HomeboiWoods/403-ecen-cobot/403/Sponsor Syncs/Sync 1 - Images/IMG_6879.JPG

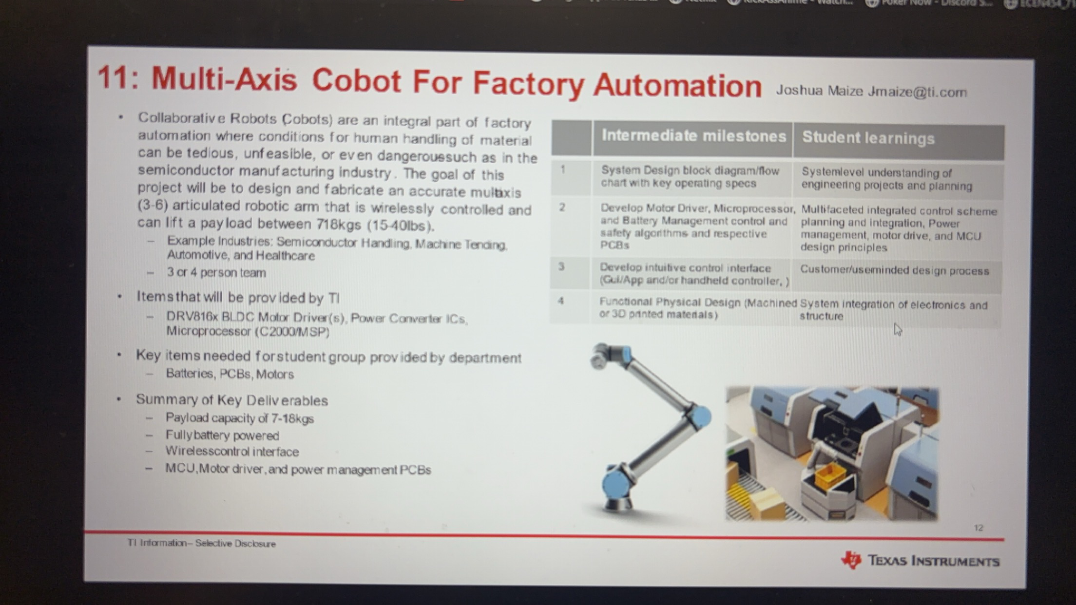
403/Sponsor Syncs/Sync 1 - Images/IMG_6879.JPG
