HomeboiWoods/403-ecen-cobot/README.md

# README.md

Howdy, this is ECEN 403/404 Team 42's Github Repository for the Multi-Axis Cobot for Factory Automation Capstone Project
