HomeboiWoods/403-ecen-cobot/404/Documents/Final Report/403 Final Report, Team 42.docx

42: Multi-Axis Cobot For Factory Automation

Adrian Guzman, Emily Hamsa, Ethan Woods, Jaishil Shah

CONCEPT OF OPERATIONS

REVISION – 2

5 December 2024

CONCEPT OF OPERATIONS

FOR

42: Multi-Axis Cobot For Factory Automation

TEAM <42>

APPROVED BY:

_____________________________

Project Leader Date

_____________________________

Prof. Kalafatis Date

_____________________________

T/A Date

I

Concept of Operations Revision - 1

42: Multi-Axis Cobot For Factory Automation

Change Record

Rev. | Date | Originator | Approvals | Description
0 | 9/12/2024 | All Members | All Members | Draft Release - Revision 0
1 | 9/26/2024 | All Members | All Members | Changed MCU selection in Section 3.6
2 | 12/5/2024 | All Members | All Members | Updated team name to 42

II

Concept of Operations Revision - 1

42: Multi-Axis Cobot For Factory Automation

1.1.

1.2. Table of Contents

Table of Contents III List of Tables IV Table 1 - Cobot Segment Degrees of Rotation 3 Table 2 - Cost Analysis 5 List of Figures IV Figure 1 - Multi-Axis Cobot Block Diagram 2 Figure 2 - Cobot Prototype Diagram 3 Figure 3 - Subsystem Flow Chart 6 1. Executive Summary 1 2. Introduction 1 2.1. Background 2 2.2. Overview 2 2.3. Referenced Documents and Standards 4 3. Operating Concept 4 3.1. Scope 4 3.2. Operational Description and Constraints 4 3.3. System Description 5 3.4. Modes of Operations 6 3.5. Users 6 3.6. Support 7 4. Scenario(s) 7 4.1. Transporting and Using Small Objects or Tools 7 4.2. Unpredictable Factory Environment 8 5. Analysis 8 5.1. Summary of Proposed Improvements 8 5.2. Disadvantages and Limitations 9 5.3. Alternatives 9 5.4. Impact 9

III

Concept of Operations Revision - 1

42: Multi-Axis Cobot For Factory Automation

1.3. List of Tables

Table 1 - Cobot Segment Degrees of Rotation 3 Table 2 - Cost Analysis 5

1.4. List of Figures

Figure 1 - Multi-Axis Cobot Block Diagram 2 Figure 2 - Cobot Prototype Diagram 3 Figure 3 - Subsystem Flow Chart 6

IV

Concept of Operations Revision - 1

42: Multi-Axis Cobot For Factory Automation

2. Executive Summary

In many manufacturing industries, safety and efficiency are critical to ensure a smooth operation within a fabrication facility (fabs) or working environment. Fabs have heavy machinery and moving parts, making it difficult for humans to access certain places. To aid the workforce, collaborative robots (cobots) are deployed within factories allowing human control from safe distances. Cobots range in size, and application, and help streamline processes within manufacturing. This solution will protect human lives and reduce inefficiencies in labor by eliminating the process of entering a hostile or hazardous work environment.

This project aims to develop a multi-axis collaborative robot (cobot) that replaces manual human intervention with remote control, reducing the risk of injury and fatigue while improving efficiency in factory settings. The cobot will assist with light tasks such as lifting small loads (1-2 lbs), transporting items between locations, and providing precise movement control through a wireless app. Key software tools for the design and development include Altium, CCStudio, AutoCAD, and VSCode (with Swift). The cobot's hardware will feature a C2000x MCU and multiple B161x motor drivers to ensure reliable operation.

Versatility is a big focus of the cobot’s design, and thus we are including the ability to lift a small object or lightweight box using the pincher arm. The cobot will be battery-powered with rechargeable batteries, with a voltage supply range of 24-48V. Additionally, a wireless app will be developed for precise control of the cobot’s movements. To maximize its range of motion, the cobot will contain 5 axes of rotation supporting both 180° and 360°. Internally, the cobot will be driven through TI’s best-in-class C2000™ MCUs, power ICs, and motor drivers, ensuring precise motor control.

3. Introduction

Factories and commercial industries use cobots to perform tasks that are unsafe and require numerous movements that would be considered strenuous for humans. Thus, the goal of this cobot is to make the production process safer and more efficient. For this project, we are developing a multi-axis cobot that will facilitate the movement of different loads across a factory or commercial setting. The cobot will be wirelessly connected using a mobile device, battery-powered, and support loads of 1-2 lbs. Considering that many warehouses have safety regulations and guidelines to follow, this cobot is designed with many of these in mind. Thus, this project’s main focus is to develop an operational cobot that could be placed in a factory setting to complete tasks safely and in a time-oriented manner.

1

Concept of Operations Revision - 1

42: Multi-Axis Cobot For Factory Automation

3.1. Background

Collaborative robots, also known as cobots, are a crucial component in factory settings where safety is at the utmost priority and manual labor is considered too dangerous. By having the cobot function through remote control, we can increase the safety and efficiency of workers in these industrial settings, where small tasks could be performed by these cobots rather than human workers. This project aims to develop a multi-axial cobot that can lift a load of 1-2 lbs through a wireless connection.

3.2. Overview

1. Designing a block diagram and flow chart including the key operating specifications. 2. Develop the motor driver, microprocessor, power supply, and battery management control with safety systems, and respective PCBs for each.

3. Develop a user interface to control the cobot in the form of a wireless app. 4. Develop the physical design of the cobot, including the machine and any 3D-printed parts.

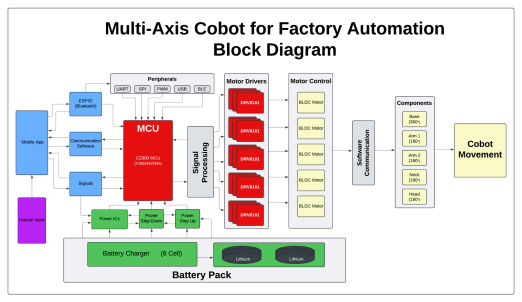
[picture p7: figure]

3.3. Figure 1. Multi-Axis Cobot Block Diagram

2

Concept of Operations Revision - 1 42: Multi-Axis Cobot For Factory Automation

Segment Piece | Degree of Rotation
Base | 360°
Arm 1 | 180°
Arm 2 | 180°
Neck | 360° or 180°
Head | 180°

3.4.

3.5.

3.6. Table 1. Cobot Segment Degrees of Rotation

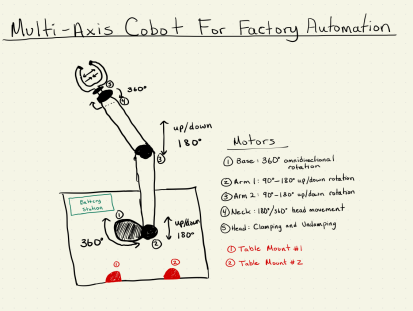
[picture p8: figure]

3.7. Figure 2. Cobot Prototype Diagram

3

Concept of Operations Revision - 1

42: Multi-Axis Cobot For Factory Automation

3.8. Referenced Documents and Standards

Project Outline: Project Description

MCU Documentation

1. C2000 MCU Documentation: F280049CPZS

2. C2000 Evaluation Module: LAUNCHXL-F280049C - EVM (C2000 Evaluation Module)

Motor Driver Documentation

DRV816x Motor Driver Documentation: DRV816x 100V Half-Bridge Smart Gate Driver DRV8161 Evaluation Module: DRV8161 EVM

Wireless Control Documentation

ESP 32 Documentation: ESP 32 Technical Reference Manual

Swift Programming Course: Swift Programming Fundamentals

Motor Documentation - TBD

Battery Documentation - TBD

Physical Design Documentation - TBD

Standards Documentation - TBD

4. Operating Concept

4.1. Scope

This project involves the design and fabrication of a human-controlled, multi-axis collaborative robot (cobot) for use in a variety of manufacturing and commercial environments. The cobot will assist employees by improving efficiency in both strenuous tasks, such as moving boxes, and precise tasks, like handling small loads and assembling items. Operated remotely and equipped with a pincher-style head, it is designed to enhance productivity in diverse settings, performing repetitive and labor-intensive duties that benefit from human oversight and precision.

4.2. Operational Description and Constraints

The cobot will work wirelessly in commercial industries as well as factory settings performing tasks such as moving boxes and small loads, and the operator will use an app to control the cobot. The claw attachment will be used for precise tasks such as moving small objects and loading boxes, as well as moving small boxes between locations. It will move on multiple axes, ranging from 180 degrees to 360 degrees of rotation at each joint, and will be powered by a rechargeable battery.

One constraint of this project is the weight constraints on the load the cobot can lift. The design is only specified to operate in lifting loads up to 2 pounds. The radius of its reach is another constraint, as it will only be able to reach 2 feet from its base. Design

4

Concept of Operations Revision - 1

42: Multi-Axis Cobot For Factory Automation

constraints will also need to be accounted for. There is a limited budget of $400, and a limited time frame to complete the design.

This cobot has applications in many industries, including the semiconductor, automotive, medical industries. This cobot could be modified to lift and move wafers in a semiconductor clean room setting. Being able to lift boxes would aid employees in the automotive field when building cars, and would be able to precisely move and place lighter metal parts. In the medical industry, the cobot would be able to use its precision for moving small tools such as tweezers or scalpels, assisting doctors during surgery.

Product | Quantity | Cost
EVM Board (MCU) | 2 | $78.00
Microprocessor Unit | 2 | $17.89
Bluetooth Driver | 1 | $19.99
EVM Board (Motor Drivers) | 1 | $229.00
Motor Driver Chip | 5 | $5.66
Anti Static Wrist Strap | 2 | $13.98
Robotic Arm Pincher | 1 | $26.99
SUM: | | $391.51

4.3. Table 2. Cost Analysis (To be updated)

4.4. System Description

The system will be split into four subsystems: power and battery management, MCU and processing design, wireless connectivity and interface development, and motor driving system design. The physical construction of the cobot will be divided amongst team members equally in a 25% share.

The power and battery management system covers the design of the power PCB which will deliver power to the motor drivers, motors, MCU, Bluetooth systems, and other electrical components. On the battery management side, this system will cover the selection of a battery and the design of a battery charger. This system will also account for possible faults and implement safeguards to protect the system.

The MCU and processing subsystem are responsible for the MCU PCB design, ESP32 Bluetooth integration, and communication between the MCU and motor driver. This subsystem will use Altium to design schematics and build physical hardware using the C2000 MCU. Furthermore, the MCU/Processing & Motor Driving subsystems will work closely to align on signal communication between the MCU and motor driver.

The wireless connectivity and interface system consists of a mobile application and a Bluetooth connection that allows communication between the cobot and the device sending in the inputs. The mobile application will be developed using Swift and will be compatible with any iOS device, including iPad and iPhone. It will allow the user to control all movements seamlessly and wirelessly. The Bluetooth driver, an ESP-32, will connect

5

Concept of Operations Revision - 1

42: Multi-Axis Cobot For Factory Automation

directly to the MCU and allow the C2000 to take the inputs from the mobile device and convert them into outputs performed by the cobot. Since we are using a Bluetooth interface, the multi-device connection is compatible and allows any device to connect.

The motor driving design system will create the motor and motor driver PCB. This system will also create the signals needed to effectively operate the motors, which will be Brushless DC (BLDC) motors. This system will achieve the operation of two motors, a 360° and 180° motor controlled by the 8161x TI Motor Drivers. The motor drivers will read a signal from the C2000 MCU and spin/rotate as needed based on the signal. This will all be driven through the B161EVM before integration.

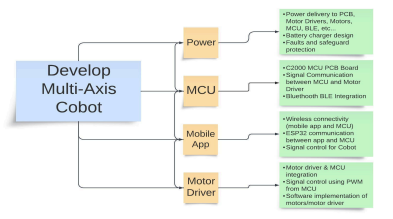
[picture p9: figure]

4.5. Figure 3. Subsystem Flow Chart

4.6. Modes of Operations

The cobot operates in three distinct modes. In the first mode, it uses its pincher to handle and pick up smaller objects in areas where employees may be present, though their presence is not required as the cobot is remotely controlled. The second mode involves lifting, moving, and placing down objects or boxes, as well as tasks such as using tools or adding items to boxes. The third mode is the charging state, where the cobot recharges its power.

4.7. Users

The target user for this cobot is a factory employee who performs redundant, strenuous tasks such as moving boxes from one place to another, transferring small objects, working with small tools, and loading boxes. These employees will benefit from using the cobot as they will be able to stay outside of dangerous areas to operate the cobot, removing the need to follow protocols to enter. Users will also be able to operate this cobot in areas amongst other employees to complete tasks like moving small loads and boxes.

6

Concept of Operations Revision - 1

42: Multi-Axis Cobot For Factory Automation

Training will be required to use this cobot. Basic UI training will need to be completed to understand the functionality of the app, as well as training on using the Bluetooth features. Safety training will also be required to ensure standards are met for using a cobot in a factory setting. Understanding the cobot’s thresholds, such as weight limits, is another important piece of training that will be needed before the operator can begin using the cobot. If the operator plans to use the cobot in areas with other employees, additional training regarding the safety of operation amongst humans may be required to ensure safety on the factory floor.

4.8. Support

Operators will be given a “crash course” on using the mobile application. In-person training on safety standards and operating conditions will also be provided, which will include weight management, operating radius, axis movement, claw operation, and other operating constraints. Operation in areas with other employees will also require additional training. Training on how to repair any damage to the equipment will be provided, as well.

5. Scenario(s)

5.1. Transporting and Using Small Objects or Tools

In this scenario, the cobot will be used in an environment where it will have the ability to operate in freedom alongside other human workers, with the goal of moving a small, lightweight object from one location to another. As the cobot is human operated, the primary objective is to transport the item without damaging or breaking it. The human operator must also be aware of the surroundings within the working environment in the case of external human intervention.

The cobot will be equipped with a set of pinchers or clamps with rubber pads attached to the end. It will be able to handle these objects with precision and full range of motion as it lifts the item up. The items the cobot can handle range from 1-2 pounds, such as light tools, food items, loose parts, and small plastic pieces.

The cobot has a hard time picking up flat items using its clamps, so the items would already be upright and ready to grab by the operator. Once picked up, the operator would be able to freely move the object with 360° of rotation and place it down or use the item at a secondary location, within the range of the cobot. This could be as easy as moving an object from one place to another to placing small objects inside bigger boxes.

From an operational point of view, a human operator will control the robot via remote control, responsible for all aspects of its movement and functionality. This includes tasks such as placing and charging the battery, as well as ensuring precise control during the cobot’s movements. As the cobot is not autonomous, it requires a skilled human operator to handle the objects with the necessary precision and accuracy they need, alongside constant monitoring of the surroundings around the cobot, as to not injure or interfere with other workers.

7

Concept of Operations Revision - 1

42: Multi-Axis Cobot For Factory Automation

5.2. Unpredictable Factory Environment

In this scenario, the cobot will be used in an environment where working conditions are dangerous for humans, such as hazardous and high-risk spaces. The cobot is human-operated, allowing for the pickup and placement of small, lightweight objects in areas where humans cannot operate safely.

The cobot will be equipped with pinchers or clamps that have rubber pads attached to the ends, allowing it to handle items with precision and care. These objects, weighing between 1-2 pounds, could include small objects that are potentially hazardous to humans. The cobot would struggle with flat items on a surface, so ideally the items are positioned upright already.

Once the object is picked up, the cobot can be rotated 360°, giving the operator full control to transport the item to another location or use it within the workspace. Tasks may range from moving items from one place to another, placing them in larger containers, or completing small assembly tasks. The human operator is responsible for controlling all aspects of the cobot’s movement via remote control, ensuring precise handling of objects and monitoring the surroundings to avoid accidents or collisions.

The cobot is not autonomous and relies entirely on a skilled human operator who ensures that tasks are performed safely and efficiently. This operator also manages the cobot's battery charging, positioning, and any other maintenance required to keep it operational. The use of the cobot in this environment significantly reduces risks for human workers while maintaining the efficiency needed for object handling tasks in hazardous conditions.

6. Analysis

6.1. Summary of Proposed Improvements

The multi-axis collaborative robot (cobot) introduces significant enhancements in safety, efficiency, and cost-effectiveness within warehouse and factory environments. By integrating a wireless user interface, the system minimizes direct human involvement, prioritizing worker safety and reducing potential hazards. The cobot’s ability to operate with five degrees of rotation enables it to handle and move objects weighing up to 2 lbs with high precision and efficiency. This capability streamlines repetitive tasks, reduces manual labor, and enhances overall operational productivity. Additionally, the cobot’s design contributes to cost savings by optimizing task performance and reducing the need for manual intervention in potentially risky environments.

8

Concept of Operations Revision - 1

42: Multi-Axis Cobot For Factory Automation

6.2. Disadvantages and Limitations

Some limitations of our design include a carrying capacity of 1-2 lbs and an operational range of 2 feet from the base of the cobot. Additionally, due to the size and shape of our pincher mechanism, objects that are flat with little height off the ground will not be supported by the cobot. Since we are catering to industries which may have limited factory space, the range of motion must be precise in order to prevent damage to warehouse equipment and the cobot. One disadvantage of our design is the power supplied to the cobot. Since we are not connecting this machine to direct power but rather connecting a battery, the usage of the cobot will be limited to the duration of the 8-cell battery and the extra rechargeable batteries. To utilize the machine after a full day of use, the batteries must be recharged and plugged back into the machine.

6.3. Alternatives

Some alternate solutions we proposed include a physical controller and a combined cobot head that incorporates a hook and a pinching mechanism. With the physical controller, the benefit is that it would be easier to use, however, the drawbacks are lengthy enough to conclude that it is an inefficient proposition. With a dedicated controller with physical analog inputs, there would be a level of management of the signal interference that is avoided with the mobile application. Additionally, the mobile application allows many devices to communicate with the cobot, as well as being able to connect to different cobots. The final drawback of the physical controller is that if the device gets damaged, replacing or fixing it would be very costly. With a mobile application, releasing a software patch to fix any bugs lowers cost as well as time to resume functionality. The other alternative would be creating one cobot head with the hook and pincher attached. The issue with this solution is that it is not as professional in design, and does not display the versatility of the cobot in a consumer-friendly manner. Additionally, the hook is capable of damaging delicate parts that a dedicated rubber-headed pincher is capable of safely transporting.

6.4. Impact

The multi-axis collaborative robot (cobot) is designed to enhance operational efficiency and safety within manufacturing and commercial environments. By allowing human operators to control the cobot remotely, it reduces the physical strain and risk associated with repetitive or demanding tasks, such as moving objects and loading items. This shift not only minimizes the risk of worker fatigue and injury but also optimizes task precision and productivity.

Moreover, the cobot contributes to a safer work environment by performing tasks that could otherwise expose employees to hazardous conditions. Its presence in factory and warehouse settings helps maintain a safer operational environment by enabling workers to manage and control the cobot from a distance. This approach supports overall improvements in workplace ergonomics and efficiency, making it a valuable asset for modern manufacturing and commercial operations.

9

42: Multi-Axis Cobot For Factory Automation

Adrian Guzman, Emily Hamsa, Ethan Woods, Jaishil Shah

INTERFACE CONTROL DOCUMENT

REVISION – 1

5 December 2024

1

INTERFACE CONTROL DOCUMENT

FOR

42: Multi-Axis Cobot For Factory Automation

PREPARED BY:

_____________________________

Author Date

APPROVED BY:

_____________________________

Project Leader Date

_____________________________

John Lusher II, P.E. Date

_____________________________

T/A Date

I

Interface Control Document Revision - 1

42: Multi-Axis Cobot For Factory Automation

Change Record

Rev . | Date | Originator | Approvals | Description
0 | 9/26/2024 | All Members | All Members | Draft Release - Revision 0
1 | 12/5/2024 | All Members | All Members | Updated error in team name, team 11 to team 42

II

Interface Control Document Revision - 1

42: Multi-Axis Cobot For Factory Automation

Table of Contents

Table of Contents III List of Tables IV Table 1: References 1 Table 2: Weight of Cobot Components 2 Table 3: Weight of Battery Management Components 2 Table 4: Motor Driving Subsystem Dimensions 3 Table 5: MCU and Signals Processing Subsystem Dimensions 3 Table 6: Power and Battery Management Subsystem Dimensions 3 Table 7: Wireless Communication Subsystem Dimensions 4 Table 8: Maximum Voltage, Current, and Power Levels 7 Table 9: Typical Operating Voltage, Current, and Power 7 List of Figures III Figure 1: Electrical Interface Diagram 5 1. Overview 1 2. References and Definitions 1

2.1. References 1 2.2. Definitions 1 3. Physical Interface 2 3.1. Weight 2

3.1.1. Weight of Cobot Apparatus 2 3.1.2 Weight of Battery Management 2 3.2. Dimensions 3 3.2.1. Dimension of Motor Driving Subsystem 3 3.2.2. Dimension of MCU/Processing Subsystem 3 3.2.3. Dimension of Power/Battery Management Subsystem 3 3.2.4. Dimension of Wireless Communication Subsystem 4 3.3. Mounting Locations 4 3.3.1. Motor Mounting 4 3.3.2. Cobot to Base Mounting 4 3.3.3. Base to Table Mounting 4 4. Thermal Interface 5 5. Electrical Interface 5 5.1. Primary Input Power 6 5.1.1. Primary Power Source for Cobot 6 5.1.2. Battery Charging 6 5.1.3. Microcontroller 6 5.2. Signal Interfaces 6

III

Interface Control Document Revision - 1

42: Multi-Axis Cobot For Factory Automation

5.2.1. DRV8161 Pulse Width Modulation Signals 6 5.2.2. Digital Signals Between Mobile App and Cobot 6 5.3. User Control Interface 6 5.4. Voltage and Current Levels 7 5.4.1. Maximum Voltage and Current 7 5.4.2. Typical Voltage and Current 7 6. Communications / Device Interface Protocols 8 6.1. Wireless Communications (WiFi) 8 6.1.1. Bluetooth 8 6.2. Host Device 8 6.2.1. C2000 Microcontroller Unit (MCU) 8 6.3. Device Peripheral Interface 8 6.3.1. ESP-32 Connection with User Interface 8 6.3.2. Motor Driver and Motor Communication 8 6.3.3. Micro-USB 8

III

Interface Control Document Revision - 1

42: Multi-Axis Cobot For Factory Automation

List of Tables

Table 1: References 1 Table 2: Weight of Cobot Components 2 Table 3: Weight of Battery Management Components 2 Table 4: Motor Driving Subsystem Dimensions 3 Table 5: MCU and Signals Processing Subsystem Dimensions 3 Table 6: Power and Battery Management Subsystem Dimensions 3 Table 7: Wireless Communication Subsystem Dimensions 4 Table 8: Maximum Voltage, Current, and Power Levels 7 Table 9: Typical Operating Voltage, Current, and Power 7

List of Figures

Figure 1: Electrical Interface Diagram 5 IV

Interface Control Document Revision - 1

42: Multi-Axis Cobot For Factory Automation

1. Overview

This document provides an overview of the integration between the different subsystems. The four subsystems are split into power, MCU/processing, wireless, and motor driving. The power subsystem will deliver accurate power to components, MCU/processing will ensure signals are sent from MCU, wireless will communicate with the cobot via Bluetooth, and motor driving will create motor movement. In this document, you will find the necessary system requirements to achieve this integration for the cobot. This document includes necessary references and definitions as well as physical, thermal, and electrical interfaces.

2. References and Definitions

2.1. References

Document Number | Revision/Release Date | Document Title
IEEE 802.15 | June 2005 | IEEE Standard for Information Technology
TMS320F28004x | January 2023 | TMS320F28004x Real-Time Microcontrollers
DRV816x | July 2024 | DRV816x 100V Half-Bridge Smart Gate Driver with Integrated Protection and Current Sense Amplifier
ESP-32 | September 2024 | ESP-32 Series

Table 1: References

2.2. Definitions

Cobot Collaborative Robot

MCU Microcontroller Unit

mA Milliamp

mW Milliwatt

in Inch

lb Pound

PCB Printed Circuit Board

PMS Power Management System

TBD To Be Determined

V Volt

1

Interface Control Document Revision - 1

42: Multi-Axis Cobot For Factory Automation

3. Physical Interface

3.1. Weight

3.1.1. Weight of Cobot Apparatus

This section covers the weight of physical components and the design of the cobot. Encompassed in this section are the motor driving subsystem, MCU and processing subsystem, power management subsystem, and wireless communication subsystem. While we have not confirmed exact weights, we roughly estimate the cobot apparatus will weigh 10 pounds, not including the physical design and base.

Component | Weight | Number of Items | Total Weight
Motors | ~ .4lb - 2.6lb | 5 | TBD
Motor Drivers | ~ 0.22lb | 15 | TBD
Pincher | 0.121lb | 1 | 0.121lb
ESP-32 | 0.121lb | 1 | 0.121lb
Physical Design and Base | TBD | 1 | TBD
Associated PCB’s | TBD | TBD | TBD

Table 2: Weight of Cobot Components

3.1.2. Weight of Battery Management

The battery management system is weighed separately because, in the final design, the battery and its charging system will be removable. While we have not confirmed exact weights, we roughly estimate the battery management system will weigh 4 pounds.

Component | Weight | Number of Items | Total Weight
Battery | ~4lb | 1 | ~4lb
Associated PCB’s | TBD | TBD | TBD

Table 3: Weight of Battery Management Components

2

Interface Control Document Revision - 1

42: Multi-Axis Cobot For Factory Automation

3.2. Dimensions

3.2.1. Dimension of Motor Driving Subsystem

Each motor will have different specifications. For each motor to function, it will have a PCB with 3 DRV8161 Motor Drivers. We estimate the PCB alongside each motor will be at least 1.18 inches by 1.18 inches.

Component | Length | Width | Height
Motors | ~ 1.57 - 3.15in | ~ 1.18 - 3.15in | ~ 1.57 - 3.94in
Motor Drivers | ~ 0.2in | ~ 0.12in | TBD
Associated PCB’s | ~ 1.18in | ~ 1.18in | TBD

Table 4: Motor Driving Subsystem Dimensions

3.2.2. Dimension of MCU/Processing Subsystem

The MCU subsystem will consist of a PCB that holds the F280049CPZS microcontroller which has dimensions 0.63 inches by 0.63 inches. Furthermore, with other ICs and passive components integrated into the PCB, we estimate it will be at least 3.94 inches by 3.94 inches.

Component | Length | Width | Height
F280049CPZS | ~ 0.63in | ~ 0.63in | TBD
Associated PCB’s | ~ 3.94in | ~ 3.94in | TBD

Table 5: MCU and Signals Processing Subsystem Dimensions

3.2.3. Dimension of Power/Battery Management Subsystem

The power and battery management subsystem envelops the battery, which we estimate will be 48 volts, alongside the PCBs that are needed to run the PMS. We estimate the battery will be around 10.63 inches by 3.15 inches by 2.76 inches and the PCBs needed will be around 3.34 inches by 3.34 inches.

Component | Length | Width | Height
Battery | ~ 10.63in | ~ 3.15in | ~ 2.76in
Associated PCB’s | ~ 3.34in | ~ 3.34in | TBD

Table 6: Power and Battery Management Subsystem Dimensions

3

Interface Control Document Revision - 1

42: Multi-Axis Cobot For Factory Automation

3.2.4. Dimension of Wireless Communication Subsystem

The wireless communication subsystem is built around an ESP-32 board. The ESP-32 typically comes in size 0.71 inches by 1.00 inches by 0.12 inches. Including the size of the ESP-32 board and associated ICs, we estimate the dimensions of the PCB will be 2.76 inches by 2.76 inches.

Component | Length | Width | Height
ESP-32 | ~ 0.71in | ~ 1.00in | ~ 0.12in
Associated PCB’s | ~ 2.76in | ~ 2.76in | TBD

Table 7: Wireless Communication Subsystem Dimensions

3.3. Mounting Locations

3.3.1. Motor Mounting

Each motor will need to be mounted and secured to the robotic arm apparatus. To prevent sag and weight issues, the mountings will have to be strong enough to support the weight of the motor under maximum load.

3.3.2. Cobot to Base Mounting

To ensure a strong center of gravity when lifting and moving a payload, the bottom (Base) of the cobot will be mounted to a baseboard or metal sheet. This allows for the cobot to have a designated location on a square surface to support the weight of the robotic arm with and without a load. By securing the cobot to a base plate, we can better control the lean and influence the movement of the cobot on its center of gravity.

3.3.3. Base to Table Mounting

To ensure the cobot does not tip over if its center of gravity changes, the base plate the cobot is mounted to will also be mounted to a table. The base plate can clamp onto the outside lip of the table it is placed on, which ideally means the table size is the size of the base plate. By clamping the base plate to the table, we eliminate the center of gravity changing due to the base plate lifting and leaning during movement.

4

Interface Control Document Revision - 1

42: Multi-Axis Cobot For Factory Automation

4. Thermal Interface

Our project involves working with high voltage and current, which means cooling will be essential for the PCBs, motors, and other components to prevent overheating. Depending on the power draw and consumption, many of these parts will require adequate thermal management. Since the cobot is not designed for continuous operation over extended periods, a heatsink in the form of a metal heat dissipation plate, along with proper airflow, should be sufficient to maintain safe operating temperatures.

While a cold wall isn’t necessary due to the intermittent operation of the system, heatsinks will still be required for most, if not all, of the motors in the robotic arm. These motors, subjected to high voltage and current, will generate heat more rapidly than lower-power alternatives. However, given the cobot's non-continuous, human-triggered operation, we believe that proper ventilation and airflow should be enough to manage any potential heat issues, even with the higher power motors.

In summary, the use of simple metal heat dissipation plates combined with adequate ventilation should address all thermal concerns without the need for more complex cooling solutions like a cold wall.

5. Electrical Interface

Provide details on the electrical interface. Examples are:

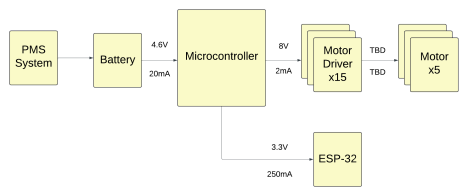
[picture p10: figure]

Figure 1: Electrical Interface Diagram

5

Interface Control Document Revision - 1

42: Multi-Axis Cobot For Factory Automation

5.1. Primary Input Power

5.1.1. Primary Power Source for Cobot

All power for the cobot will be supplied by an external, rechargeable battery. The voltage rating for the battery is 48V, and the amp-hour specification is currently TBD as we are finalizing parts selection. Our battery will be connected to a battery management system, which will include regulators and buck converters to deliver power to all subsystems in the required amounts.

5.1.2. Battery Charging

Our team will also be developing a charging unit for the battery. Because we are using a large, multi-cell battery, this system will include safeguards and associated components to ensure when the battery is charging, cells are charged in a balanced way, and potential faults are detected.

5.1.3. Microcontroller

The cobot will be using the F280049CPZS microcontroller from the C2000 family at Texas Instruments. This MCU has a 32-bit CPU at 100 Mhz and includes 356 KB of on chip memory. There is no BLE module, hence an ESP-32 will be required externally.

5.2. Signal Interfaces

5.2.1. DRV8161 Pulse Width Modulation Signals

The communication between the motor drivers and motors will be facilitated through 3-phase Pulse Width Modulation (PWM), utilizing a C2000 MCU to generate the necessary control signals. This setup ensures precise and efficient control over the motor phases.

5.2.2. Digital Signals Between Mobile App and Cobot

The cobot will use an ESP-32 to connect the user’s mobile app to the cobot through Bluetooth. The ESP-32 for use with Bluetooth is compliant with Bluetooth v4.2 BR/EDR and Bluetooth LE specifications, and has +9 dBm transmitting power.

5.3. User Control Interface

Users will be able to operate the cobot using a wireless mobile application that will be developed using FlutterFlow. This mobile app will include dialogs and menus which will allow the user to complete training videos and modules, connect to the cobot via Bluetooth, and receive error messages from the cobot.

6

Interface Control Document Revision - 1

42: Multi-Axis Cobot For Factory Automation

5.4. Voltage and Current Levels

5.4.1. Maximum Voltage and Current

Component | Voltage [V] | Current [mA] | Power [mW]
Motor Driver | 20 | 2 | 40
MCU | 3.3 | 20 | 92
ESP-32 | 3.6 | 250 | 900
Motors | TBD | TBD | TBD

Table 8. Maximum Voltage, Current, and Power Levels

The table above outlines the maximum ratings for voltage and current consumption of each component. Operating under maximum conditions will not be done frequently, however, it is important to take into consideration when designing safety and sizing our battery.

5.4.2. Typical Voltage and Current

Component | Voltage [V] | Current [mA] | Power [mW]
Motor Driver | 8 | 2 | 16
MCU | 3.3 | 20 | 66
ESP-32 | 3.3 | 250 | 825
Motors | TBD | TBD | TBD

Table 9. Typical Operating Voltage, Current, and Power

The table above shows a more accurate representation of the power needs of each component during operation. While most of the components are relatively low-power, we anticipate our motors will have a much larger power requirement.

7

Interface Control Document Revision - 1

42: Multi-Axis Cobot For Factory Automation

6. Communications / Device Interface Protocols

6.1. Wireless Communications (Bluetooth)

6.1.1. Bluetooth

The cobot uses Bluetooth v4.2 for wireless communication between the mobile app and the cobot's microcontroller unit (MCU). Since the C2000 MCU does not have a built-in Bluetooth module, an ESP-32 is employed for this purpose. The ESP-32 complies with the IEEE 802.15.1 standard, which ensures low-power, short-range wireless communication.

6.2. Host Device

6.2.1. C2000 Microcontroller Unit (MCU)

The C2000 serves as the primary Host Device for the cobot, as it is responsible for real-time processing and motor control. The C2000 will receive signals from the ESP-32, which communicates with the user’s controller. Then, the C2000 will generate PWM signals to send to the Motor Drivers for precise Motor control.

6.3. Device Peripheral Interface

6.3.1. ESP-32 Connection with User Interface

The ESP-32 serves as the wireless communication interface between the User Interface and the C2000. Using Bluetooth, the ESP-32 transits signals and commands from the Interface to the C2000. The communication is handled through UART.

6.3.2. Motor Driver and Motor Communication

The communication between the C2000 MCU and the motor drivers is managed through 3-phase Pulse Width Modulation (PWM) signals. These PWM signals control the motor phases to regulate speed, torque, and positioning. The C2000 MCU outputs these PWM signals directly to the motor drivers, ensuring precise control.

6.3.3. Micro-USB

A Micro-USB port will be needed to interface between the computer and the MCU. The MCU offers I2C, CAN, SPI, UART, and FSI. The communication protocol to use for micro-USB is still to be determined.

8

42: Multi-Axis Cobot For Factory Automation

Adrian Guzman, Emily Hamsa, Ethan Woods, Jaishil Shah

FUNCTIONAL SYSTEM REQUIREMENTS

REVISION – 1

5 December 2024

FUNCTIONAL SYSTEM REQUIREMENTS

FOR

42: Multi-Axis Cobot For Factory Automation

PREPARED BY:

_____________________________

Author Date

APPROVED BY:

_____________________________

Project Leader Date

_____________________________

John Lusher, P.E. Date

_____________________________

T/A Date

I

Functional System Requirements Revision - 1

42: Multi-Axis Cobot For Factory Automation

Change Record

Rev . | Date | Originator | Approvals | Description
0 | 9/24/2024 | All Members | All Members | Draft Release - Revision 0
1 | 12/5/2024 | All Members | All Members | Updated error in team name, team 11 to team 42, updated characteristics section

II

Functional System Requirements Revision - 1

42: Multi-Axis Cobot For Factory Automation

Table of Contents

Table of Contents III List of Tables IV Table 1 - Subsystem Leads 1 Table 2 - Applicable Documents 2 Table 3 - Reference Documents 3 List of Figures IV

Figure 1 - Conceptual Image of Multi-Axis Cobot 1 Figure 2 - Multi-Axis Cobot Flowchart 4 Figure 3 - Multi-Axis Cobot Block Diagram 5

1. Introduction 1 1.1. Purpose and Scope 1 1.2. Responsibility and Change Authority 2

2. Applicable and Reference Documents 2 2.1. Applicable Documents 2 2.2. Reference Documents 3 2.3. Order of Precedence 3

3. Requirements 4 3.1. System Definition 4 3.2. Characteristics 5

3.2.1. Functional / Performance Requirements 5 3.2.2. Physical Characteristics 6 3.2.3. Electrical Requirements 7 3.2.4. Environmental Characteristics 8 3.2.5. Failure Propagation 9

4. Support Requirements 10 Appendix A: Acronyms and Abbreviations 11 Appendix B: Definition of Terms 11

III

Functional System Requirements Revision - 1

42: Multi-Axis Cobot For Factory Automation

List of Tables

Table 1. Subsystem Leads 1 Table 2. Applicable Documents 2 Table 3. Reference Documents 3

List of Figures

Figure 1. Conceptual Image of Multi-Axis Cobot 1 Figure 2. Multi-Axis Cobot Flowchart 4

IV

Functional System Requirements Revision - 1

42: Multi-Axis Cobot For Factory Automation

1. Introduction

1.1. Purpose and Scope

This specification defines the technical requirements for the development items and support subsystems delivered to the client for the project. Figure 1 shows a representative integration of the project in the proposed CONOPS. The verification requirements for the project are contained in a separate Execution and Validation Plan.

Warehouse and factory settings are dangerous environments in which to work. Workers are subject to injury, burnout, and fatigue with repetitive tasks. Instead of exposing humans to these risks, we aim to provide a collaborative robot, or “cobot”, solution to improve warehouse safety and efficiency. Our cobot shall be able to move objects (1-2 lbs) via human control from one location to another. A cobot solution will perform better than a human in tedious repetitive workloads as there is a reduced chance of error. Furthermore, cobots minimize the amount of risk humans are exposed to in a factory setting. Placing a cobot in dangerous environments eliminates the chance of a human worker getting struck by heavy machinery, falling objects, or other loose objects. Given that the cobot is wirelessly controlled, human intervention is still required, however, our solution will minimize the required manpower needed to achieve a task. We hope to minimize risk within warehouse operations and improve human worker longevity.

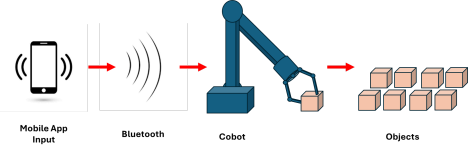
[picture p11: figure]

Figure 1. Conceptual Image of Multi-Axis Cobot

1

Functional System Requirements Revision - 1

42: Multi-Axis Cobot For Factory Automation

1.2. Responsibility and Change Authority

Every member is equally responsible for ensuring the requirements are met and will do so by reviewing deliverables when fellow team members signify their tasks have been completed. Changes proposed by any team members must be discussed with each other and the client, Joshua Maize. Responsibility will be further broken down at the subsystem level, which is outlined below in Table 1.

Subsystem | Responsibility
Power and Battery Management | Emily Hamsa
Microcontroller | Adrian Guzman
Wireless Connectivity | Jaishil Shah
Motors and Motor Drivers | Ethan Woods
Physical Design | Full Team Effort

Table 1. Subsystem Leads

2. Applicable and Reference Documents

2.1. Applicable Documents

The following documents, of the exact issue and revision shown, form a part of this specification to the extent specified herein:

Document Number | Revision/Release Date | Document Title
IEEE 802.15.1. | June 2005 | IEEE Standard for Information technology

Table 2. Applicable Documents

2

Functional System Requirements Revision - 1

42: Multi-Axis Cobot For Factory Automation

2.2. Reference Documents

The following documents are reference documents utilized in the development of this specification. These documents do not form a part of this specification and are not controlled by their reference herein.

Document Number | Revision/Release Date | Document Title
SLVSGZ1A | July 2024 | DRV816x 100V Half-Bridge Smart Gate Driver with Integrated Protection and Current Sense Amplifier
SPRS945G | January 2023 | TMS320F28004x Real-Time Microcontrollers
ESP-32 | September 2024 | ESP32 Series

Table 3. Reference Documents

2.3. Order of Precedence

In the event of a conflict between the text of this specification and an applicable document cited herein, the text of this specification takes precedence without any exceptions.

All specifications, standards, exhibits, drawings, or other documents that are invoked as “applicable” in this specification are incorporated as cited. All documents that are referred to within an applicable report are considered to be for guidance and information only, except ICDs that have their relevant documents considered to be incorporated as cited.

3

Functional System Requirements Revision - 1

42: Multi-Axis Cobot For Factory Automation

3. Requirements

This section defines the minimum requirements that the development items must meet. The requirements and constraints that apply to performance, design, interoperability, reliability, etc., of the system, are covered.

3.1. System Definition

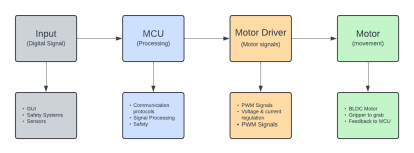
[picture p12: figure]

Figure 2. Multi-Axis Cobot Flowchart

The multi-axis collaborative robot used for factory automation is a solution to dangerous working environments for factory employees and the repetitive fatigue of monotonous tasks. This cobot will be operated via a wireless mobile app and will be powered by a rechargeable battery, allowing users flexibility to place the robot in a desired location and perform specific tasks. There will be four subsystems: power and battery management, microcontroller design, motor and motor driver design, and mobile application development.

When in use, the operator will be able to drive the motion of the cobot using the mobile application, which will be used on an iOS device. Signals sent from the app will be delivered to the cobot via Bluetooth, and we will use an ESP-32 for this functionality. The microcontroller will convert these signals into directions for the motor drivers, which will in turn deliver instructions to the motors. Using software communication, the motors will move each correlated component of the cobot. The cobot will be powered with a battery, and through the use of step-down converters, power will be delivered at the appropriate voltage and current rating to each component in the cobot. When charging, the battery management system will recharge the battery, and will include multi-cell balancing components to ensure each cell is charged to the maximum and not overloaded.

4

Functional System Requirements Revision - 1

42: Multi-Axis Cobot For Factory Automation

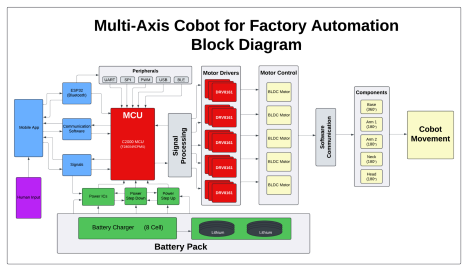
[picture p13: figure]

Figure 3. Multi-Axis Cobot Block Diagram

The cobot will also be able to send signals back to the mobile app to indicate any system errors. These errors include object detection, physical errors to motor drivers, and connection errors. Object detection will send warnings back to the user if there is an object interfering with the cobot’s movement, such as a wall. Any physical damage or operation errors pertaining to the motor drivers will be sent to the user as well, indicating that servicing the cobot may be needed. If the mobile application is unable to connect to the cobot, error messages will be sent to the user as well.

3.2. Characteristics

3.2.1. Functional / Performance Requirements

3.2.1.1 C2000 EVM Wakeup

Launch EVM and connection is successful.

Rationale: In order to program MCU, understand the EVM by using example code on CCS and other TI-provided documents.

3.2.1.2 MCU & Motor Driver

MCU is correctly created to connect with motor drivers in the schematic.

Rationale: For motor motion, MCU and motor drivers have to work together to create signals with PWM modules.

5

Functional System Requirements Revision - 1

42: Multi-Axis Cobot For Factory Automation

3.2.1.3 JTAG Programming of MCU

The MCU is able to be programmed through JTAG. This will allow flashing onto the chip.

Rationale: The C2000 MCU needs to be capable of programming through JTAG. To enable this, signals such as TDI, TDO, TCK, TMS need to be properly routed.

3.2.1.3.1 Schematic & PCB Creation for MCU/Connectivity Subsystem Schematic and PCB footprinting integrating MCU, motor drivers, and ESP32.

Rationale: Schematic and PCB design has no errors in validation. To ensure proper design of PCB the design rule check (DRC) shall come back with zero errors.

3.2.1.3.2 Schematic & PCB Creation for Motor Driver Subsystem Creating schematics for PCB boards for individual motors, 5 in total.

Rationale: To ensure proper motor control, the MCU and motor driver subsystem need to be aligned on the proper signals required for motor motion.

3.2.1.4 Precise Motor Control

Through encoders, motors will move a few degrees at a time.

Rationale: Motors need to operate with different degrees of rotation. To support the different movements, various measurements of angles each motor can support will be performed.

3.2.1.5 All Motor Movement

All motors can move through communication with the MCU and motor drivers.

Rationale: Motor functionality is an integral part of ensuring the cobot moves accurately. The motors will need to be tested various times to ensure accurate representation of output with given input via wireless app.

3.2.1.6 Schematic & PCB Creation for Power Management

Power management system PCB schematics and footprinting are fully designed in Altium.

Rationale: Power will be imputed at 48V, not all components in the cobot will be at 48V. It is important that the power management subsystem can step down to different voltages that are required at different parts of the process. This will need a PCB with different power rails.

3.2.2. Physical Characteristics

3.2.2.1 Mounting

When the system is lifting maximum payload, it stays mounted on its surface without tipping.

Rationale: The cobot will only be able to support a specific load range. More than is allowed will make the cobot fall over. To find this range, the cobot will be tested by attaching weights to the arms of the cobot, measuring the maximum payload before the system tips over.

6

Functional System Requirements Revision - 1

42: Multi-Axis Cobot For Factory Automation

3.2.2.2 System Precision

Physical movement and load capacity functionality can move objects precisely and accurately.

Rationale: The cobot should not move an object differently than is intended as it will lead to damage to the item and or cobot. Ensure that the system axes can move at a minimum of 2 degrees, and move objects 2 inches on the table.

3.2.2.3 Structure Integrity

All components and joints are structurally sound.

Rationale: So that the cobot does not collapse when under load, the maximum payload needs to be tested. The cobot should support lifting a maximum payload, the physical design can support both the weight of itself and the load.

3.2.3. Electrical Requirements

3.2.3.1. Inputs

3.2.3.1.1 Input Voltage

The battery will supply a constant 48V to the system at the input

Rationale: The battery shall give 48V to the system. By using a multimeter, test to ensure the system holds at 48 volts while the battery is connected. This is required to ensure no voltage drop-off that could impact the functionality of the cobot.

3.2.3.1.2 Battery Sizing

Choose a battery size that will adequately power the cobot based on the load list.

Rationale: In order to power the cobot properly, battery sizing using formulas and a load list to determine appropriate voltage and amp-hour sizing is required.

3.2.3.1.3 Voltage Step-Down

Power PCB will step-down voltage to the subsequent system requirements

Rationale: Different systems of the cobot will require different input and output voltages. By using a multimeter, test each voltage rail and ensure it is holding the correct voltage.

3.2.3.1.4 MCU & Bluetooth

MCU schematic is created with ESP-32 for Bluetooth connectivity

Rationale: In order for Bluetooth to work via the wireless app, the mobile app needs to be able to communicate with the MCU. The MCU and wireless subsystems shall align on requirements, all necessary signals are accounted for and communication between Bluetooth and MCU can be displayed.

3.2.3.1.5 Motor Movement

Motor Drivers can send signals to move the Motor through the MCU

7

Functional System Requirements Revision - 1

42: Multi-Axis Cobot For Factory Automation

Rationale: For accurate and rapid motion of the motor, the MCU and motor drivers need to exchange signals. To achieve this, the two subsystems must align on required signals for control, and display movement through MCU control with motor drivers and motor.

3.2.3.1.6 GUI Operational

User Interface (application) is deployed to mobile device

Rationale: To control the cobot, the wireless GUI has to be operational and send out signals via Bluetooth. Once the connection is stable, input lag is minimal, and outputs are properly received/translated.

3.2.3.1.7 C2000 MCU Input from ESP-32

The C2000 is able to receive input from ESP-32 via toggling of high/low GPIO pins. Rationale: To control the cobot, the ESP-32 will need to send high/low signals to the C2000. The C2000 will then receive these signals to output the required PWM waveform.

3.2.3.1.8 Button Functionality

The button will respond to human input and send digital output

Rationale: The cobot will be controlled via a wireless app. The app needs to be able to accept human input so that signals can be sent to the cobot and output can be visualized. This will lead to human interaction that works without fault.

3.2.3.2. Outputs

3.2.3.2.1 LED Program

After PCB assembly, flash the MCU and perform the LED light blinking program to ensure it is working.

Rationale: To demonstrate understanding of C2000 controls, software, and signals the C2000 EVM will be used. The CCS GUI with TI-provided software will help develop code that functions on the EVM. Once the EVM development is successful, this code can be replicated onto the created PCB for the MCU subsystem. Programming the MCU is an important part of achieving cobot functionality. In the end, an LED blinking on the board will confirm functionality.

3.2.3.2.2 Wireless Connectivity and Connection to MCU

Mobile application connects to the ESP-32 ad C2000 MCU.

Rationale: The mobile app is the main form of communication with the cobot. It is important to not lose connection and therefore we must test that the connection does not drop out more than 1 time in 5 minutes while also connecting within 30 seconds.

3.2.3.2.3 PWM Phase Output from Motor Drivers

The Motor Drivers can output Phase Signals which will be used to drive the Motors

Rationale: To be able to actually move a 3-Phase BLDC Motor, there must be 3 separate PWM Phases, each generated by 1 Motor Driver. By showing we can output one Phase Signal from a motor driver, we can say we can theoretically output 3 as well.

8

Functional System Requirements Revision - 1

42: Multi-Axis Cobot For Factory Automation

3.2.3.2.4 MCU to Motor Driver Output

MCU is correctly created to connect to the motor drivers in the schematic.

Rationale: To ensure proper communication between the motor driver and MCU, the schematic on Altium must be created with zero DRC errors. Furthermore, the two subsystems must Align to ensure signals are being sent properly to show motor movements.

3.2.3.2.5. Output DC Voltage

The power management and supply PCB will output a DC voltage with minimal noise.

Rationale: To ensure the cobot components are working correctly, it is important that they are receiving the correct and expected voltage, which is a DC voltage value.

3.2.3.2.6 MCU Generates PWM Signals

MCU can generate PWM signals from GPIO Pins, these will be sent to the motor driver. Rationale: For motor motion, the MCU needs to be capable of generating PWM signals.

3.2.4. Environmental Characteristics

3.2.4.1 Warehouse and Factory Safety Considerations

Ensure the surface that the cobot is stationed on is able to support at least 30 pounds so that it can sufficiently hold the cobot’s weight, and that the surroundings are clear of items that could potentially be damaged by the cobot’s movement.

Rationale: The cobot should not damage the environment it is placed in. Test the weight limit of the surface using weights that total 30 pounds and use a ruler to measure the radius of movement of the cobot, checking if there are damageable items in its path.

3.2.4.1 Delicate Material (Handle with Caution)

The cobot is able to lift and handle delicate items without causing them any physical damage.

Rationale: The cobot shall not break anything it picks up. If objects are broken when being lifted, the purpose of the cobot is defeated. Cobot shall pick up a delicate item, such as a cracker or an object that has surfaces that could be easily punctured, and move from one location to another. Ensure there is no physical damage to the delicate item.

3.2.5. Failure Propagation

3.2.5.1 Object Detection in Factory Setting

If part of the cobot’s arm, head, or other components is turning or moving into a surface, such as a wall, that is restricting the movement of the cobot, an error message will be sent to the user’s mobile application.

Rationale: In a factory setting, many objects are moving around. The cobot should not damage any other objects and will send warning messages to the user if movement can not be continued. Using the controller, turn the cobot into a wall so that it is unable to continue turning, and ensure an error message is sent to the user through the mobile application.

9

Functional System Requirements Revision - 1

42: Multi-Axis Cobot For Factory Automation

3.2.5.2 Physical Errors with Motor Drivers

If there is physical damage detected to the motor drivers that is inhibiting the cobot to function correctly, an error will be sent to the user’s mobile application.

Rationale: To work the user of potential faults, the motor driver will give the user a warning if an error has been detected. Such errors can include physical damage, object obstruction, or low battery.

3.2.5.3 Connection Errors

If the mobile app is not able to connect to the cobot, or the mobile app loses connection to the cobot, an error message will be sent to the user’s mobile application.

Rationale: Connection should be constant from wireless app to cobot. If connection drops, danger can occur and humans no longer have control of the cobot. To prevent this, error messages will be sent to the user via mobile app.

3.2.5.4 C2000 Error Detection System Functionality

Any errors that the cobot or MCU detects will send a signal to the ESP-32 for the mobile application to receive.

Rationale: Signal detection using the MCU and ESP-32 is implemented to give human warning. The error message will display on the mobile application so that the user is made aware and the error or faulty use can be corrected.

4. Support Requirements

4.1 iOS Device Compatibility

The device is required to run the latest version of iOS to run this application. (9/24/24: iOS 18.0) Make sure that bluetooth is on and other devices are disconnected prior to device setup.

Rationale: The mobile app will be placed on the app store for user download. The user must have the latest iOS versions to comply with mobile applications. It is recommended to have the battery on the phone at full charge so that the connection will not drop if the phone dies.

4.2 Surface Preparation

Before placement of the device onto the workstation, make sure to clear the area and make sure the clamp is secure onto the surface.

Rationale: The device should be placed on a clean flat surface. If this is not done, risk of short circuit or other damage can be caused. Ensure that all liquids, hazardous material, and

10

Functional System Requirements Revision - 1

42: Multi-Axis Cobot For Factory Automation

sharp or dangerous objects are either relocated or placed in an area that is outside the range of the cobot.

4.3 Device Warranty and Replacement

This device contains parts manufactured by Texas Instruments and individually designed components.

Rationale: As the sponsor of the project, Texas Instruments devices should go into this cobot. To replace TI parts, directly contact Texas Instruments. In order to replace any individually designed parts, contact the Multi-Axis Cobot Design Team.

4.4 Training Requirement

Please ensure all technicians complete training and have been given warehouse/factory instruction on what the machine is being utilized for.

Rationale: In order to access the device connection and control on the mobile application, the user must complete the training and watch the safety demonstration.

4.5 Electrical Safety

Make sure all batteries, wires, and electrical components are secure and not in the range of the cobot’s movement.

Rationale: The Multi-Axial Cobot Design Team is not responsible for any damage, harm, or injury caused in the workplace. Please understand that all responsibility falls upon the user.

4.6 Human Safety

Do not operate the device if humans are within 5 feet of the cobot.

Rationale: As previously stated, any harm caused in the workplace due to the cobot falls on the user of the device. Ensure all technicians understand their responsibility and are aware of the preventative measures.

Appendix A: Acronyms and Abbreviations

TI Texas Instruments

IEEE Institute of Electrical and Electronics Engineers

iOS iPhone Operating System

CCS Code Composer Studio

LED Light-Emitting Diode

PCB Printed Circuit Board

DRC Design Rule Check

MCU Micro-Controller

ESP-32 Espressif32 Bluetooth Driver

C2000 (TI) Microcontroller

GUI Graphical User Interface

DRC Design Rule Checking

EVM Evaluation Module

PWM Pulse Width Modulation

BLDC Brushless Direct Current

11

Functional System Requirements Revision - 1

42: Multi-Axis Cobot For Factory Automation

ICD Interface Control Document

UART Universal Asynchronous Receiver Transmitter

SPI Serial Peripheral Interface

USB Universal Serial Bus

BLE Bluetooth Low Energy

Appendix B: Definition of Terms

12

42: Multi-Axis Cobot For Factory Automation

Adrian Guzman, Emily Hamsa, Ethan Woods, Jaishil Shah

SUBSYSTEM REPORTS

REVISION – 0

5 December 2024

1

SUBSYSTEM REPORT

FOR

42: Multi-Axis Cobot For Factory Automation

PREPARED BY:

_____________________________

Author Date

APPROVED BY:

_____________________________

Project Leader Date

_____________________________

John Lusher II, P.E. Date

_____________________________

T/A Date

I

Subsystem Reports Revision - 0

42: Multi-Axis Cobot For Factory Automation

Change Record

Rev . | Date | Originator | Approvals | Description
0 | 12/5/2024 | All Members | All Members | Draft Release - Revision 0

II

Subsystem Reports Revision - 0

42: Multi-Axis Cobot For Factory Automation

Table of Contents

Table of Contents III List of Tables IV List of Figures IV 1. Overview 1 2. Motor/Motor Driver Subsystem 1

2.1. Subsystem Introduction 1 2.2. Subsystem Details 1 2.2.1. Torque Calculations and Motor Selection 2 2.2.2. Motor Movement 5 2.2.2.1. DRV8161 Motor Driver 5 2.2.2.2. PCB Design and Creation 7 2.2.2.3. Testing and Results 15 2.3. Subsystem Validation 21 2.4. Subsystem Conclusion 22 3. MCU/Processing Subsystem 24 3.1. Subsystem Introduction 24 3.2. Subsystem Details 24 3.2.1. Subsystem Block Diagram 24 3.2.2. PCB Schematic Design 25 3.2.2.1. General-Purpose Input/Output (GPIO) 25 3.2.2.2. Power 27 3.2.2.3. Programming (JTAG) 28 3.2.2.4. Miscellaneous 28 3.2.3. C2000 Launchpad Development 29 3.2.4. PCB Testing and Results 31 3.2.4.1. Power 32 3.2.4.2. JTAG Flashing & Programming 32 3.2.4.3. PWM Waveform Generation 35 3.2.4.4. Communication with ESP-32 37 3.3. Subsystem Validation 38 3.4. Subsystem Conclusion 39 4. Power & Battery Management Subsystem 41 4.1. Subsystem Introduction 41 4.2. Subsystem Details 41 4.2.1. Planning and Selection 41 4.2.2. Schematic and PCB Design 42 4.2.2.1. Schematic Design 42

III

Subsystem Reports Revision - 0

42: Multi-Axis Cobot For Factory Automation

4.2.2.2. PCB Design and Fabrication 44 4.3. Subsystem Validation 45 4.3.1. Output Voltage Verification 45 4.3.2. Input and Output Voltage Noise Verification 47 4.4. Subsystem Conclusion 49

5. User Interface & Wireless Connectivity Subsystem 50 5.1. Subsystem Introduction 50 5.2. Subsystem Details 50

5.2.1. Subsystem Block Diagram 50 5.2.2.1. Mobile Application (Flutterflow) 51 5.2.2.2. Mobile Application (App Store / Mobile Application Deployment) 53

5.2.3 PCB Layout Breakdown 54 5.2.3.1. ESP-32 Chip 54 5.2.3.2. GPIO Headers 54 5.2.3.3. Power Selection & Voltage Regulation 55 5.2.3.4. Boot/User & Reset Buttons 55 5.2.3.5. USB Connectors 56 5.2.3.6. Miscellaneous Components 56

5.2.4. GPIO Pin Layout 57 5.2.5. Arduino IDE 58 5.2.6. Communicating via high/low GPIO Pins & Physical Board Validation 59

5.3. Subsystem Validation 61 5.4. Subsystem Conclusion 61

III

Subsystem Reports Revision - 0

42: Multi-Axis Cobot For Factory Automation

List of Tables

Table 1: Differences and Similarities between Torque Categories 3 Table 2: Motor Torque for Each Category 4 Table 3: Selected Motors for 5-DoF Collaborative Robot 5 Table 4: Pinout for the Molex Mini-Fit Jr. Pinout (Motor Pinout) 7 Table 5: Motor Driver Subsystem Validation Plan Goals 22

Table 6: C2000 Pinout (Signals sent to 3x Motor Drivers) 26 Table 7: C2000 Pinout for ESP-32 Connectivity 27 Table 8: MCU/Processing Validated Deliverables 39 Table 9: Cobot Load List 41 Table 10: Validated Deliverables: Power Supply PCB 48 Table 11: Bluetooth Functions & their Functionality 52 Table 12: Subsystem Validation - Jaishil Shah 61

List of Figures

Figure 1: Conceptual Design and Free-Body Diagram 2 Figure 2: DRV8161 Simplified Schematic and Pinout 6 Figure 3: DRV8161 Evaluation Module’s Necessary Circuits and Signals 8 Figure 4: Motor Driver Schematics (Chip and Power Stage (Phase)) 10

Figure 5: MCU Launchpad Connector Schematic 10 Figure 6: Reference DRV8161 EVM PCB Layout 11 Figure 7: Front and Back Implementation of the ‘Main Board’, Board A 12 Figure 8: Front and Back Implementation of Board B 13 Figure 9: Front and Back Implementation of Board C 14 Figure 10: Texas Instruments DRV8161 Evaluation Module GUI 14 Figure 11: DRV8161 EVM Connected to Power Supply and Launchpad 15 Figure 12: GUI Interface Showing Connection to 48V PVDD with Output Disabled 16 Figure 13: Measuring the Phase Output Terminal on the DRV8161 EVM 17 Figure 14: Phase Voltage Outputs on Terminals A, B, and C (Respectively) 17 Figure 15: Created PCBs All Wired Together Without Motor and Phases Connected 18 Figure 16: Successful Connection to the GUI Showing 48V PVDD 19 Figure 17: Output of Each Voltage Step-Down Circuit (3.3V, 5V, and 12V Respectively) 19 Figure 18: Measuring the Phase Output Terminal on Phase A Board (Same for B and C) 20 Figure 19: Phase Voltage Output on Each Board (A, B, C) Respectively 20 Figure 20: MCU/Processing Block Diagram 24 Figure 21: GPIO PCB Schematic 25 Figure 22: Power PCB Schematic 27 Figure 23: JTAG Programming PCB Schematic 28 Figure 24: Miscellaneous PCB Schematic 28

IV

Subsystem Reports Revision - 0

42: Multi-Axis Cobot For Factory Automation

Figure 25: LED Blinky 29 Figure 26: MicroServo 9g SG90 30 Figure 27: Stepper Motor w/ ULN2003 Motor Driver 30 Figure 28: PWM Signal Modulation 31 Figure 29: Front & Back of PCB 31 Figure 30: 3.3V Input to Terminal Block 32 Figure 31: Successful JTAG Programming Method 32 Figure 32: Flashing through Launchpad 33 Figure 33: Successful Connection 33 Figure 34: C2000 Software for Demo 34 Figure 35: ESP-32 Arduino Software (High/Low Toggle) 34 Figure 36: Demo Setup 36 Figure 37: Probing PWM Output Pins 36 Figure 38: PWM Generation EPWM7A & EPWM7B (GPIO12 & GPIO13) 36 Figure 39: PWM High/Low Generation 37 Figure 40: ESP32/C2000 Setup 38 Figure 41: ESP-32 to C2000 Communication (LED Toggle) 38 Figure 42: 3.3V, 0.5A Step-down Circuit Schematic 42 Figure 43: 5V, 1A Step-down Circuit Schematic 42 Figure 44: 6V, 2.5A Step-down Circuit Schematic 43 Figure 45: 12V, 1A Step-down Circuit Schematic 43 Figure 46: 24V, 1A Step-down Circuit Schematic 43 Figure 47: Connection from Vin Directly to Output Schematic 44 Figure 48: Power Supply PCB 44 Figure 49: 3.3V Output When Tested with 25V Input 45 Figure 50: 6V Output When Tested with 30V Input 45 Figure 51: 12V Output When Tested with 30V Input 45 Figure 52: 24V Output When Tested with 30V Input 46 Figure 53: 3.3V Noise Output When Tested with 25V Input 47 Figure 54: 6V Noise Output When Tested with 25V Input 47 Figure 55: 24V Noise Output When Tested with 30V Input 47 Figure 56: 12V Noise Output When Tested with 30V Input 48 Figure 57: UI & Wireless Connectivity Subsystem Block Diagram 50 Figure 58: Application Page List 51 Figure 59: Intro Page 51 Figure 60: Home Page 51 Figure 61: Device Page 51 Figure 62: Bluetooth Function UI 52 Figure 63: Block Diageam of Function Overlap 52 Figure 64: Mobile Application Deployment via TestFlight 53 Figure 65: Mobile Application Deployment to iPad and iPhone 53 Figure 66: Mobile Application on iPhone 53 Figure 67: ESP-32-S3-MINI Module Schematic 54 Figure 68: GPIO PIN Headers Schematic 54 Figure 69: Power Selection & Voltage Regulation Schematic 55 Figure 70: Boot/User & Reset Button Schematics 55 Figure 71: USB Connector Schematics 56 Figure 72: Miscellaneous Schematics 56 Figure 73: GPIO Pin-Out Sheet 57

IV

Subsystem Reports Revision - 0

42: Multi-Axis Cobot For Factory Automation

Figure 74: Arduino IDE interface 58 Figure 75: Mobile Input → ESP-32 → OLED screen 58 Figure 76: Full Subsystem Functionality Test 59 Figure 77: 3D render of ESP-32 PCB 60 Figure 78: ESP-32 PCB used in four-part system 60 Figure 79: Arduino Serial Monitor displaying Signals Received 60

IV

Subsystem Reports Revision - 0

42: Multi-Axis Cobot For Factory Automation

1. Overview

The multi-axis cobot for factory automation will be able to lift and move objects wirelessly to improve productivity, minimize worker injury, and work in dangerous environments. The cobot will take user input through a mobile app and then move according to the input. The system is broken down into four subsystems, motor/motor driving, MCU/processing, power/battery management, and user interface/wireless connectivity. Each team member has researched, developed, and tested their individual subsystem. The validation and execution plans have been followed closely to ensure an easy path to integration in the following semester.

2. Motor/Motor Driver Subsystem - Ethan Woods

2.1. Subsystem Introduction

The Motor/Motor Driver Subsystem is responsible for controlling the movement of the Collaborative Robot (Cobot) through the selection and control of the motors. This subsystem focuses on identifying the motors capable of handling the calculated torque requirements for the different joints in the Cobot. These motors are driven using Texas Instruments’ DRV8161 Motor Drivers, which controls the 3-Phase Brushless DC (BLDC) motors using generated PWM signals.

To achieve motor movement, custom PCBs were designed and fabricated with the primary goal of spinning a 3-phase BLDC motor. These boards integrate key functionalities, including voltage step-down circuits, Motor Driver circuits, and connections for phase signal generation, inspired by the Texas Instruments’ DRV8161 Evaluation Module. The PCB system consists of a main board and two supporting boards, collectively enabling control and high-performance operation of the motor. The design has compatibility with the LAUNCHXL-F280049C, a Texas Instruments’ C2000 Launchpad Development Kit, and supports the high torque, voltage, and current requirements of the motors needed.

2.2. Subsystem Details

During this semester, the subsystem had two main goals: Motor Selection and Motor Movement. The first goal was to calculate the necessary torque needed for each motor in the Cobot to accommodate its maximum payload, desired dimensions, and material weight. Based on these calculations, five motors were selected—one for each joint: Base, Arm 1, Arm 2, Neck, and Head. All motors except for the Head are 3-phase BLDC motors, chosen for their precision and compatibility with the DRV8161 Motor Drivers.

The second goal was to move and spin one of the selected motors. To achieve this, the DRV8161 Motor Drivers were used to generate the three phases required for the operation of a 3-phase BLDC motor. This involved designing and creating a system of PCBs that worked together to generate and route the necessary signals for motor control. The motor was connected to a main board, which ensured it received all the signals needed for movement and allowed control through an external device.

1

Subsystem Reports Revision - 0

42: Multi-Axis Cobot For Factory Automation

2.2.1. Torque Calculations and Motor Selection

At the start of the semester, the team met to conceptualize the operation and movement of the Cobot and establish its primary constraints. As a Collaborative Robot, the design emphasized smooth and unrestricted movement within its range of motion. This discussion led to the decision to implement a 5-Degree of Freedom (DoF) design, requiring five motors—one for each joint. At this stage, the focus was solely on the degrees of freedom and the maximum payload the Cobot should handle, without addressing details about its material composition or dimensions.

With this conceptual framework in place, the next step involved analyzing the conditions under which the motors would operate. Using free-body diagrams and calculations, the assumptions and constraints necessary to determine the torque range required for motor selection were defined. Below is the process followed to determine the torque range required for each motor. Calculations are not provided here but are available in the document linked below.

These calculations and results are presented in the document: Motor Calculations If the link does not work, send concerns to ewoods738@tamu.edu or (210)774-0465

To calculate the required torques for each of the five motors in the conceptual Cobot, the design was translated into a 5-jointed robotic arm representation. This step enabled visualization of the system and the creation of the free-body diagram (FBD) shown below, which depicts the robotic arm in its worst-case scenario. By analyzing this worst-case configuration, the torque calculations are intentionally overestimated, ensuring a safety margin in the design rather than risking underestimations. Below is the conceptual 5-DoF design and the corresponding free-body diagram used as the basis for the torque calculations.

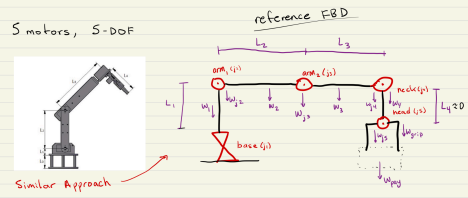
[picture p14: figure]

Figure 1: Conceptual Design and Free-Body Diagram

2

Subsystem Reports Revision - 0

42: Multi-Axis Cobot For Factory Automation

With the creation of the free-body diagram (FBD), the forces acting on each joint were determined, enabling the calculation of the gravitational or angular torque required for each motor. Motors responsible for lifting (Arm 1 and Arm 2) require gravitational torque calculations, while those responsible for rotation (Base and Neck) require angular torque calculations. To account for variability in the Cobot's design, the torque requirements were classified into three ranges: Low Torque, Medium Torque, and High Torque.

● Low Torque represents a smaller and lighter-than-expected design.

● Medium Torque reflects the expected design based on our initial assumptions. ● High Torque assumes a heavier, overestimated design to ensure safety margins in the motor selection.

Torque Categories: Differences and Similarities

The differences between the torque ranges are based on varying constraints such as arm length, material density, and acceleration. However, certain assumptions, such as the payload and the gripper motor's specifications, remained consistent across all categories. The table below summarizes these differences and similarities:

Category | Base and Neck Acceleration | Weight of Arms (Material Density,Cross Section) | Length of Arms | Payload Weight | Gripper Motor Weight/ Length | Joint Motor Weight
Low Torque | Reduced | Lower density, smaller cross section | Shorter | Fixed (2 lb / 0.91 kg) | Fixed* (Amazon Servo Motor) | Fixed/ Estimated**
Medium Torque | Average/ Expected | Average density and cross-section | Average/ Expected | Fixed | Fixed* | Fixed/ Estimated**

High

Torque

Increased Higher density, and larger

cross-section

Longer Fixed Fixed* Fixed/ Estimated**

Table 1: Differences and Similarities between Torque Categories

* The motor and claw specifications are on Amazon. These were used during calculations. ** Weights were estimated based on the average weights of different motors that could be used during the project. Ended up being 1.4 kg for Joint 2, 0.8 kg for Joint 3, and 0.25 kg for Joint 4.

3

Subsystem Reports Revision - 0

42: Multi-Axis Cobot For Factory Automation

With the completion of the torque calculations, the estimated torque requirements for each motor in the Cobot have been determined across three categories: Low Torque, Medium Torque, and High Torque. These calculations provide a clear range of torque values for each joint—Base, Arm 1, Arm 2, Neck, and Head—ensuring the selected motors can handle both expected and extreme conditions. The table below summarizes the calculated torque values for each motor in all three categories, serving as the foundation for motor selection.

Motor | Low Range Torque | Mid Range Torque | High Range Torque
Base Motor | .1428 N/m** | .5339 N/m | 1.993 N/m
Arm 1 Motor Arm 2 Motor | 563 oz-in*** 181.72 oz-in | 1197 oz-in 354 oz-in | 2763 oz-in 745 oz-in
Neck Motor | .00649 N/m | .00973 N/m | .0129 N/m
Gripper Motor* | 11 kg/cm | 11 kg/cm | 11 kg/cm

Table 2: Motor Torque for Each Category

* Gripper Motor is bought off Amazon. Cannot change the value of the torque produced or required for the Gripper Motor as 11 kg/cm should be more than enough for 2 lbs. ** N/m is the measurement for angular torque, as it is the amount of torque needed to produce the acceleration necessary for the Base and Neck motors

*** oz-in is a measurement of torque in relation to gravity. It shows the lifting power needed for that motor to lift a payload of 2 lbs when considering the entire design of the Cobot.

Motor Selection Based off Estimated Torque Range

With the established torque ranges for each joint, we could now select motors that meet the performance requirements while aligning with the constraints of the Cobot's design. The motors chosen are high-power, 3-phase BLDC motors, capable of handling the calculated torque for their respective joints. The table below highlights the selected motors, along with their key specifications such as voltage, current, torque output, and cost, ensuring they are well-suited for their designated roles in the Cobot.

4

Subsystem Reports Revision - 0

42: Multi-Axis Cobot For Factory Automation

Motor | Name | Link | Torque | Rated Voltage | Rated Current | Encoder Type | Weight | Price
Base | 57BSA | link | 0.6 N/m | 48 V | 5.4 A | Hall | 1.35 kg | $59
Arm 1 | NEMA 34 Hudson | link | 1223 oz-in | 48 V | ~10 A max: 20 A | Differential/ Hall | 2.8 kg | ~$360
Arm 2 | NEMA 23 Hudson | link | 223 oz-in | 48 V | ~ 10 A max: 30 A | Differential/ Hall | 0.6 kg | ~$210
Neck | 42BYA | link | 0.04 N/m | 24 V | 1 A | Hall | 0.3 kg | $20
Head | MG996R | link | 11 kg/cm | 5 V | 0.17 A | N/A | 0.095 kg | $27

Table 3: Selected Motors for 5-DoF Collaborative Robot

With the torque calculations complete and motors selected, my focus for the remainder of the semester shifted to achieving motor movement. The NEMA 23 Hudson motor, paired with a 48V 25A power supply, was chosen as the test motor for this phase. Using custom-designed PCBs, the goal is to successfully drive and spin the chosen motor. The process of how this was accomplished is outlined in Section 2.2.2 below.

2.2.2. Motor Movement

To enable movement in the selected 3-Phase BLDC motor, the focus shifts to the second critical component of this subsystem: Texas Instruments’ DRV8161 Motor Driver. This motor driver serves as the foundation for controlling all motor operations in this project by generating the phase signals required for motion. Given that our above motor operates with three phases, three DRV8161 Motor Drivers are necessary to facilitate its movement. The following sections will outline the design and implementation of a system of PCBs used to produce the necessary control signals, leading to the successful operation of the 3-Phase BLDC motor.

2.2.2.1. DRV8161 Motor Driver

The DRV8161 is a high-performance, 100V half-bridge smart gate driver designed to enable precise and reliable control of high-voltage, high-current motor systems. As part of Texas Instruments’ latest DRV816x family, released in early 2024, this driver integrates advanced features such as a low-offset current sense amplifier, robust protection mechanisms, and versatile PWM control options. The DRV8161 supports a wide range of features that make it ideal for high-performance applications, such as an industrial Collaborative Robot. It includes built-in protection systems to guard against undervoltage, overcurrent, and overheating, ensuring safe operation under various conditions. With a Pulse-Width Modulation (PWM) signal input, the chip produces phase signals needed to control motor movement accurately.

5

Subsystem Reports Revision - 0

42: Multi-Axis Cobot For Factory Automation

Figure 2 illustrates a simplified schematic of how three DRV8161 Motor Drivers are used to generate the three-phase signals required to control a BLDC motor. The figure also includes the 20-pin pinout of the DRV8161, highlighting the essential connections and signals needed for operation.

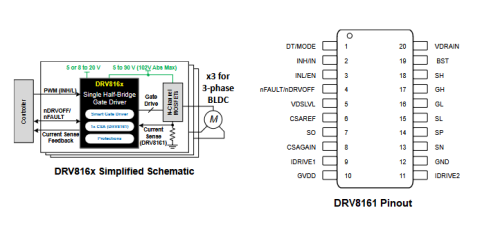
[picture p15: figure]

Figure 2: DRV8161 Simplified Schematic and Pinout

To understand how the DRV8161 operates, the functionality can be separated into two parts: Phase Output and Hardware Selection and Fault Detection.

Phase Output

The first key aspect of the DRV8161 is the actual generation of the Phase Signal through the various internal and external circuits of our motor driver. The DRV8161 motor driver operates by receiving a 12V supply voltage (GVDD) to power the chip. A PWM input signal is provided, where the high and low signals (INH/INL) control the gate driver. The input PWM signal interacts with the Dead Time/Mode (DT/MODE) configuration, determining the specific mode of operation for the driver. Based on this, the chip generates the necessary output signals: Bootstrap (BST), High-Side Gate (GH), High-Side Source (SH), Low-Side Gate (GL), and Low-Side Source (SL). These signals are then fed into the N-Channel MOSFET circuits, which are responsible for switching and ultimately creating the motor's phase signals.

Additionally, the DRV8161 includes an integrated current sense amplifier to monitor the current flow through the MOSFETs. This feature provides an added layer of protection, helping to prevent overcurrent situations that could damage the MOSFETs or other components in the system. Through this sequence, the DRV8161 efficiently drives the motor while ensuring safe operation under varying load conditions.

6

Subsystem Reports Revision - 0

42: Multi-Axis Cobot For Factory Automation

Hardware Selection and Fault Detection

The second key aspect of the DRV8161’s operation is its integrated protection and hardware selection features. The chip allows users to configure various hardware settings through external resistors connected to specific pins. These pins include IDRIVE1, IDRIVE2, VDSLVL, and DT/MODE, each offering different levels of control for fault detection and functionality. The desired settings are selected by adjusting the resistors in the circuit around the DRV8161.

In addition to these hardware selection options, the DRV8161 is equipped with several internal fault detection mechanisms, which are communicated through the nFAULT pin. This pin is pulled low during a fault condition, indicating issues such as GVDD undervoltage, VDS overcurrent, or thermal shutdown. With the help of a microcontroller monitoring these fault signals, the system can protect itself under these conditions. When a fault is detected, the chip disables the gate driver outputs, turning the external MOSFETs off to prevent further damage. Normal operation resumes only once the fault condition is cleared.

To better understand how the DRV8161 integrates into a system, let's now explore the PCB design process required to drive a 3-phase BLDC motor and enable its operation.

2.2.2.2. PCB Design and Creation

Understanding the Signals and Circuits Needed for Movement

To design the necessary PCBs for driving the motor, it is crucial to first understand the signals required for operating the 3-phase BLDC motor. The initial step involves identifying the motor’s pinout, which defines the signals needed for proper motor control. In this case, the focus is on the NEMA 23 Hudston Servo Motor and its corresponding Molex Mini-Fit Jr. connector. This pinout provides key signal connections, such as phase signals and communication pins, that are essential for motor movement.

Pin # | AWG | Signal Name | Pin # | AWG | Signal Name
1 | 16 | P DRAIN | 2 | - | NO CONNECT
3 | 26 | COMM S-T | 4 | 26 | COMM R-S
5 | 26 | COMM T-R | 6 | 26 | E DRAIN
7 | 26 | GND | 8 | 26 | ENC A~
9 | 16 | PHASE R | 10 | 16 | PHASE S
11 | 16 | PHASE T | 12 | 26 | +5VDC IN

13 26 ENC I 14 26 ENC B

15 26 ENC A 16 26 ENC B~

Table 4:Pinout for the Molex Mini-Fit Jr. Pinout (Motor Pinout)

7

Subsystem Reports Revision - 0

42: Multi-Axis Cobot For Factory Automation

Once the motor's pinout is understood, the next step is to examine the motor driver's role in generating the required control signals. This process involves utilizing the DRV8161 Evaluation Module (EVM) paired with the LAUNCHXL-F280049C development kit. This hardware combination, along with an external GUI on a laptop, facilitates the generation of PWM signals to drive the motor while also providing fault detection and diagnostics via built-in LEDs. Figure 3 below highlights the key areas involved in the operation of the EVM alongside the GUI.

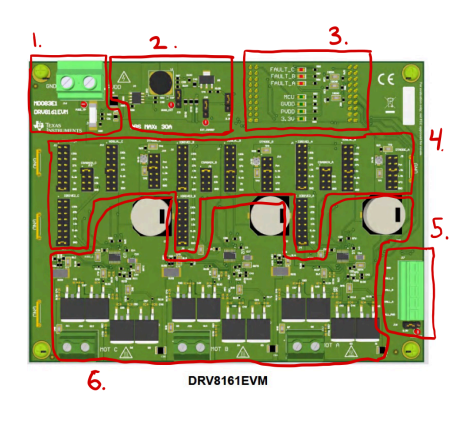
[picture p16: figure]

Figure 3: DRV8161 Evaluation Module’s Necessary Circuits and Signals

1. PVDD/GND Input: The power supply input and ground for the entire board, with an input voltage range of 4.5V to 48V and a maximum current rating of 30A. 2. 12V and 3.3V Step-Down Circuits: These circuits step down the input voltage to provide 12V GVDD for the motor driver and 3.3V for the CSAREF and MCU voltage requirements.

3. Launchpad Integration and Fault/Status LEDs: The LAUNCHXL-F280049C is mounted beneath the EVM and connected to a laptop via MicroUSB. The laptop interfaces with the GUI, which controls the MCU/EVM code and provides real-time fault and status monitoring via built-in LEDs.

8

Subsystem Reports Revision - 0

42: Multi-Axis Cobot For Factory Automation

4. Hardware Configuration Jumpers: Resistor jumpers allow for customization of the IDRIVE, CSA gain, VDSLVL, and dead time mode settings for each of the three DRV8161 motor drivers.

5. Hall Sensor Inputs: This feature takes input from an external Hall sensor in the motor, adjusting the phase outputs accordingly. These adjustments are made through the GUI for precise control.

6. Motor Driver Circuits: The EVM contains three identical motor driver circuits, each driving the phase signals generated by the DRV8161. Large terminals are provided at the bottom for routing the phase signal outputs.

Finally, we can categorize the critical and non-critical signals and circuits involved in driving the NEMA 23 motor using the DRV8161. Critical signals and circuits are essential for generating the phase outputs required by the motor drivers, such as the input voltages and Launchpad connections. Non-critical signals and circuits, on the other hand, are not strictly necessary for phase signal generation and can be configured to a fixed value, allowing for greater flexibility in PCB design. For example, the hardware selection signals can be set to a single, fixed value and do not need to be dynamically adjustable.

Critical Signals and Circuits:

● PVDD/GND Input: Supply power and GND to board. Used by almost everything on the board.

● Launchpad Connection: Launchpad connection jumpers to route signals generated by the GUI and the Launchpad to/from the Motor Drivers.

● Hall Sensor Inputs: Critical feedback mechanisms from the motor, allowing for accurate phase output adjustments.

● Motor Phase Outputs: The control phase signals generated by the DRV8161 Motor Driver, which control the rotation of the motor.

● Step-Down Circuits: 12V, 5V, and 3.3V step-down circuits are needed because of different components on the board.

● Encoder Inputs: Another critical feedback mechanism from the motor, allowing for precise control of movement from the motor.

Non-Critical Signals and Circuits:

● Hardware Selection Jumpers (IDRIVE, CSA Gain, VDSLVL, DT Mode): These signals are configurable through resistor combinations, but can be set to a fixed mode, eliminating the need for a dynamic adjustment jumper circuit.

● Fault and Status LEDs: Although non-critical, it is always helpful to have Fault and Status LEDs to help diagnose problems. Provides visual feedback from the MCU/Motor Driver to see faults.

With a clear understanding of the critical and non-critical signals required to drive the NEMA 23 motor using the DRV8161, we can now transition to the implementation of the system of three PCBs that were made to generate motor movement.

9

Subsystem Reports Revision - 0

42: Multi-Axis Cobot For Factory Automation

Integrated PCB Design for Motor Operation

The design and development of the PCBs were heavily inspired by the DRV8161 Evaluation Module, which provided a strong foundation for implementing the motor driver circuits. Many schematics, layout designs, and component footprint libraries required for the motor driver were readily available through Texas Instruments, streamlining the design process. Additionally, the voltage step-down circuits, an essential part of the PCBs, were adapted from schematics provided by Emily Hamsa, who is responsible for the Power Subsystem. Key elements such as the MOSFET layout and driver circuit designs drew direct inspiration from the DRV8161 EVM, ensuring both functionality and reliability. Below are some examples of the referenced schematics and layouts that influenced the PCB design.

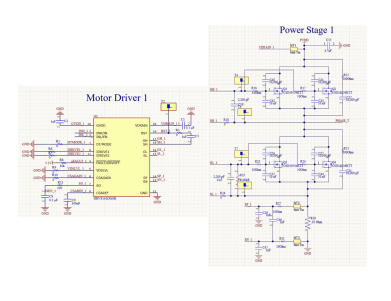
[picture p17: figure]

Figure 4: Motor Driver Schematics (Chip and Power Stage (Phase))

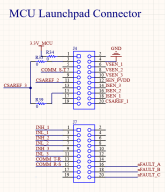
[picture p18: figure]

Figure 5: MCU Launchpad Connector Schematic

10

Subsystem Reports Revision - 0

42: Multi-Axis Cobot For Factory Automation

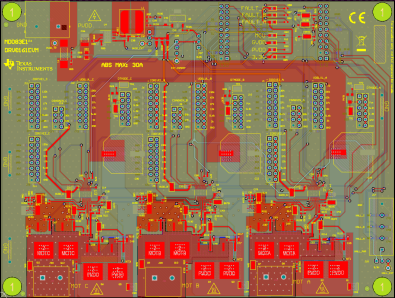
[picture p19: figure]

Figure 6: Reference DRV8161 EVM PCB Layout

Above in Figure 3 and Figure 6, you can see the Hardware Selection jumpers for the different logic levels in the DRV8161 Motor Driver. Since this is a non-critical circuit in the creation of the phase signal, our boards were able to be simplified by setting each selection to its ‘Level 0’ logic level by having a 0Ω resistor for each selection. By setting the selection levels for each signal to its base value, we ensured that there would be no unexpected complications during operation and could omit the large circuitry needed for the resistance jumper selection system.

To finally generate motor movement using three DRV8161 Motor Drivers, a system of three PCB boards was developed: Board A, Board B, and Board C. Each board corresponds to one of the three phase signals required by the motor and produced by the motor drivers. Among these, Board A serves as the ‘Main Board,’ as it houses additional circuits necessary for the motor's operation. The other two boards, Board B and Board C, focus primarily on driving their respective phases. Below is a breakdown of each board, highlighting its key functionalities and the circuits it contains.

Board A

Board A serves as the ‘Main Board’ since it will be the main powerhouse of the three PCBs. It will serve as the board that the Launchpad and the motor will plug into and run off of. It will have output terminals for each of the step-down voltage circuits on the board, terminals for motor feedback functions, and terminals to input Motor Driver phase outputs from Boards B and C. Below are the key functions that are on the board:

11

Subsystem Reports Revision - 0

42: Multi-Axis Cobot For Factory Automation

Key Functions: (Numbered in Figure 7 Below)

● Take PVDD/GND Input (48V, 30A Input) (1)

● Motor Driver Circuit (Phase Generation) (2)

● Voltage Step-Down Circuits (Schematics from Emily Hamsa)

○ 48V PVDD -> 12V GVDD (3a)

○ 48V PVDD -> 5V Hall/Encoder (3b)

○ 48V PVDD -> 3.3V MCU (3c)

● Input Terminals for Phase B & C (4)

● LAUNCHXL-F280049C Jumper Connector (5)

● Input/Output Terminals for Encoder/Hall Sensor (6)

● Output Terminals for 12V, 5V, and 3.3V (7)

● Motor Connector Mating Terminal (8)

Board A was designed with the goal of isolating the ability to produce a single phase signal, making it straightforward to replicate this functionality across two additional boards—Board B and Board C. This modular approach simplifies the design process and ensures consistency between phases. Below is the completed build of Board A, labeled with its corresponding key functions as outlined above.

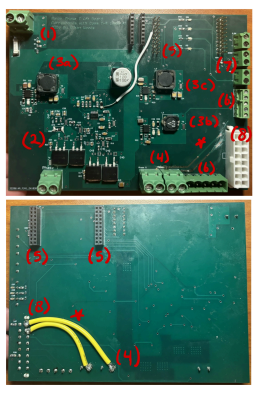
[picture p20: figure]

Figure 7: Front and Back Implementation of the ‘Main Board’, Board A

12

Subsystem Reports Revision - 0

42: Multi-Axis Cobot For Factory Automation

Boards B & C

Boards B and C complete the system by generating the final phase signals required to drive motor movement. These boards were intentionally designed for simplicity, relying solely on the signals provided by Board A to produce their respective phase outputs. Connections between Board A and Boards B and C are made via jumper wires, ensuring seamless communication. Once all necessary inputs are received, Boards B and C generate their corresponding phase signals, which are then routed back to Board A. Below are the key functions that are on the boards:

Key Functions: (Numbered in Figure 8 and 9 Below)

● PVDD/GND Input (48V, 30A Input) (1)

● Input Terminals for 12V and 3.3V (2)

● Jumper Terminals for Signals from Board A (3)

● Motor Driver Circuit (Phase Generation) (4)

● Phase Output Terminal (5)

Boards B and C are dedicated to generating their respective phase signals, which are then routed back to Board A for integration. This modular design allows each phase signal to be created independently, simplifying the overall system and ensuring flexibility in the design. Below are the finalized builds of Board B and Board C, with their key functions labeled as outlined above.

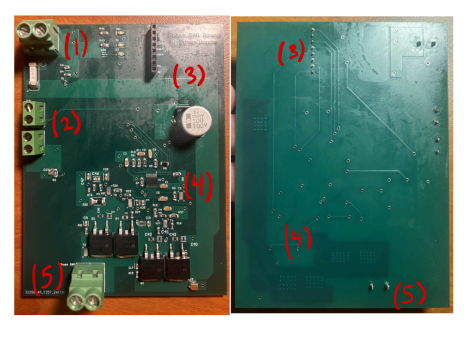
[picture p21: figure]

Figure 8: Front and Back Implementation of Board B

13

Subsystem Reports Revision - 0

42: Multi-Axis Cobot For Factory Automation

Figure 9: Front and Back Implementation of Board C With all three boards assembled and interconnected, the system is now ready to drive the motor. By connecting the Launchpad to the designated connector on Board A and linking it to a laptop, we can utilize the GUI software provided by Texas Instruments to

control the setup. This GUI mirrors the functionality of the DRV8161 EVM, enabling the user to adjust parameters such as duty cycle and acceleration delay with ease. Through the GUI, the output of our PCB system can be enabled, allowing the generation of the phase signals required to drive the motor. Figure 10 shows the GUI and its configuration.

With the hardware and control system in place, we now move into Testing and Results, where we evaluate the performance and functionality of the PCBs in driving the motor. Figure 10: Texas Instruments DRV8161 Evaluation Module GUI

14

Subsystem Reports Revision - 0

42: Multi-Axis Cobot For Factory Automation

2.2.2.3. Testing and Results

To begin testing each board, they were powered using a 48V 25A power supply. On power-up, the corresponding LEDs on Board A illuminated as expected, confirming proper functionality. However, on Boards B and C, some LEDs were found to be installed backward, preventing them from lighting even when power was applied. Despite this, terminal testing with a multimeter confirmed that all PVDD and GND connections were functioning correctly, ensuring the boards were receiving power.

With power delivery confirmed, the next step was to validate the functionality of the DRV8161 EVM as a baseline for comparison. The EVM was powered using the same 48V 25A power supply and connected to the GUI through the LAUNCHXL-F280049C Launchpad. This setup allowed us to simulate identical circuit conditions to those in our PCB system and measure the phase output voltages generated by the EVM.

To verify the performance of our boards, the phase output voltages from the DRV8161 EVM were measured and used as reference values. By comparing these outputs with the corresponding phase signals from our boards, we could validate whether the PCB system was producing accurate signals needed for motor operation.

Below is the process for connecting and measuring the outputs from the DRV8161 EVM, followed by images of the measured phase signals for comparison.

Figure 11: DRV8161 EVM Connected to Power Supply and Launchpad

15

Subsystem Reports Revision - 0

42: Multi-Axis Cobot For Factory Automation

Figure 12: GUI Interface Showing Connection to 48V PVDD with Output Disabled

Once connected, the DRV8161 EVM is successfully linked to the Launchpad and ready to enable its output to produce the three-phase signals required for motor operation. However, while the EVM can generate these signals, we are unable to use it to spin a motor directly due to the design of Board A.

Although Board A includes terminals capable of routing all three-phase signals to the motor connector, this setup is incompatible with the motor driver already present on Board A. Since the motor driver circuit is powered through the board's power supply, it interferes with the output at one of the terminals used to route a phase signal. As a result, the motor cannot be properly connected or controlled via Board A when paired with the EVM.

Instead, validation is performed by comparing the phase output voltages at the EVM's phase terminals with those generated by our PCBs. By measuring and analyzing these outputs, we can confirm the functionality of our design. Below are the results of measuring the phase output terminals for each respective phase.

16

Subsystem Reports Revision - 0

42: Multi-Axis Cobot For Factory Automation

Figure 13: Measuring the Phase Output Terminal on the DRV8161 EVM

Figure 14: Phase Voltage Outputs on Terminals A, B, and C (Respectively)

17

Subsystem Reports Revision - 0

42: Multi-Axis Cobot For Factory Automation

As seen in Figure 14, the three-phase output terminals of the DRV8161 EVM measure approximately 9.48 Volts. This voltage serves as the benchmark for validating the outputs of our PCB system. To begin testing the three PCBs, the boards are connected as shown in Figure 15 below.

Figure 15: Created PCBs All Wired Together Without Motor and Phases Connected

In this setup, all the boards are powered by the 48V power supply, and the necessary input signals for generating the phases are routed accordingly. However, as depicted in Figure 15, the motor and phase signal connections to Board A are not included in this particular configuration.

Earlier in the day, during an initial test with the motor and phase wires connected, enabling the output via the GUI resulted in a trace on Board A burning out instantly. Despite debugging and reattempting, the same issue occurred a second time. The damaged trace was subsequently repaired with a replacement wire, as shown in the previously referenced Figure 7 (denoted by the star).

Given this outcome, testing now focuses on measuring the voltage outputs at the phase terminals and verifying the functionality of the voltage step-down circuits. The results of these measurements are detailed in the following figures:

18

Subsystem Reports Revision - 0

42: Multi-Axis Cobot For Factory Automation

Figure 16: Successful Connection to the GUI Showing 48V PVDD

Figure 17: Output of Each Voltage Step-Down Circuit (3.3V, 5V, and 12V Respectively) 19

Subsystem Reports Revision - 0

42: Multi-Axis Cobot For Factory Automation

Figure 18: Measuring the Phase Output Terminal on Phase A Board (Same for B and C)

Figure 19: Phase Voltage Output on Each Board (A, B, C) Respectively

20

Subsystem Reports Revision - 0

42: Multi-Axis Cobot For Factory Automation

In conclusion, while the testing of the PCB system did not achieve the desired outcome of motor movement, significant progress was made in understanding and isolating the issues. The measurement results confirmed that two of the phase terminals (A and B) were functioning as expected, producing voltages near 9.48V. However, the issue with Board C, where one of the terminals was producing an unexpected 48V, highlighted a short to the input voltage. This has been traced back to a potential fault with the DRV8161 chip, which will be further investigated.

Given the importance of having all three motor driver circuits fully functional, Board C's failure prevents the successful operation of the 3-phase BLDC motor. However, with plans for continued work over the winter break, efforts will focus on reworking Board C and potentially creating an additional board to ensure proper motor operation. Though this semester’s testing did not achieve the final goal, it laid the critical groundwork needed for future progress.

Looking ahead, further testing and refinement will be necessary to achieve full motor movement and integration with other subsystems in ECEN 404. The experience gained this semester will prove invaluable as we continue to improve the design, and the validation of the system’s objectives will be a crucial next step in confirming the success of the overall project.

2.3. Subsystem Validation

The ultimate goal of validating this subsystem was to achieve movement in a 3-Phase BLDC Motor using a system of custom PCBs connected to the C2000 Launchpad. While motor movement was not achieved this semester due to a short on one of the boards, the validation focuses on proving that generating one correct phase signal demonstrates the feasibility of producing the other two in the same manner. This reasoning underscores the importance of achieving even partial functionality, as it lays the groundwork for future success.

Given the complexity of this subsystem, involving over 200 components (primarily 0805-sized) across multiple PCBs, there were many opportunities for small errors to propagate and affect overall performance. Each board required meticulous attention to detail, from schematic design to fabrication and testing, to ensure proper operation. Therefore, the validation approach breaks down the subsystem into measurable, incremental goals to assess the progress made and identify areas for improvement.

21

Subsystem Reports Revision - 0

42: Multi-Axis Cobot For Factory Automation

Below is the validation plan, highlighting the specific criteria used to evaluate each aspect of the subsystem and how it aligns with the project’s objectives:

Test Deliverable | Achieved Goal? | Why/How? | Supporting Figure(s)
Schematic and PCB Design | Yes | Created system of 3 PCBs to work to spin a motor | Figures 7, 8, 9
PWM Phase Output from Motor Drivers | Yes | Achieved an output voltage similar to our benchmark voltage on the EVM | Figure 19
Motor Movement | No | Short on Board C prevented complete integration and motor movement | N/A

Precise Motor Control

No With no motor movement, no control could be done

N/A

All Motor Movement No No motor movement generated N/A

Table 5: Motor Driver Subsystem Validation Plan Goals

2.4. Subsystem Conclusion

While motor movement remains unachieved this semester, significant groundwork has been laid to make it an attainable goal in the near future. This is a critical step for the Collaborative Robot, as motor-driven movement is central to its functionality. Despite this gap, the process and implementation described show that motor movement is within reach. The priority for the winter break will be to repair or produce a new board to replace the malfunctioning Board C. With a functioning Board C—or an alternative board designed to fulfill its role—motor movement should be straightforward, requiring only connection to the GUI and Launchpad.

Beyond this immediate task, the Motor/Motor Movement subsystem is well-positioned to transition into the next phase of integration. The current approach, using three motor drivers to spin a 3-Phase BLDC motor, will remain the foundation moving forward. However, next semester’s design will consolidate the motor driver circuits onto a single main board, which will simplify wiring and reduce the overall complexity of the system. This main board will interface with a dedicated voltage step-down board from the Power Subsystem, streamlining power distribution. Custom connectors for each motor will also ensure proper compatibility and ease of use.

22

Subsystem Reports Revision - 0

42: Multi-Axis Cobot For Factory Automation

This brings us to a key consideration: complexity. Creating and testing these initial boards, which only include the minimum functionality to generate phase signals, required designing over 200 components. Scaling this approach to accommodate four additional motors would demand an immense amount of time and effort, which is further compounded by the limited resources and lack of mechanical engineering expertise within the team. As a result, there is growing support for simplifying the collaborative robot into a crane-like design. This shift would reduce the motor count from four to two (plus a claw), cutting the number of required boards in half and allowing the team to focus on optimizing the system’s core functions.

Despite these challenges, the subsystem’s achievements this semester provide a solid foundation for future work. With phase signals successfully generated and the boards communicating effectively with the MCU subsystem, integration is already underway. Next semester, the focus will include refining the PWM signals needed to drive the motor driver circuits, collaborating with the Power Subsystem to route external voltage levels directly onto the main board, and enhancing interaction with the Wireless Connectivity Subsystem for mobile application control. This forward-looking plan ensures that, with continued effort, the Motor/Motor Movement subsystem will achieve full functionality and play a pivotal role in the Collaborative Robot’s success.

23

Subsystem Reports Revision - 0

42: Multi-Axis Cobot For Factory Automation

3. MCU/Processing Subsystem - Adrian Guzman

3.1. Subsystem Introduction

The MCU/Processing subsystem is designed to receive input signals from the mobile application subsystem and generate PWM waveforms that will be used by the motor driver subsystem to control a motor. This subsystem plays a major role in supporting the goal of achieving a fully functional Collaborative Robot (cobot). The subsystem utilizes the TMS320F280049C microcontroller from Texas Instruments’ C2000 family of real-time control MCUs. The power subsystem supplies the necessary power to the MCU to facilitate the completion of tasks. The MCU subsystem has been designed to incorporate compatibility and integration to other subsystems. The required deliverables of this subsystem have been accomplished by adhering to the execution and validation plan. Furthermore, the subsystem was thoroughly tested in the lab to ensure the necessary signals can be received and generated to achieve the end project goal. The following documentation provides a detailed breakdown as to what has been accomplished.

3.2. Subsystem Details

3.2.1 Subsystem Block Diagram

The following figure presents a high level block diagram for the MCU/Processing Subsystem, which is capable of receiving signals from the ESP-32 and generating PWM signals for motor control.

Figure 20: MCU/Processing Block Diagram

The MCU/Processing subsystem utilizes the TMS320F280049C MCU, which features a variety of peripherals such as pulse-width modulation (PWM) for motor control and a large quantity of General-Purpose Input/Output (GPIO) pins. The GPIO pins will support the communication between the C2000 and the ESP-32 within the mobile application subsystem.

24

Subsystem Reports Revision - 0

42: Multi-Axis Cobot For Factory Automation

The mobile application subsystem includes a mobile app with a game style like controller. When a button is pressed, a GPIO pin on the ESP-32 shall change from low to high. The C2000 will detect this input and generate the necessary PWM signals. These PWM signals will be sent to the DRV816x motor drivers to rotate a Brushless DC motor (BLDC).

3.2.2. PCB Schematic Design

The primary objective for the MCU/Processing subsystem was to design a PCB that enables functionality of the MCU, including power to the MCU, programming via JTAG, generating PWM signals, establishing communication with external devices like the ESP-32, and verifying GPIO functionality. Key features of the MCU include its 3.3V operating voltage, 16 ePWM channels, and 40 GPIO pins.

The PCB was built with reference from the C2000 Launchpad development board, an evaluation board that TI created to incorporate the TMS320F280049C MCU for developmental purposes. The following sections of the document detail the design of the PCB which focuses on GPIO allocation, Power, Programming, and Miscellaneous parts.

3.2.2.1. General-Purpose Input/Output (GPIO)

The figure below details the GPIO allocation within the PCB schematic. Figure 21: GPIO PCB Schematic

The GPIO pins contain specific features, pins with the ability to generate PWM signals and additional GPIO functionality were considered when deciding what pins to implement to headers. In the next PCB revision, all the GPIO pins from the MCU will be routed to 2.54mm x 2.54mm headers. The first 16x pins (GPIO0-GPIO15) include the 16x ePWM modules and will be reserved solely for PWM generation. The MCU contains 35 accessible GPIO pins, 19 of which are used in the current PCB design. These pins allow testing of the ePWM modules and generic input/output writing to GPIOs.

25

Subsystem Reports Revision - 0

42: Multi-Axis Cobot For Factory Automation

In the above figure, GPIO pins 2 - 13 were used to develop PWM signals for the motor driver subsystem. Additionally, these pins were used to toggle LEDs, showcasing GPIO functionality and timing, as well as rotate servo and stepper motors. The additional GPIO pins were used to connect the ESP-32 and C2000 to communicate through high/low signal generation.

One BLDC motor requires three motor drivers, one motor driver for each phase of the motor. Each motor driver will receive a high and low PWM signal, a fault check signal, and reference voltage. The below table showcases the necessary signals to be sent from the MCU to three motor drivers. The signals include PWM generation, fault check, and reference voltage.

Pin Number | Signal Name | Description | Purpose
79 | GPIO0 | ePWM-1 Output A | High PWM
78 | GPIO1 | ePWM-1 Output B | Low PWM
77 | GPIO2 | ePWM-2 Output A | High PWM
76 | GPIO3 | ePWM-2 Output B | Low PWM
75 | GPIO4 | ePWM-3 Output A | High PWM
89 | GPIO5 | ePWM-3 Output B | Low PWM

98 GPIO30 General I/O 30 Fault Check 99 GPIO31 General I/O 31 Fault Check 64 GPIO32 General I/O 32 Fault Check 23 A0 DAC-A Output Reference Voltage

- 3V3 Reference Voltage Reference Voltage Table 6: C2000 Pinout (Signals sent to 3x Motor Drivers)

The below table dictates the pinout between the C2000 and ESP-32. Although testing was not performed with these exact GPIO pins, other general-purpose pins were used. This table is to map out the future of what will be required. The purpose of these connections is to establish communication between the ESP-32 and C2000. The ESP-32 will toggle pins high or low based on user input to the mobile application. The C2000 will read input on the GPIO pins below to determine the desired movement from the user and generate the subsequent PWM signals.

26

Subsystem Reports Revision - 0

42: Multi-Axis Cobot For Factory Automation

Pin Number | Signal Name | Description | Purpose
56 | GPIO24 | General-Purpose Input Output 24 | UP
57 | GPIO25 | General-Purpose Input Output 25 | DOWN
58 | GPIO26 | General-Purpose Input Output 26 | LEFT
59 | GPIO27 | General-Purpose Input Output 27 | RIGHT
1 | GPIO28 | General-Purpose Input Output 28 | OPEN
100 | GPIO29 | General-Purpose Input Output 29 | CLOSE

Table 7: C2000 Pinout for ESP-32 Connectivity

3.2.2.2. Power

This section details the power design for the MCU. The MCU operates at 3.3V, which is supplied through the terminal block and will allow integration with the power subsystem. To maintain stable voltage, decoupling capacitors on the VDD, VDDA, and VDDIO pins were placed with values of 0.1uF, 10uF, and 2.2uF. Additionally, power indicator LEDs were included to display when the system is powered.

Figure 22: Power PCB Schematic

27
