HomeboiWoods/403-ecen-cobot/403/Sponsor Syncs/Sync 2.docx

Questions:

1. Can you give us a block diagram for the cobot?
  a. Will find/make one
2. Specific OPN for Motor Driver, Power IC, C2000 MCU
  a. 8161/8162 (base 8161 what we want)
  b. Look into boost converters, regulators (look into this once everything else is more defined)
  c. C2000-F280049C
3. Specific motors that are best suited for our motor driver
  a. BLDC (brushless motors)
4. Is the motor driver a 1-1 pairing with a motor (ex 1 motor for 1 motor driver?)
  a. 3 motor drivers for 1 motor (specifically for the 8161)
5. Does TI have any reference designs for cobots/robots?
  a. Will check/find another source
6. Softwares that will be required to complete the project? Altium, Solidworks, any third party?
  a. Altium (PCB design)
  b. C2000 CCS TI software (motorware sdk)
  c. AutoCAD (AVS 3D material) (PVC pipe)
7. Do you recommend creating a physical controller or designing a phone app to control the robot wirelessly?
  a. Phone app (wifi or bluetooth)
8. Can we connect a wireless/bluetooth hub to the robot as the connection point between the cobot and control device?
  a. Bluetooth Driver or Wifi Card
9. Clarifying the load we will be carrying (boxes, metal, small items, etc.)
  a. Up to us, able to show its use case (caters to the industry well)
  b. Can be a specific-sized box with different weights, can function like a crane game, picking up items with a tweezer-type device
10. If we are trying to show different use cases, should we have pinchers and a hook in a 2-in-1 setup or interchangeable?
  a. two options are ideal
11. Cost breakdown, how to budget the 400 well
  a. Try to state cost-effective but necessary things can be written off (motors, material cost, etc.)
  b. May need to pay out of pocket if there is a time constraint
12. Design of cobot?
  a. 4-5 either 1 or 360 degree rotation points.

Motors:

AM0820-V6 DC Motor

https://www.faulhaber.com/en/products/series/am0820/

# Nema 34 Stepper Motor

https://www.amazon.com/Stepper-Motor-4-5Nm-Length-Router/dp/B077XF6LG2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

Takeaway:

- Reduce payload to 1-3 lbs max
- Get part list approved by joshua by friday
- Ask about realistic expectations
- Align on an arm pincher (amazon??)
- Go over scope again
- Block diagram flowchart
