HomeboiWoods/403-ecen-cobot/403/Sponsor Syncs/Sync 3.docx

9/20/2024

Questions:

1. Steps to order 4 EVMs today?
2. Motor Driver EVM
3. Subsystem specific question
  a. End demo deliverable goal
    i. PCB board with MCU, connectivity to motor drivers, and ESP32
    ii. Schematic / PCB layout help w/ Altium (dedicated session?)
