HomeboiWoods/403-ecen-cobot/404/Documents/Weeky Sync/Weekly Sync 2_11_2025.docx

Weekly Sync 2/11/2025

Team 42

Updates:

Emily Hamsa - Parts and board arrived and completed soldering yesterday. No major testing yet, but used a multimeter to test continuity throughout the circuit and so far everything has a strong connection. Planning to finish testing more thoroughly this week and potentially begin integration testing this week, if not early next week. Working with Jaishil on the physical design, and have completed a mock up of the new base and plan to work on fabricating it later this week.

Ethan Woods - Finished soldering final PCB board and connected to LaunchPad to generate movement for the 3 Phase BLDC Motor. Began working on integration with Adrian and the code needed for movement. The coming weeks will be all about getting correct code to work for integration with the MCU and the rest of the system. Below is a video demonstrating the movement we achieved.

Link to video: https://drive.google.com/file/d/16V4YYAg-0SGd6Bp7KqsLWm0XdlPScUUf/view?usp=sharing

Jaishil Shah - Finished Mobile Application for Cobot Integration and have begun testing sending signals from: App → ESP32 → Cobot. This week I will focus on successfully getting those signals to send per the requirements of the servos/cobot, and also creating the physical apparatus. The prototype design was completed last week, and we will be going into the fabrication shop and putting the materials together this week.

Adrian Guzman - Working on programming 5x servo motors on cobot using the C2000 MCU. This has been a difficult task especially when trying to give input from ESP32 to control C2000 output. Also the motor driver board works with GUI, however flashing code using CCS for movement has made no progress.
