HomeboiWoods/403-ecen-cobot/403/Presentations/403/Bi-Weekly Update Presentation/Bi-Weekly Update Presentation #1.pptx

## Project name: Multi-Axis Cobot For Factory Automation Team members: Adrian Guzman, Emily Hamsa, Ethan Woods, Jaishil Shah


Notes: Ethan

## Project Description

Problem statement:
- Factory settings pose dangerous environments to human workers through the exposure to heavy machinery, tight spaces, and repetitive workloads. These hazards increase chance of injury and worker burnout. We need to implement collaborative robots (Cobots) to improve worker conditions.

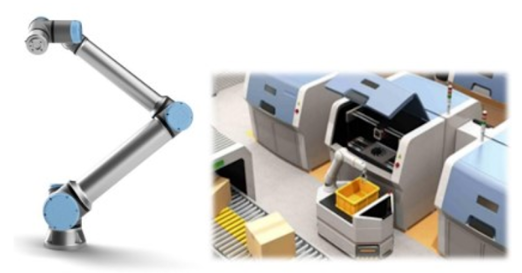
[picture p28: figure]

Cobot Solution

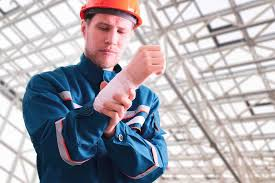
[picture p29: figure]
injury in the manufacturing industry ...
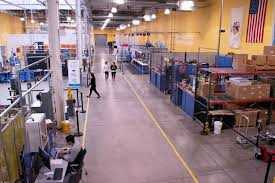
[picture p30: figure]
More workers find a four-day workweek ...

Human Injury & Burnout in Warehouses

Notes: Adrian

## Project Description

Solution proposal:
- Develop a Cobot that can integrate into a factory environment to reduce human injury, worker burnout, and increase productivity in repetitive tasks. The Cobot shall be able to lift (1-2lbs) and be placed into tight environments and controlled wirelessly through mobile app.

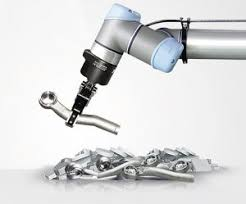
[picture p31: figure]
Bin Picking ...

1-2 lbs. Load

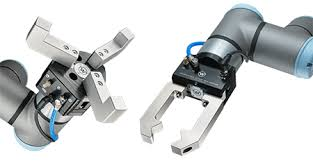
[picture p32: figure]
How to Pick the Right Gripper for Your ...

Precise Control

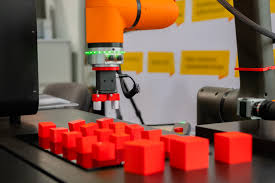
[picture p33: figure]
Industrial Robot for Pick and Place ...

Repetitive Tasks

Notes: Ethan

## Subsystem Division

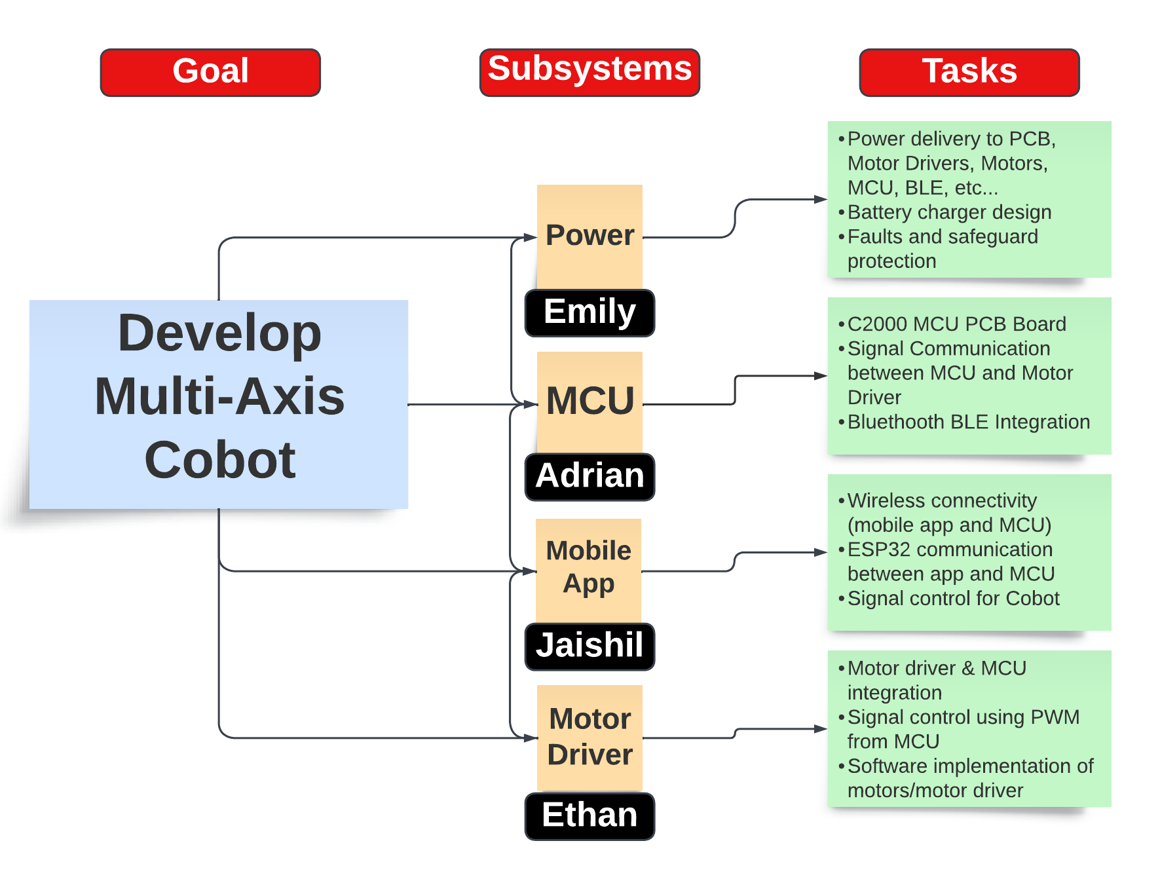
[picture p34: figure]

Subsystem Intro Projects:

i) Microcontroller
- Adrian Guzman
ii) Electronic Circuits
- Emily Hamsa
- Ethan Woods
iii) Application Development
- Jaishil Shah

Notes: Emily

## Diagram of subsystems and interface


Subsystem Diagram Color: Power, MCU/Connectivity, Mobile App, Motor Control

Notes: Jaishil

## Slide 6

Motor/Motor Driver Subsystem
Ethan Woods

Accomplishments since the last presentation <18> hrs spent | Ongoing progress/problems and plans until the next presentation
Research and Create Possible Motor List Completed CONOPS, FSR, ICD Calculate Motor Torque Ranges for all Motors Subsystem Design Project Pick Motors based on Calculated Values | Figure out Budget for Motors Motors are EXPENSIVE Order a Motor and begin working with EVM Board Begin Learning and Understanding PWM signals for Motor Movement

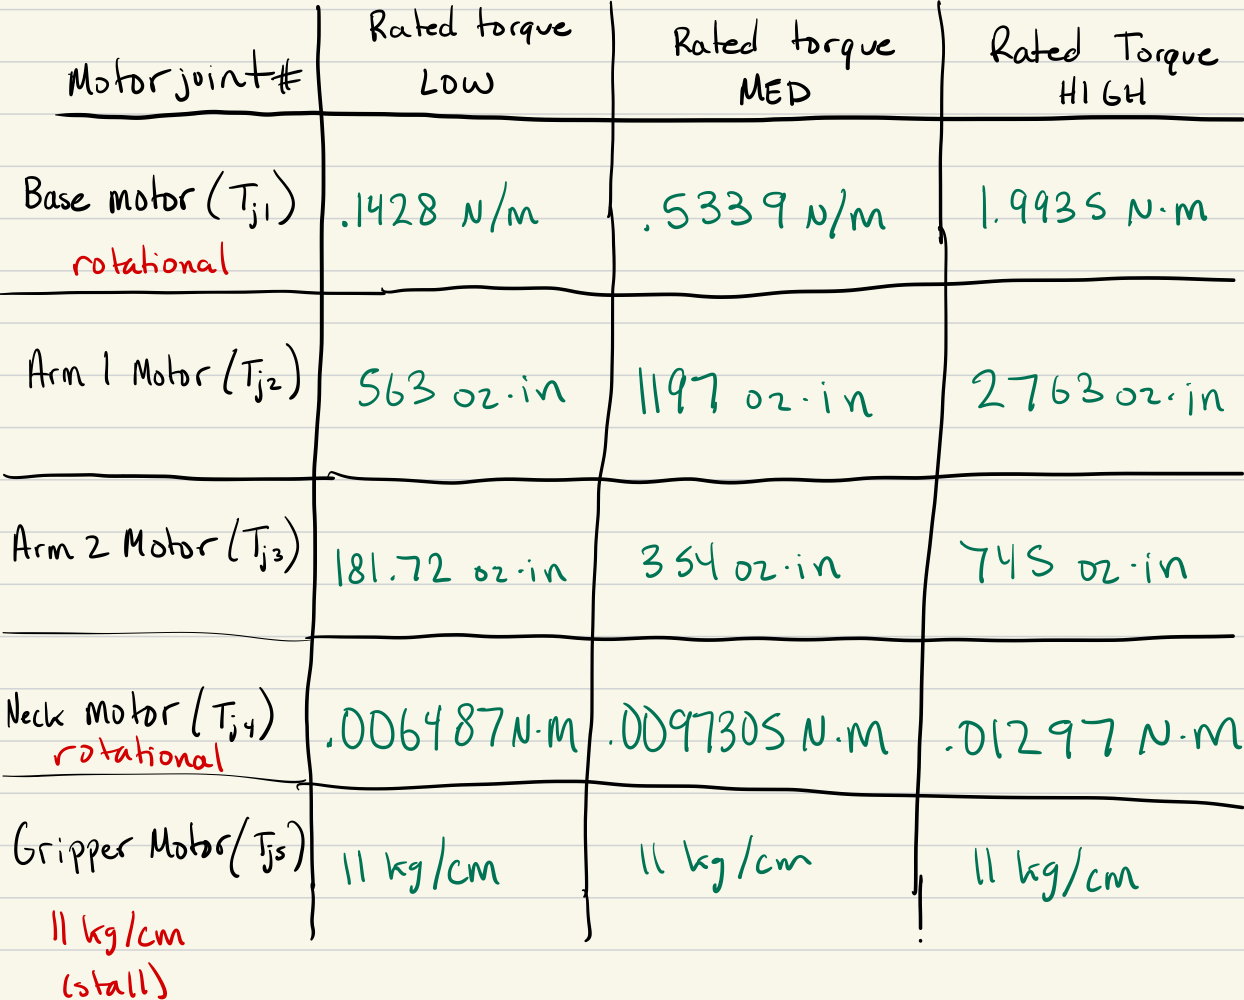
[picture p35: figure]

List of Calculated Torques for Motors #1 - #5

List of Chosen Motors:
- 57BSA Series BLDC Motor
- NEMA 34 Hudson Servo Motor !!!
- NEMA 23 Hudson Servo Motor !!!
- 42BYA Series BLDC Motor
- MG996R Servo Motor (gripper)
Total Estimated Cost: $668!!!

## Slide 7

MCU/Processing
Adrian Guzman

Accomplishments since the last presentation <~30 hrs> | Ongoing progress/problems and plans until the next presentation
MCU Power MCU + ESP-32 Connectivity Motor Driver x3 Power Stage x3 Schematic order and neatness Datasheets & signals (find out what goes where) Intro Project / FSR, ICD, validation | Set GPIO and PCB headers for motor signals Review schematic and begin PCB layout Order PCB, components, and assemble C2000 Launchpad software development (write code to blink LED)

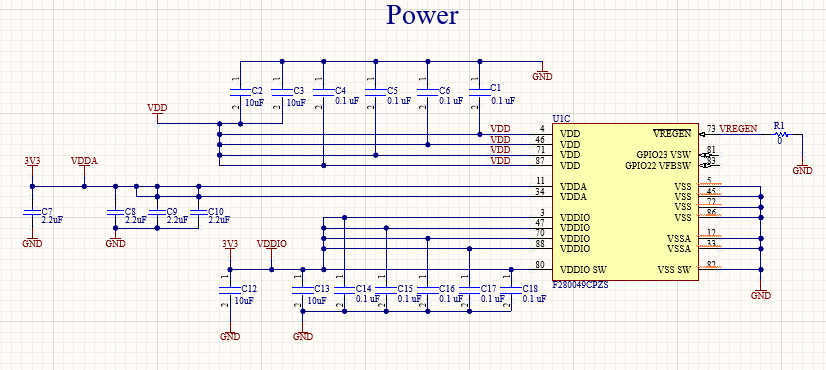
[picture p36: figure]
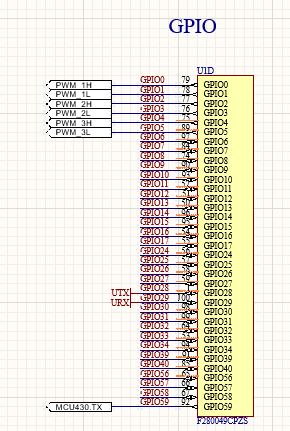
[picture p37: figure]
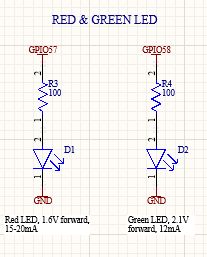
[picture p38: figure]

## Slide 8

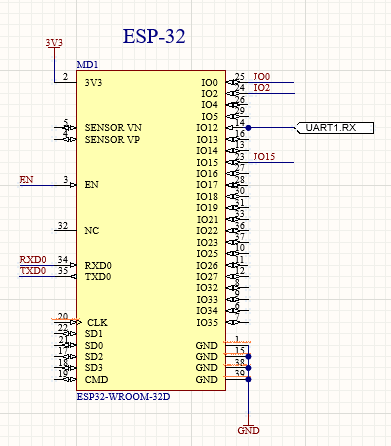
[picture p39: figure]
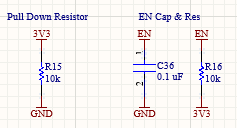
[picture p40: figure]
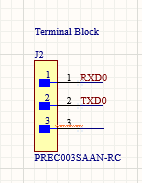
[picture p41: figure]

## Slide 9

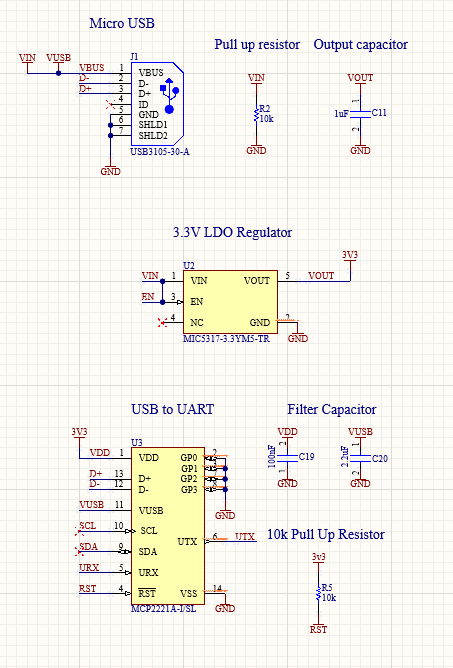
[picture p42: figure]

## Slide 10

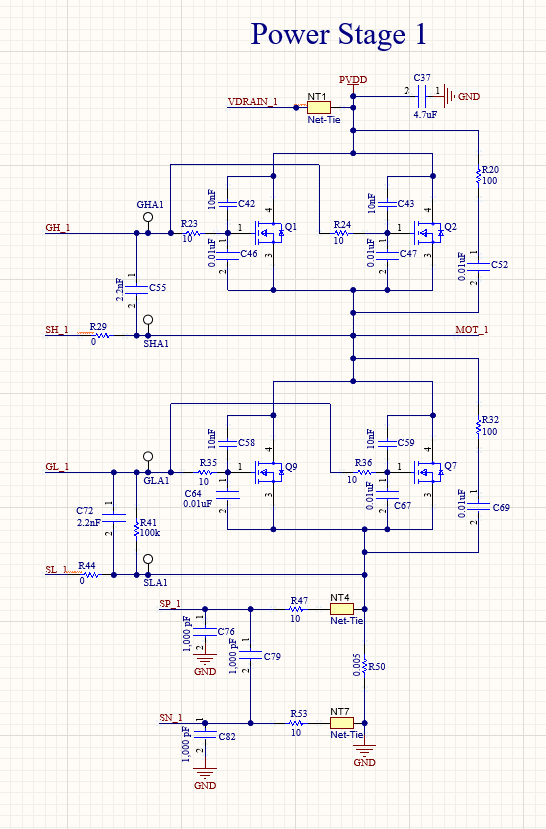
[picture p43: figure]
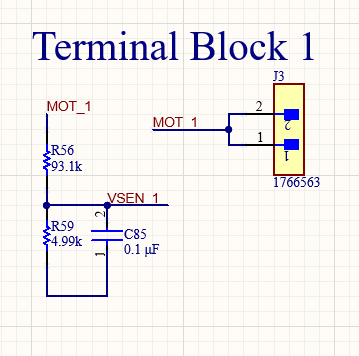
[picture p44: figure]
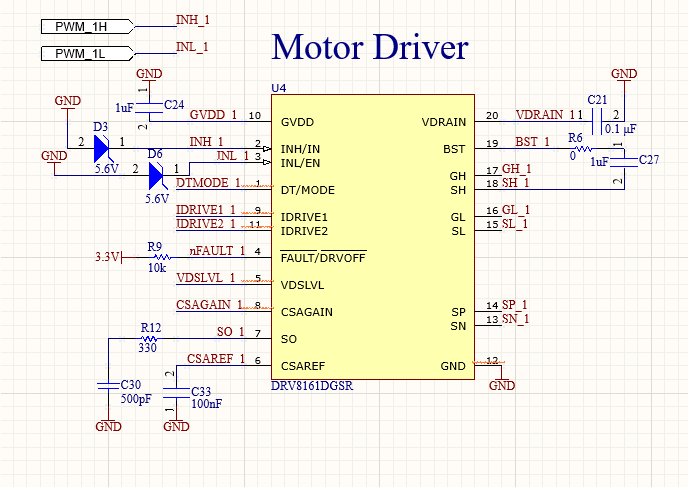
[picture p45: figure]

3x Instances of (power stage, terminal block, motor driver…1 for each phase)

## Slide 11

Power and Battery Management
Emily Hamsa

Accomplishments since the last presentation <~16> hrs | Ongoing progress/problems and plans until the next presentation
Researched battery capacity sizing Completed on CONOPS, FSR, ICD Subsystem Design Project Completed Load List and battery calculations Used TI WeBench to begin schematic design | Complete schematic designing and combine into one PCB Multiple rails with multiple current requirements, learn best way to connect Send board to be produced Choose a battery with calculated capacity Begin planning charging PCB

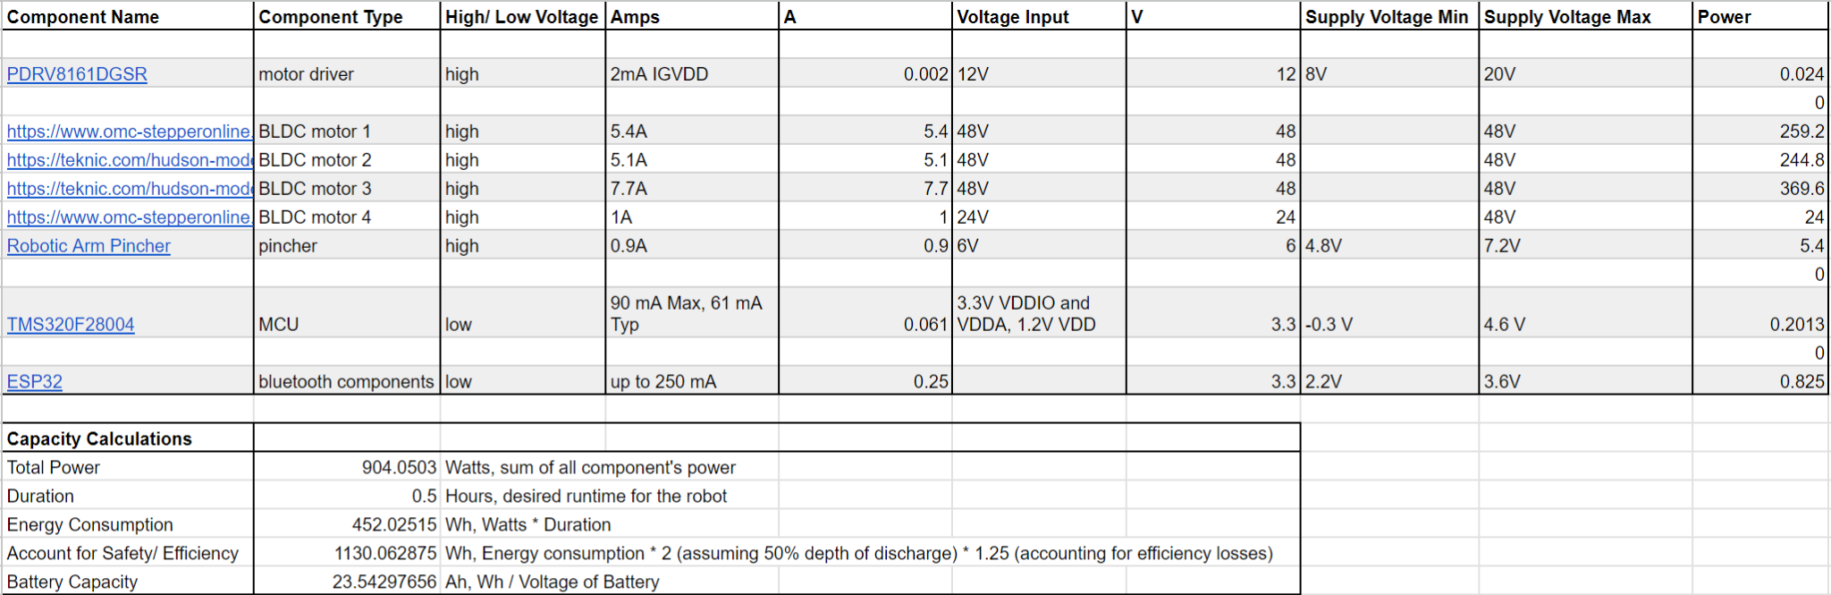
[picture p46: figure]

## Slide 12

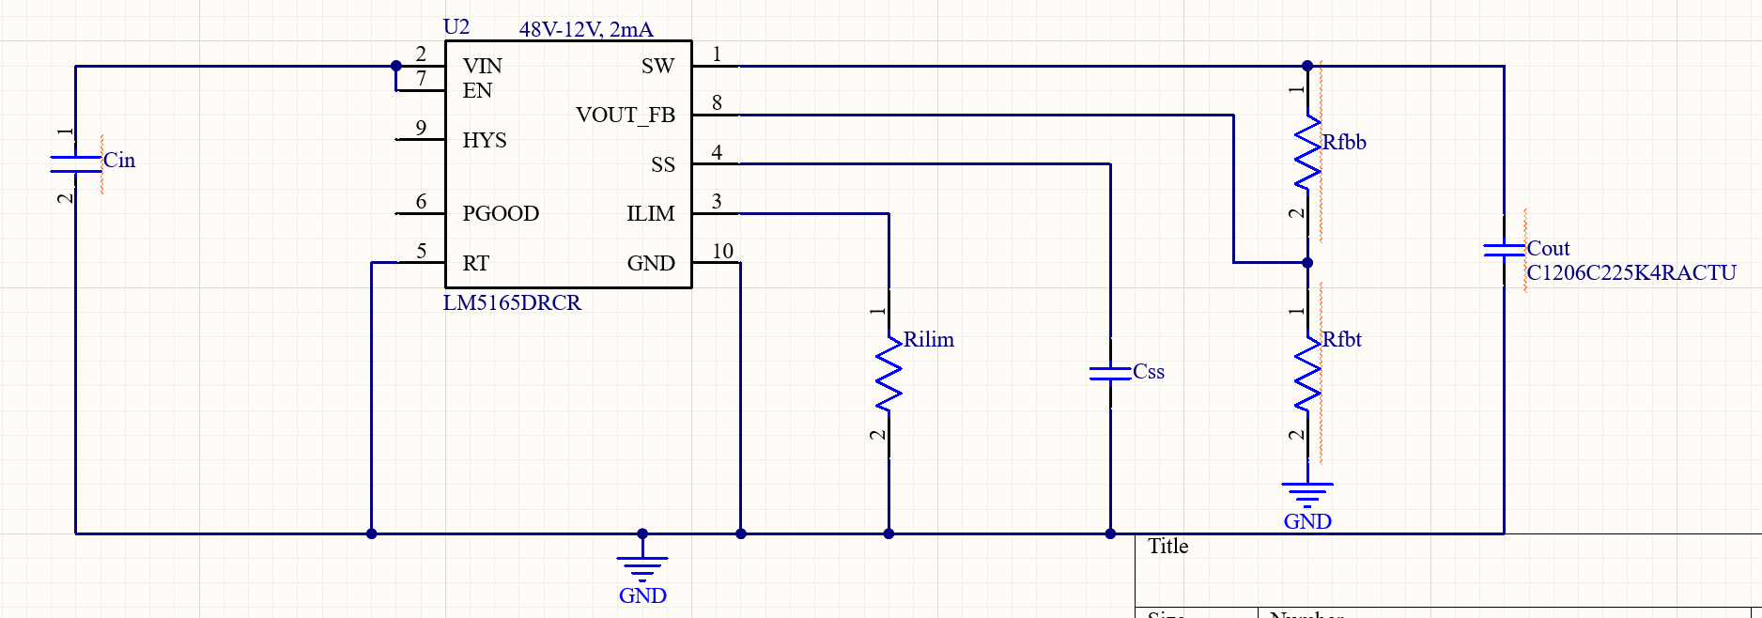
[picture p47: figure]

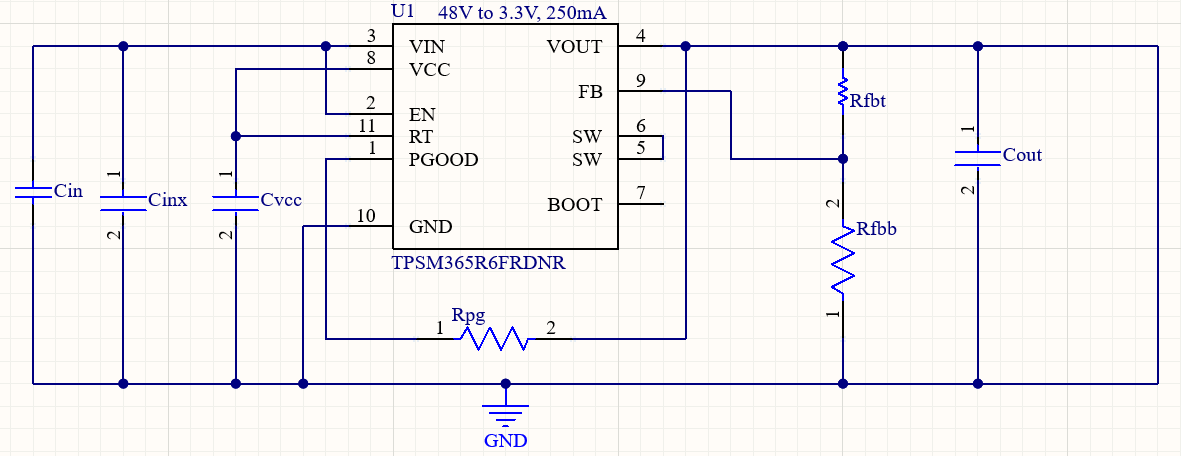
[picture p48: figure]

## Slide 13

User Interface / Wireless Connectivity
Jaishil Shah

Accomplishments since the last presentation <~17 ½ > hrs | Ongoing progress/problems:
- Subsystem Intro. Project <3> hrs - Completion of the following documents: CONOPS, FSR, ICD <4> hrs - Subsystem Bluetooth integration <3> hrs - ESP-32 Connectivity (Arduino IDE) <3> hrs - App Store Connect Setup/Testflight <2> hrs - Flutterflow Beginner Course <2 ½ > hrs | 1. Fixing current bluetooth config. & ESP-32 setup 2. Secure ESP-32/Bluetooth connection with low latency 3. Breadboard -> PCB for ESP-32 4. Deployment of final application onto the App Store

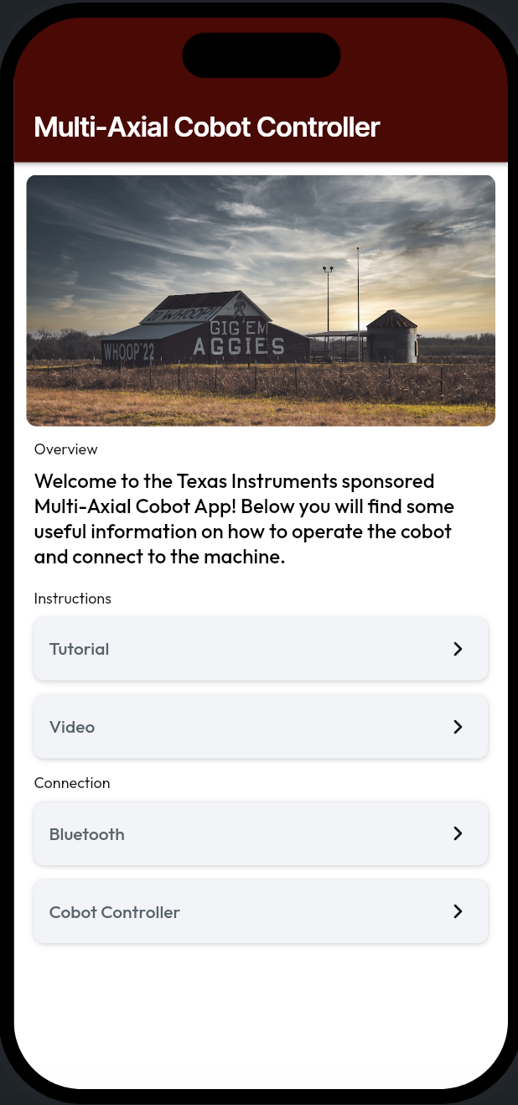
[picture p49: figure]

List of Bluetooth Functions:
1. connectDevice 2. disconnectDevice
3. findDevices 4. getConnectedDevices
5. getRssi 6. isBluetoothEnabled
7. receiveData 8. sendData

Important Tools:
1. flutter_blue_plus 1.33.4
2. Bluetooth Low Energy
3. Arduino IDE 2.1.0

## Execution plan

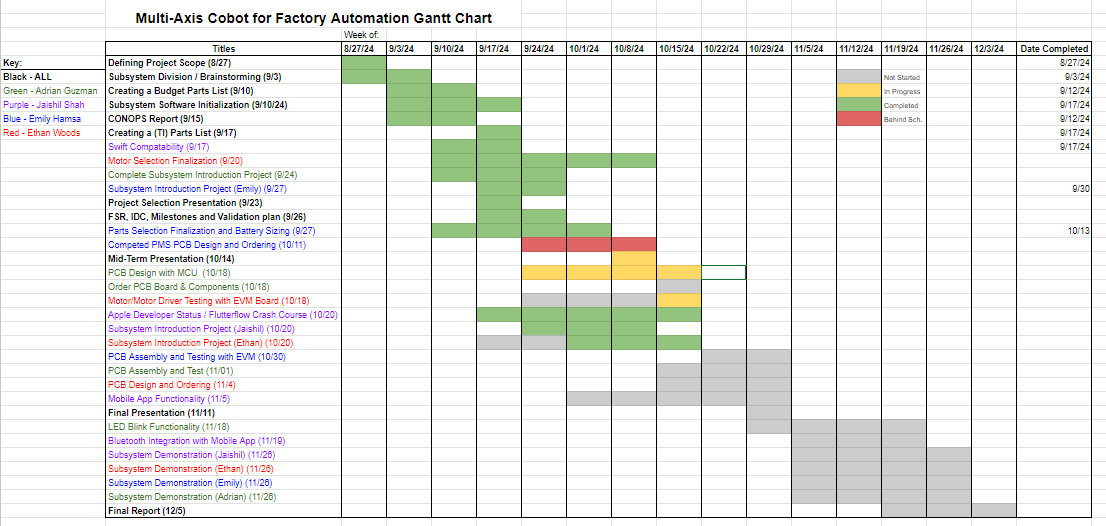
[picture p50: figure]

## Validation plan

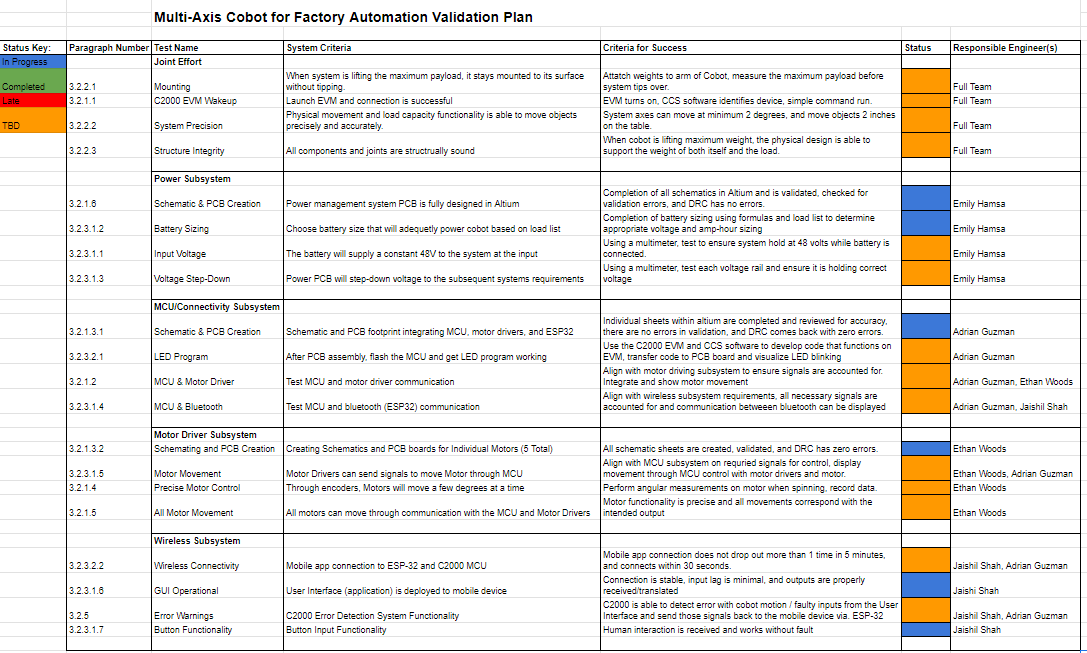
[picture p51: figure]

Notes: Jaishil
