HomeboiWoods/403-ecen-cobot/403/Presentations/403/Bi-Weekly Update Presentation/403 bi-weekly update presentation template.pptx

## Project name: TI deep sea diver .. Team members:.. Mickey, Donald …

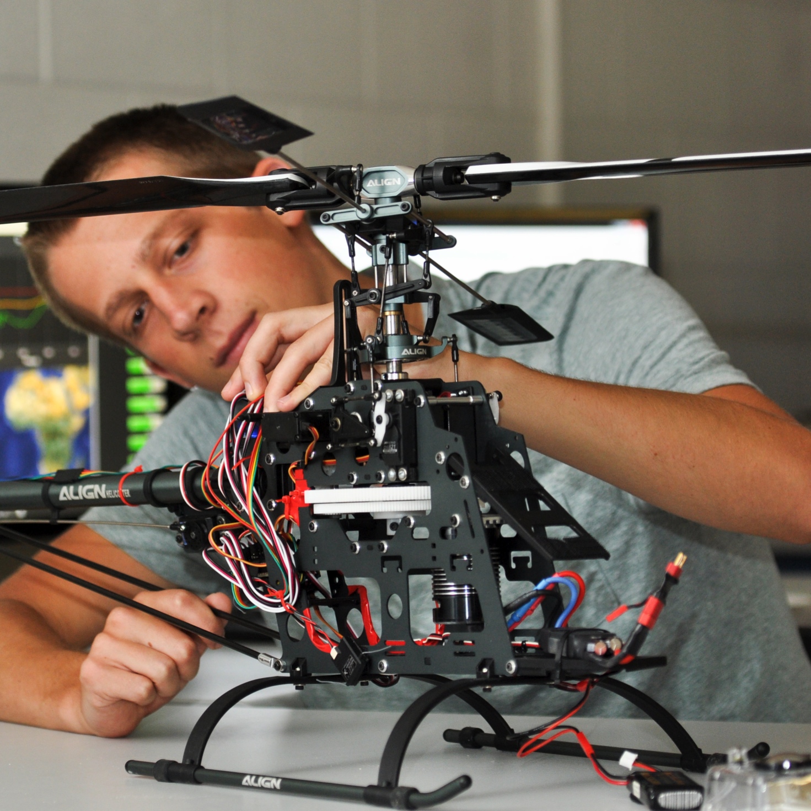
[picture p60: figure]

## Project description (use pictures and diagrams to describe)

- Problem statement: “Deep sea diving is very dangerous and we need a way to enable it while reducing harm to humans. With more and more underwater projects (oil and gas, server farms, food sources etc)”

## Project description (use pictures and diagrams to describe)

- Solution proposal: “Develop nimble and relatively inexpensive robots that can do the majority of the tasks a human can, initially under the direction of a human and eventually more independantly”

## Diagram of subsystems and interface (use colors or other to show ownership)

## Slide 5

-Subsystem(s) Name-
Team Member 1

Accomplishments since the last presentation <XX> hrs (track your hours) | Ongoing progress/problems and plans until the next presentation

Subsystem Picture, Sketch, or Graph (1 per team member)

## Execution plan

- Updated to show progress or slip…highlight differences

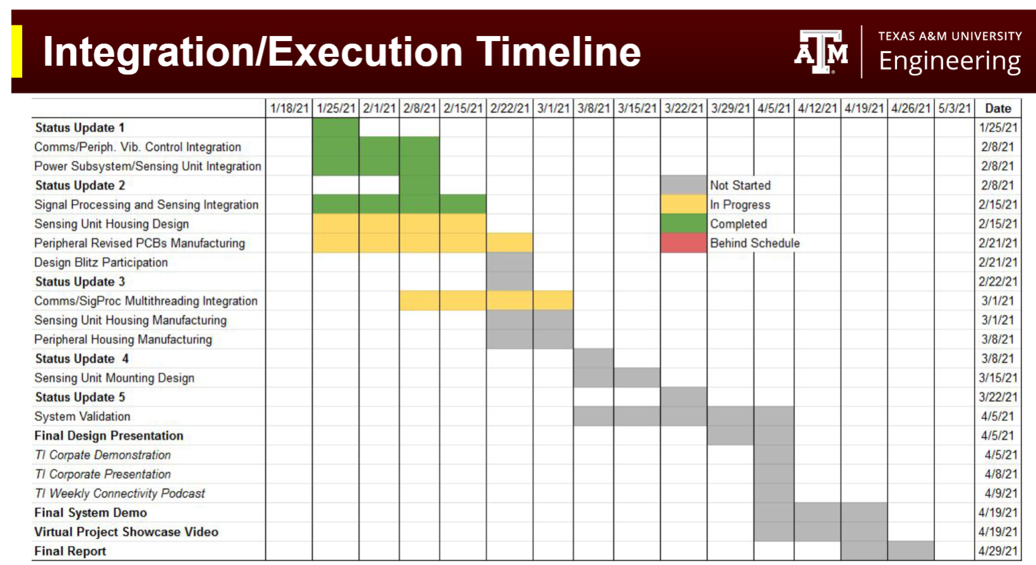
[picture p61: figure]

## Validation plan

- Update Validation Plan….what has been tested?

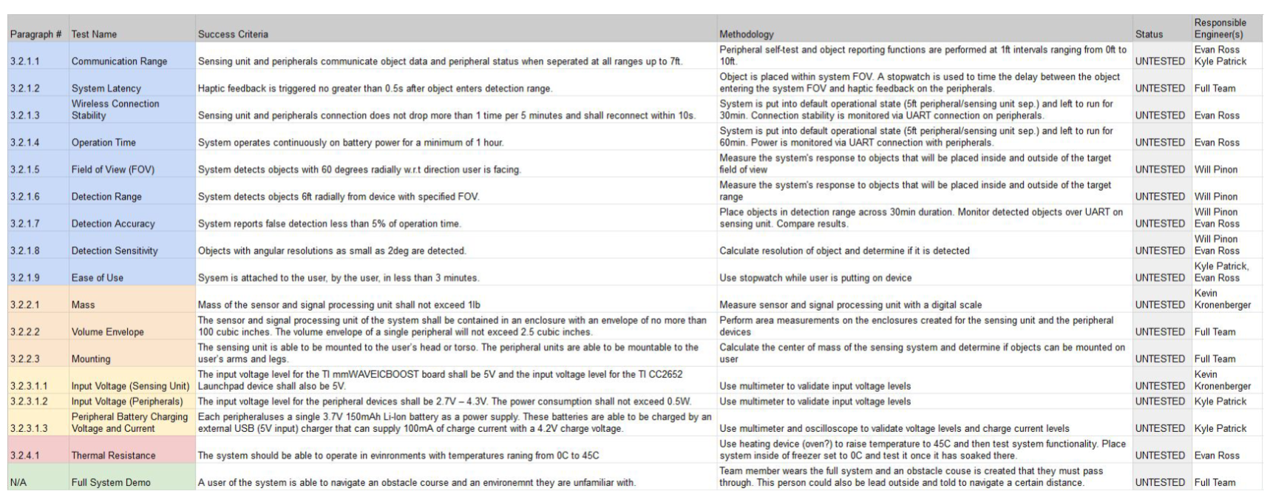
[picture p62: figure]
