HomeboiWoods/403-ecen-cobot/403/Presentations/403/Project Selection Presentation/403 project selection presentation template.pptx

## Project name: Multi-Axis Cobot For Factory Automation Team members: Adrian Guzman, Emily Hamsa, Ethan Woods, Jaishil Shah


## Project description (use pictures and diagrams to describe)

- Problem statement: “Deep sea diving is very dangerous and we need a way to enable it while reducing harm to humans. With more and more underwater projects (oil and gas, server farms, food sources etc)”

## Project description (use pictures and diagrams to describe)

- Solution proposal: “Develop nimble and relatively inexpensive robots that can do the majority of the tasks a human can, initially under the direction of a human and eventually more independantly”

## Diagram of subsystems and interface (use colors or other to show ownership)

## Task partition

- Mickey: “design grippers and articulation mechanism”
- Donald: “Develop human interface and couple with machine learning to expnd over time”
- …

## Subsystem progress in past 1.5 months

- Tables describing part tradeoff leading to ones picked
- The following parts have been ordered
- These are the results of the simulations
- …

## Execution plan

- See example on ecampus…
- Spreadsheet with biweekly deliverables that are measurable and have owners

## Validation plan

- See example on ecampus…
- Spreadsheet with deliverables that are measurable and have owners
