HomeboiWoods/403-ecen-cobot/403/Documents (old)/AdrianGuzman/software/BlinkyLED_2LED.txt

#include "F28x_Project.h"

#define DEVICE_GPIO_PIN_LED1  34  // LED 1 (GPIO 34)
#define DEVICE_GPIO_PIN_LED2  23  // LED 2 (GPIO 23)

void main(void)
{
    // Initialize device clock and peripherals
    InitSysCtrl();

    // Initialize GPIO and configure both pins as push-pull outputs
    InitGpio();
    GPIO_SetupPinMux(DEVICE_GPIO_PIN_LED1, GPIO_MUX_CPU1, 0);
    GPIO_SetupPinOptions(DEVICE_GPIO_PIN_LED1, GPIO_OUTPUT, GPIO_PUSHPULL);

    GPIO_SetupPinMux(DEVICE_GPIO_PIN_LED2, GPIO_MUX_CPU1, 0);
    GPIO_SetupPinOptions(DEVICE_GPIO_PIN_LED2, GPIO_OUTPUT, GPIO_PUSHPULL);

    // Initialize PIE and disable interrupts
    DINT;
    InitPieCtrl();
    IER = 0x0000;
    IFR = 0x0000;
    InitPieVectTable();
    EINT;
    ERTM;

    // Loop forever, blinking both LEDs
    for(;;)
    {
        // Turn on both LEDs
        GPIO_WritePin(DEVICE_GPIO_PIN_LED1, 0);
        GPIO_WritePin(DEVICE_GPIO_PIN_LED2, 0);

        // Delay
        DELAY_US(500000);

        // Turn off both LEDs
        GPIO_WritePin(DEVICE_GPIO_PIN_LED1, 1);
        GPIO_WritePin(DEVICE_GPIO_PIN_LED2, 1);

        // Delay
        DELAY_US(500000);
    }
}
