HomeboiWoods/403-ecen-cobot/403/Pictures/project description.png

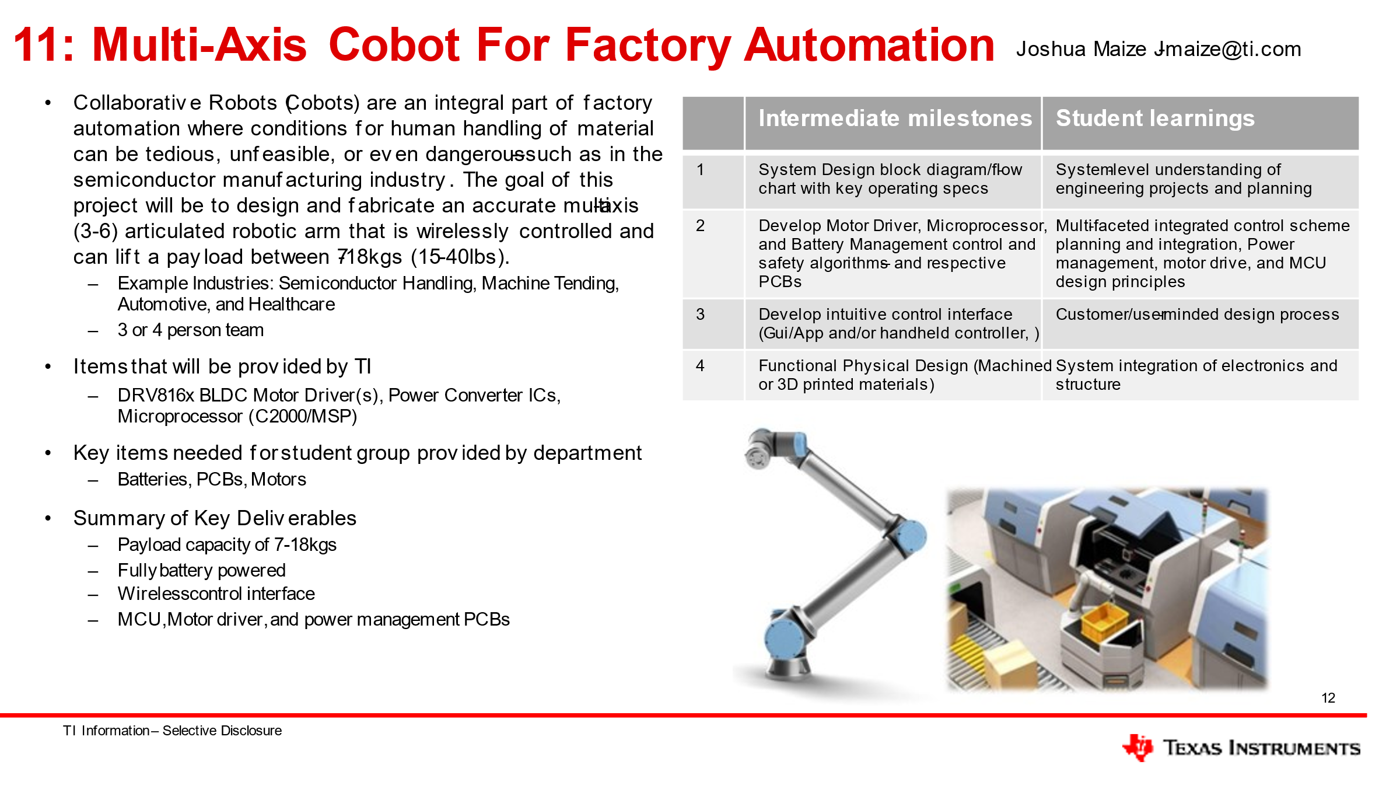
403/Pictures/project description.png
