HomeboiWoods/403-ecen-cobot/403/Purchasing Sheet.xlsx

Sheet: Sheet3
Order Date | Part Number | Item Name | Location Buy From | Cost | Name | Quantity | Total Cost | Description
2024-10-22 | Components DigiKey | Components | Digikey | $46.25 | Adrian | 19 | $46.25 | https://www.digikey.com/en/mylists/list/YQ2E290VIO
2024-10-22 | Components Mouser | Components | Mouser | $10.63 | Adrian | 2 | $10.63 | https://www.mouser.com/ProjectManager/ProjectDetail.aspx?AccessID=fa0c635bec
2024-10-22 | PCB Order | PCB | PCBWay | $20.06 | Adrian | 5 | $20.06 | 1st order for MCU PCB boards
2024-10-22 | Components Digikey | Components | Digikey | $114.83 |  |  | $114.83
2024-10-23 | Components Digikey | Components | Digikey | $14.78 |  |  | $14.78
2024-10-23 | Components Mouser | Components | Mouser
2024-10-23 | PCB Order | PCB | JLPCB | $30.08 |  |  | $30.08
2024-09-25 | Apple Dev. Account | Subscription | Apple | $99 + ($8.17) | Jaishil | 1 | $107.17
2024-11-07 | PCB Order | PCB | JLCPCB | $24.58 + ($5.47) | Jaishil | 5 | $150.24
2024-11-07 | Digikey Components | Components | DigiKey | $30.61 + ($13.01) | Jaishil | 1 | $43.65
Initial Budget | $400.00
Remanining | -$137.69

Sheet: Wishlist
Order Date | Part Number | Item Name | Location to Buy From | Cost per Part | Quantity | Total Cost | Item Description
 |  | LAUNCHXL-F280049C | https://www.ti.com/tool/LAUNCHXL-F280049C#order-start-development | $39.00 | 2 | $78.00 | EVM board for the C2000 real time microcontroller | *Should be bought by TI
 |  | F280049CPMS | https://www.ti.com/product/TMS320F280049C/part-details/F280049CPMS | $8.95 | 2 | $17.89 | MCU that will be used in PCB design
 |  | ESP32 | https://www.amazon.com/LAFVIN-Starter-Development-Tutorial-Compatible/dp/B0BVZBTP8V | $19.99 | 1 | $19.99 | ESP32 kit for BLE connectivity
 |  | DRV8161EVM | https://www.ti.com/tool/DRV8161EVM | $229.00 | 1 | $229.00 | EVM board for the 8161x Motor Drivers | *Should be bought by TI
 |  | PDRV8161DGSR (https://www.ti.com/product/DRV8161/part-details/PDRV8161DGSR) | https://www.ti.com/product/DRV8161/part-details/PDRV8161DGSR | $1.13 | 15 | $16.96 | BLDC 8161 Motor Driver Chip
 |  | Anti Static Wrist Strap | https://www.amazon.com/Wristband-Bracelet-Grounding-Alligator-Extendable/dp/B08CXQN86W?hvadid=631610895767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 | $6.99 | 2 | $13.98 | Anti-Static Bracelet
 |  | Robotic Arm Pincher | https://www.amazon.com/Professional-Mechanical-Educational-Raspberry-Platform/dp/B08WPZ9FGW | $26.99 | 1 | $26.99 | Professional Metal Robot Arm/Gripper | *amazon
 |  |  |  |  | Order Total Cost | $402.82
 |  |  |  |  | Spend to Date | $402.82
Texas Instument Parts Needed |  |  |  |  | Summary of Parts: |  | LAUNCHXL-F280049C (C2000 EVM) | 4x
 |  |  |  |  | C2000 EVM | 4x | DRV8161EVM (DRV8161 EVM Board) | 1x
MCU Subsystem |  | 1x | LAUNCHXL-F280049C (C2000 EVM) |  | C2000 MCU | 2x
 |  | 2x | F280049CPZS (C2000 MCU) |  | 8161 Motor Drivers | 15x
 |  |  |  |  | 8161 EVM | 1x
Motor Driver Subsystem |  | 1x | LAUNCHXL-F280049C (C2000 EVM Board)
 |  | 15x | PDRV8161DGSR (8161 Motor Driver)
 |  | 1x | DRV8161EVM (DRV8161 EVM Board)
Wireless Connectivity Subs. |  | 1x | LAUNCHXL-F280049C (C2000 EVM Board)
 |  | 1x | ESP32 (Bluetooth Driver)
Battery Subsystem |  | 1x | LAUNCHXL-F280049C (C2000 EVM Board)

Sheet: Possible Motor Options
Name | Website | Dimensons (mm) | Encoder (Y/N) | Voltage (V) | Rated Current (A) | RPM (rpm) | Rated Torque (N.m) | Weight (kg) | Cost ($) | Rating (if applicable)
Encoder Metal Gearmotor | https://www.amazon.com/Motor-Encoder-Speed-Gearmotor-Robotics/dp/B07GNDG2NC | -- | Y | 12 | 0.15 | 60 | 0.024 | 0.27 | 14.88 | 4
42BSB101-48-01 | https://www.omc-stepperonline.com/48v-3000rpm-0-25nm-79w-2-30a-42x42x101mm-brushless-dc-motor-42bsb101-48-01 | 42x42x101 | Y (Hall Sensor) | 48 | 2.3 | 3000 | 0.25 | 0.88 | 29.35 | N/A
42BSA78-48-01 | https://www.omc-stepperonline.com/48v-3000rpm-0-24nm-75w-2-40a-42x42x78mm-brushless-dc-motor-42bsa78-48-01 | 42x42x78 | Y (Hall Sensor) | 48 | 2.4 | 3000 | 0.24 | 0.68 | 32.02 | N/A
42BSB61-48-01 | https://www.omc-stepperonline.com/48v-3000rpm-0-125nm-39w-1-20a-42x42x61mm-brushless-dc-motor-42bsb61-48-01 | 42x42x61 | Y (Hall Sensor) | 48 | 1.2 | 300 | 0.125 | 0.5 | 21.35
57BSD116-48-01 | https://www.omc-stepperonline.com/48v-3000rpm-0-6nm-188w-5-40a-57x57x116mm-brushless-dc-motor-57bsd116-48-01 | 57x57x116 | Y (Hall Sensor) | 48 | 5.4 | 3000 | 0.6 | 1.4
42BLS60-24-01 | https://www.omc-stepperonline.com/24v-4000rpm-0-125nm-52-5w-3-4a-42x42x60mm-brushless-dc-motor-42bls60-24-01 | 42x42x59 | Y (Hall Sensor) | 24 | 3.4 | 6500 | 0.125 | 0.6 | 24.85
42BSA62-24-01 | https://www.omc-stepperonline.com/24v-3000rpm-0-16nm-50w-3-30a-42x42x62mm-brushless-dc-motor-42bsa62-24-01 | 42x42x62 | Y (Hall Sensor) | 24 | 3.3 | 3000 | 0.16 | 0.53 | 24.02
57BYA54-24-01 | https://www.omc-stepperonline.com/24v-3000rpm-0-16nm-50w-2-90a-57x57x53-5mm-brushless-dc-motor-57bya54-24-01 | Φ57x53.5mm | Y (Hall Sensor) | 24 | 2.9 | 3000 | 0.16 | 0.57 | 24.02
57BSA58-24-01 | https://www.omc-stepperonline.com/24v-3000rpm-0-2nm-63w-3-60a-57x57x58mm-brushless-dc-motor-57bsa58-24-01 | 57x57x58 | Y (Hall Sensor) | 24 | 3.6 | 3000 | 0.2 | 0.7 | 29.35
86BSA108-48-01 | https://www.omc-stepperonline.com/48v-3000rpm-1-4nm-440w-11-70a-86x86x108mm-brushless-dc-motor-86bsa108-48-01 | 86x86x108 | Y (Hall Sensor) | 48 | 11.7 | 3000 | 1.4 | 3.2 | 93.39
57BYA94-48-01 | https://www.omc-stepperonline.com/48v-3000rpm-0-45nm-141w-4-00a-57x57x93-5mm-brushless-dc-motor-57bya94-48-01 | Φ57x93.5mm | Y (Hall Sensor) | 48 | 4 | 3000 | 0.45 | 1.13 | 49.36
57BSA100-48-01 | https://www.omc-stepperonline.com/48v-3000rpm-0-6nm-188w-5-40a-57x57x100mm-brushless-dc-motor-57bsa100-48-01 | 57x57x100 | Y (Hall Sensor) | 48 | 5.4 | 3000 | 0.6 | 1.35 | 58.7
57BLR90-24-01 | https://www.omc-stepperonline.com/24v-3500rpm-0-6nm-220w-14-0a-%D1%8457x89mm-brushless-dc-motor-57blr90-24-01 | Ф57x89mm | N | 24 | 14 | 3000 | 0.6 | 1.18 | 36.62
M-3411P-LN-08D | https://teknic.com/hudson-model/M-3411P-LN-08D/?model_voltage=300 | 87x72mm | Y (Incremental) | 48 | 10 | 3020 | 3.9 | 1.4 | 305
Robotic Gripper | https://www.amazon.com/Professional-Mechanical-Educational-Raspberry-Platform/dp/B08WPZ9FGW?s=toys-and-games
with motor
NEMA 34 MOTORS | https://teknic.com/products/brushless-servo-motors/hudson-motors-ready-ship/
 | Estimated LOW | Esitmated MED | Estimated HIGH | Motor Name | Part Number | Website | Motor Torque (oz-in) | Motor Torque (N-m) | Rated Voltage (V) | Peak Current (A) | Cont. (RMS) Current (A) | Encoder? (Y/N) | Encoder Type | Weight (kg) | Price ($)
MOTOR #1 (Base) | .1428 N/M | .5339 N/M | 1.9935 N/M | 57BSA series brushless motors | 57BSA100-48-01 | https://www.omc-stepperonline.com/48v-3000rpm-0-6nm-188w-5-40a-57x57x100mm-brushless-dc-motor-57bsa100-48-01 | 84.97 | 0.6 | 48 | ~ | 5.4 | Y | Hall Sensor | 1.35 | 58.7
MOTOR #2 (Arm 1) | 563 oz-in | 1197 oz-in | 2763 oz-in | NEMA 34 Hudson™ Servo Motor | M-3432S-LN-02D | https://teknic.com/hudson-model/M-3432S-LN-02D/?model_voltage=48 | 1223 | 8.6 | 48 | 20.6 | 5.1 | Y | Differential signals; incremental | 2.8 | 355-389 | POSSIBLE MOTOR CHANGE FOR #2
MOTOR #3 (Arm 2) | 181.25 oz-in | 354 oz-in | 745 oz-in | NEMA 23 Hudson™ Servo Motor | M-2311P-QN-08D | https://teknic.com/hudson-model/M-2311P-QN-08D/?model_voltage=48 | 223 | 1.6 | 48 | 30.8 | 7.7 | Y | Differential signals; incremental | 0.6 | 208-279
MOTOR #4 (Neck) | .006487 N/M | .0097305 N/M | .01297 N/M | 42BYA series brushless motors | 42BYA43-24-01 | https://www.omc-stepperonline.com/24v-3000rpm-0-04nm-13w-1-00a-42x43mm-brushless-dc-motor-42bya43-24-01 | 5.66 | 0.04 | 24 | ~ | 1 | Y | Hall Sensor | 0.3 | 20.01
MOTOR #5 (Gripper) | 11 kg/cm | 11 kg/cm | 11 kg/cm | Servo Motor in Gripper Claw | MG996R | https://www.amazon.com/Professional-Mechanical-Educational-Raspberry-Platform/dp/B08WPZ9FGW?s=toys-and-games | 152.767 | 1.07 | 6.6 | 1.4 | 0.17 | N | ~ | 0.095 | 26.99 | (motor inside the gripper)
 |  |  |  |  |  |  |  |  |  |  |  |  |  | Estimated Min ($) | 668
