HomeboiWoods/403-ecen-cobot/403/TI Purchasing Sheet.xlsx

Sheet: TI Components
Date | Item Name | Qty | Link to Order | Price Per Unit | Total Cost
2024-10-22 | LM5164DDAR | 2 | https://www.ti.com/product/LM5164/part-details/LM5164DDAR | 2.854 | 5.708
 | LMR36510FADDAR | 8 | https://www.ti.com/product/LMR36510/part-details/LMR36510FADDAR | 1.678 | 13.424
 | LM5012DDAR | 2 | https://www.ti.com/product/LM5012/part-details/LM5012DDAR | 2.182 | 4.364
 | LM5163DDAR | 4 | https://www.ti.com/product/LM5163/part-details/LM5163DDAR | 1.909 | 7.636 |  | Notes:
 | CSD19536KTT | 16 | https://www.ti.com/product/CSD19536KTT | $3.35 | $53.62 |  | Here is a list of the TI-branded components we need for our project.
 |  |  |  |  | 0 |  | If you have any questions or need any more information, let us know and we can get it to you.
 |  |  |  |  | 0
 |  |  |  |  | 0
 |  |  |  |  | 0
 |  |  |  |  | 0
 |  |  |  |  | 0
 |  |  |  |  | 0
 |  |  |  |  | 0
 |  |  |  |  | 0
 |  |  |  |  | 0
 |  |  |  |  | 0
 |  |  |  |  | 0
 |  |  |  |  | 0
 |  |  |  |  | 0
 |  |  |  |  | 0
 |  |  |  |  | 0
 |  |  |  |  | 0
 |  |  |  |  | 0
 |  |  |  |  | 0
 |  |  |  |  | 0
 |  |  |  |  | 0
 |  |  | TOTAL: $ |  | 84.748
 |  |  |  |  |  | W

Sheet: Additional Items Purchasing She
Date | Item Name | Details | Link to Order | Price
2024-10-22 | Battery | 48V 20Ah Lithium Ion battery pack for power source | https://www.amazon.com/BtrPower-48V-Battery-Lithium-ion/dp/B0C4L9SWGX | 158
2024-10-24 | BLDC Motor | NEMA 23 Hudson™ Servo Motor | https://teknic.com/hudson-model/M-2311P-QN-08D/?model_voltage=48 | 279
2024-10-25 | Debugger | TMDSEMU110-U - XDS110 JTAG Debug Probe | https://www.ti.com/tool/TMDSEMU110-U?ds_k=DYNAMIC+SEARCH+ADS&DCM=yes&gad_source=1&gclsrc=aw.ds | N/A
 |  |  |  |  | Notes:
 |  |  |  |  | Here is a list of the items we need for our project that we are needing financial assistance for.
 |  |  |  |  | If you have any questions or need any more information, let us know and we can get it to you.
 |  |  |  |  | NOTE:
 |  |  |  |  | NEMA 23 MOTOR HAS OPTION TO BUY WITH CABLE. DO NOT BUY CABLE WITH IT. IT IS EXTRA $83
 |  |  | TOTAL: $ | 437
