HomeboiWoods/403-ecen-cobot/404/Budget/Team 42 - E404 Purchasing Sheet as of 1_27_2025.xlsx

Sheet: TI Paid
Order Date | Part Number | Item Name | Location Buy From | Cost | Name | Quantity | Total Cost | Description
2024-10-29 | Components Mouser | XDS-110 Debugger | Mouser | $179.55 | Adrian | 1 | $184.39 | XDS-110 Debugger used to interface with MCU, ended up not being necessary, unused.
2024-10-29 | Battery | Battery for Power Subsystem | Amazon | $145.99 | Emily | 1 | $145.99 | Battery used for power subsystem
2024-10-29 | Motor | TEKNIC Motor | TEKNIC | $279.00 | Ethan | 1 | $279.00 | BLDC motor used in cobot
2024-10-22 | TI Components | LM5164DDAR | Texas Instruments | $2.85 | Emily/Ethan | 2 | $5.71 | 24V Voltage Converter
2024-10-23 | TI Components | LMR36510FADDAR | Texas Instruments | $1.68 | Emily/Ethan | 8 | $13.42 | 12V Voltage Converter
2024-10-24 | TI Components | LM5012DDAR | Texas Instruments | $2.18 | Emily/Ethan | 2 | $4.36 | 5V Voltage Converter
2024-10-25 | TI Components | LM5163DDAR | Texas Instruments | $1.91 | Emily/Ethan | 4 | $7.64 | 3.3V Voltage Converter
2024-10-26 | TI Components | CSD19536KTT | Texas Instruments | $3.35 | Ethan | 16 | $53.62 | MOSFETs for Phase Boards
 |  |  |  |  |  | Total | $694.13

Sheet: TI Parts 1272025
Order Date | Part Number | Item Name | Cost | Name | Quantity | Total Cost | Description
2025-01-27 | LM5012DDAR | LM5012DDAR | $2.18 | Emily | 2 | $4.36 | Step Down Converter
2025-01-27 | LM5013DDAR | LM5013DDAR | $3.80 | Emily | 2 | $7.60 | Step Down Converter
2025-01-27 | LM5164DDAT | LM5164DDAT | $3.43 | Emily | 2 | $6.85 | Step Down Converter
2025-01-27 | CSD19536KTT | CSD19536KTT | $3.35 | Ethan | 16 | $53.62 | MOSFETs. 4 extra
2025-01-27 | DRV8161DGSR | DRV8161DGSR | $1.13 | Ethan | 5 | $5.66 | DRV8161 Motor Drivers. 2 extra
 |  |  |  |  | Total Cost | $78.09

Sheet: $400 Budget
Order Date | Part Number | Item Name | Location Buy From | Cost | Name | Quantity | Total Cost | Description
2024-10-22 | Components DigiKey | Components | Digikey | $46.25 | Adrian | 19 | $46.25 | 1/2 of the required components to build PCB (Capatitor, Resistors, LED, etc....)
2024-10-22 | Components Mouser | Components | Mouser | $10.63 | Adrian | 2 | $10.63 | 1/2 of the components to build the PCB (Cap, Res, LED, etc...)
2024-10-22 | PCB Order | PCB | PCBWay | $20.06 | Adrian | 5 | $20.06 | 1st order for MCU PCB boards
2024-10-30 | Componenets Mouser | Components | Mouser | $30.68 | Adrian | 24 | $28.75 | https://www.mouser.com/ProjectManager/ProjectDetail.aspx?AccessID=854928be81
2025-01-21 | PCB Order | PCB | JLCPCB | $20.00 | Adrian | 5 | $20.00 | JLCPCB Order
2025-01-21 | Components DigiKey | Components | Digikey | $26.67 | Adrian | 71 | $33.66 | components needed for PCB - Cart Link: https://www.digikey.com/short/8qhfmfd1
 |  |  |  |  |  | Total | $159.35
2024-10-23 | Components Digikey | Components | Digikey | $114.83 | Emily | 42 | $114.83 | components for pcb
2024-10-23 | Components Digikey | Components | Digikey | $14.78 | Emily | 1 | $14.78 | components for pcb
2024-10-23 | Components Digikey | Components | Mouser | $9.12 | Emily | 3 | $9.12 | components for pcb
2024-10-23 | PCB Order | PCB | JLPCB | $30.08 | Emily | 5 | $30.08 | pcb boards
2024-01-22 | Components Digikey | Components | Digikey | $64.64 | Emily | 25 | $64.64 | https://www.digikey.com/short/4bj977v0
2025-01-24 | pcb order | boards | jlpcb | $25.31 | Emily | 5 | $25.31 | boards
 |  |  |  |  |  | Total | $258.76
2024-10-29 | PCB Order | PCB | JLPCB | $52.98 | Ethan | 5 | $52.98 | PCBs for Board A
2024-10-29 | Components Digikey | Components | Digikey | $77.86 | Ethan | 61 | $77.86 | Components for Board A
2024-11-01 | PCB Order | PCB | JLPCB | $49.18 | Ethan | 5 | $49.18 | PCBs for Boards B&C
2024-11-01 | Components Digikey | Components | Digikey | $108.01 | Ethan | 62 | $108.01 | Components for Boards B&C (Extras Ordered)
2024-11-04 | Power Supply | 48V 25A Power Supply | Amazon | $58.29 | Ethan | 1 | $58.29 | 48V 25A Power Supply for Boards A,B, and C
2025-01-23 | PCB Order | PCB | JLPCB | $40.60 | Ethan | 5 | $40.60 | JLPCB Price Estimate for Final Board
2025-01-23 | Components DIgikey | Components | Digikey | $73.60 | Ethan | 223 | $73.60 | Components for Final PCB Board https://www.digikey.com/short/0rbvph5q
 |  |  |  |  |  | Total | $460.52
 |  |  |  |  |  | Total | $878.63
Initial Budget | $400.00
Remanining | -$364.43

Sheet: Personal
Order Date | Part Number | Item Name | Location Buy From | Cost | Name | Quantity | Total Cost | Description
2024-09-25 | Apple Dev. Account | Subscription | Apple | $99 + ($8.17) | Jaishil | 1 | $107.17
2024-11-07 | PCB Order | PCB | JLCPCB | $24.58 + ($5.47) | Jaishil | 5 | $150.24
2024-11-07 | Digikey Components | Components | DigiKey | $30.61 + ($13.01) | Jaishil | 1 | $43.65
 |  |  |  |  |  | Total | $301.06

Sheet: Summary
TI Paid Total | $694.13
$400 Tamu Budget | $620.82
Personal | $301.06
