HomeboiWoods/403-ecen-cobot/403/Mobile Application Subsystem/Altium/Project Outputs for ESP32 with USBC/BOM/Bill of Materials-ESP32 with USBC(Prototype).xlsx

Comment | Description | Designator | Footprint | LibRef | Quantity | LCSC Part Number | Manufacturer | Manufacturer Part Number | Supplier | Supplier Part Number
100 nF, 50V | CAP CER 0.1UF 50V X7R 0402 | C1, C3, C4, C5, C6, C8, C9, C10, C15 | CAPC1005X55N | CL05B104KB54PNC | 9 | C307331 | Samsung | CL05B104KB54PNC | Digikey | 1276-CL05B104KB54PNCCT-ND
4u7, 16V | CAP CER 4.7UF 16V X5R 0402 | C2, C11 | CAPC1005X55N | CL05A475MO5NUNC | 2 | C318563 | Samsung | CL05A475MO5NUNC | Digikey | 1276-6836-1-ND
10 uF, 10V | CAP CER 10UF 10V X5R 0402 | C12, C13, C14 | CAPC1005X55N | CL05A106MP8NUB8 | 3 | C307415 | Samsung | CL05A106MP8NUB8 | Digikey | 1276-6830-1-ND
1uF, 35V | CAP CER 1UF 35V X5R 0402 | C16 | CAPC1005X55N | CL05A105KL5NRNC | 1 | C307413 | Samsung | CL05A105KL5NRNC | Digikey | 1276-6796-1-ND
GREEN | LED GREEN DIFFUSED 0402 SMD | D1 | LED0402G | VLMTG1500-GS08 | 1 | C20346084 | Vishay | VLMTG1500-GS08 | Digikey | 751-VLMTG1500-GS08CT-ND
RED | LED RED 0402 SMD | D2 | LED0402R | VLMS1500-GS08 | 1 | C511370 | Vishay | VLMS1500-GS08 | Digikey | VLMS1500-GS08CT-ND
AQ3045-01ETG | TVS DIODE 5.3VWM 12VC SOD882 | D3, D4, D5, D6, D7, D8 | SOD882 | AQ3045-01ETG | 6 | [NoParam], C3710326 | Littelfuse | AQ3045-01ETG | Digikey | F9321CT-ND
0022284245 | CONN HEADER VERT 24POS 2.54MM | J1, J2 | HDR_1X24_2.54MM | 0022284245 | 2 | C7145888 | Molex | 0022284245 | Digikey | 900-0022284245-ND
217179-0001 | CONN RCP USB2.0 TYP C 24P SMD RA | J3, J4 | FP-2171790001-MFG | 217179-0001 | 2 | C3197684 | Molex | 217179-0001 | Digikey | 900-2171790001CT-ND
FTS-102-01-F-S | CONN HEADER VERT 2POS 1.27MM | J5 | HDR_1X2_1.27MM | FTS-102-01-F-S | 1 | C6045317 | Samtec | FTS-102-01-F-S | Digikey | SAM15176-ND
FTS-103-01-F-S | CONN HEADER VERT 3POS 1.27MM | J6 | HDR_1X3_1.27MM | FTS-103-01-F-S | 1 | C3333578 | Samtec | FTS-103-01-F-S | Digikey | 612-FTS-103-01-F-S-ND
M50-1920005 | CONN SHUNT 1.27MM RED | LINK1, LINK2 |  | M50-1920005 | 2 | C6985646 | Harwin | M50-1920005 | Digikey | 952-1727-ND
SS8050-G | TRANS NPN 25V 1.5A SOT23-3 | Q1, Q2 | FP-SS8050-G-IPC_B | SS8050-G | 2 | C164885 | Comchip | SS8050-G | Digikey | 641-1790-1-ND
0R | RES 0 OHM JUMPER 1/16W 0402 | R1, R8, R19, R20, R23, R24 | RESC1005X37N | RC0402JR-070RL | 6 | C60485 | Yageo | RC0402JR-070RL | Digikey | 311-0.0JRCT-ND
1K | RES 1K OHM 1% 1/16W 0402 | R3, R4 | RESC1005X37N | RC0402FR-071KL | 2 | C106235 | Yageo | RC0402FR-071KL | Digikey | 311-1.00KLRCT-ND
27R | RES 27 OHM 1% 1/16W 0402 | R6, R7, R21, R22 | RESC1005X37N | RC0402FR-0727RL | 4 | C138021 | Yageo | RC0402FR-0727RL | Digikey | YAG3086CT-ND
4K7 | RES 4.7K OHM 1% 1/16W 0402 | R10 | RESC1005X37N | RC0402FR-074K7L | 1 | C105871 | Yageo | RC0402FR-074K7L | Digikey | 311-4.7KLRCT-ND
5K1 | RES SMD 5.1K OHM 1% 1/16W 0402 | R11, R12, R14, R15 | RESC1005X37N | AC0402FR-075K1L | 4 | C144745 | Yageo | AC0402FR-075K1L | Digikey | YAG3503CT-ND
10K | RES SMD 10K OHM 1% 1/16W 0402 | R13, R16, R17, R18 | RESC1005X37N | AC0402FR-0710KL | 4 | C144807 | Yageo | AC0402FR-0710KL | Digikey | YAG3436CT-ND
PTS645SH50SMTR92 LFS | SWITCH TACTILE SPST-NO 0.05A 12V | SW1, SW2 | FP-PTS645SH50SMTR92LFS-MFG | PTS645SH50SMTR92LFS | 2 | C221869 | ITT C&K | PTS645SH50SMTR92LFS | Digikey | CKN9085CT-ND
ESP32-S3-MINI-1-N8 | SMD module, ESP32-S3FN8, 8 MB SPI flash, PCB antenna | U1 | XCVR_ESP32-S3-MINI-1-N8 | ESP32-S3-MINI-1-N8 | 1 | C2913206 | Espressif Systems | ESP32-S3-MINI-1-N8 | Digikey | 1965-ESP32-S3-MINI-1-N8CT-ND
FT231XQ-R | IC USB SERIAL FULL UART 20QFN | U2 | FP-QFN-20-IPC_B | FT231XQ-R | 1 | C132159 | FTDI | FT231XQ-R | Digikey | 768-1128-1-ND
TL1963A-33DCYR | IC REG LINEAR 3.3V 1.5A SOT223-4 | U3 | DCY0004A_N | TL1963A-33DCYR | 1 | C181262 | Texas Instruments | TL1963A-33DCYR | Digikey | 296-24897-1-ND
