HomeboiWoods/403-ecen-cobot/403/Power Management/debug/debug log.xlsx

Sheet: Sheet1
date/ time | test/ action | result
2024-11-10 12:00 | initially turned on board using high voltage power supply without current limiting | board pulled 7amps at low voltage, smoke from converter
2024-11-11 12:00 | corrected thermal pads- soldered to pads using heat gun technique | did not test; instead confimed with lusher that thermal pad routing should be sufficent to disperse heat before testing
2024-11-12 08:00 | retested with 10V and 0.5A limit set on power supply | board pulled ~0.9V at 0.5A
2024-11-12 08:15 | increased current limit to 0.6A to see if board continues to max current | board pulled ~0.9V at 0.6A
2024-11-12 09:00 | talked with TA, converters may be shot from initial testing | replaced converters with spare parts
2024-11-13 09:00 | retested with 10V and 0.5A limit set on power supply | board still pulled ~0.9V at 0.5A
2024-11-13 09:30 | checked alitum schematics against webench designs to ensure correctness | all connections and component values in schematic look correct compared to webench, but 5V and 12V thermal pads not connected to ground directly as specified in data sheet; confirm with lusher if/ how this should be changed
2024-11-13 10:30 | tested the voltage across components to check for shorted connections | *in sheet 2* many components had weak to no voltages, could this be from flux? confirm with lusher
2024-11-14 17:30 | resoldered components with suspected shorts to try to fix low voltages across components | resoldered R2, still very little voltage across the component
2024-11-14 17:00 | retested voltages across components with a DMM to see if I potentially got a bad reading | some voltages were higher but still not very, results in sheet 2
2024-11-19 09:00 | performed a reverse bias test | there were no results that indicated the components had damage, moving foward with the assumption that the components are okay
2024-11-19 10:00 | removed C6, C7, and U2 to remove connection to the 5V output circuit, restested with 10V 0.5A to see if there was a short in that circuit causing the problem | board pulled 0.94V at 0.5A
2024-11-19 10:00 | removed C13, C14, and U3 to remove connection to 6V circuit *same as above* | pulled 0.975V at 0.5A
2024-11-19 10:15 | removed C20, C21, U4 | pulled 1.06V at 0.5A
2024-11-19 10:30 | removed C27, U5 | same
2024-11-19 | flipped power and ground wires at terminal block | it worked, i was connecting them incorrectly
2024-11-22 | tested 3.3 rail w 10V 0.5A | board pulled 9.99V at 0A, at 3.3V rail board pulled 3.3V
2024-11-22 | soldered on componetns to test 5V rail | did not work; 3.3 rail out outted 3.6V while 5V was wrong, removed 5V components
2024-11-22 | soldered on components for 6V rail | worked as expected
2024-11-22 | soldered components on for 12V rail | intputted 13V at 0.5A, board made a buzzing sound; immideatley removed power
2024-11-22 | using reverse bias test on 12V converter | pin 1 - ground: okay pin 2/3 - ground: okay pin 1 - Vin: okay pin 2/3 - Vin: okay
2024-11-22 | suspecting that there may be some issues with the thermal pad and power ground pad being traced through other components. 5V and 12V use the same converters, and both were wired so that the pads go through other componets | removing for now; coming back to blue-wire things later
2024-11-22 | soldered componets on for 24V | tested with 13V 0.5A; 3.3V and 6V rails worked and 24V rail outputted 13V
2024-11-22 | tested with 18V at 0.5A | board began to start pulling less voltage and more current
2024-11-22 | tested for shorts with reverse bias test at 24 rail | C27 shorted
2024-11-24 | found that there was not in fact a short on C27 but U1 was shorted between power and ground | replaced U1, worked as intended
2024-11-24

Sheet: Sheet2
testing 11/13 10:30 |  | restesting 11/15 | continuity test
3V3 |  |  | 3V3
component | voltage | voltage | component
R1 | 0.605 |  | R1 | no
R2 | .2m | 6.6m | R2 | no
R3 | 58m |  | R3 | no
R4 | 0.571 |  | R4 | no
C1 | 0.861 |  | C1 | no
C2 | 0.12 |  | C2 | no
C3 | 57mV |  | C3 | no
C4 | .2m | 6.5m | C4 | no
C5 | 0.6 |  | C5 | no
L1 | .5m | 100m | L1 | yes
5V0 |  |  | 5V0
component | voltage |  | component
R5 | 44m |  | R5 | no
R6 | 0.138 |  | R6 | no
R7 | 33m |  | R7 | no
C6 | 0.851 |  | C6 | no
C7 | 0.851 |  | C7 | no
C8 | 87m |  | C8 | no
C9 | 0.38 |  | C9 | no
C10 | 0.138 |  | C10 | no
C11 | 0.178 |  | C11 | no
C12 | 0.178 |  | C12 | no
L2 | 3m | 290m | L2 | yes
6V0 |  |  | 6V0
component | voltage |  | component
R8 | 0.614 |  | R8 | no
R9 | .4m | 7m | R9 | no
R10 | 0.3 |  | R10 | no
R11 | 0.5 |  | R11 | no
C13 | 0.82 |  | C13 | no
C14 | 0.7 |  | C14 | no
C15 | 0.5 |  | C15 | no
C16 | 0.4 |  | C16 | no
C17 | .013m | 8m | C17 | no
C18 | 0.168 |  | C18 | no
C19 | 0.168 |  | C19 | no
L3 | .4m | 70m | L3 | yes
D1 | 0.17 |  | D1 | no
12V0 |  |  | 12V0
component | voltage |  | component
R12 | 44m |  | R12 | no
R13 | 0.15 |  | R13 | no
R14 | 13m | 134m | R14 | no
C20 | 0.813 |  | C20 | no
C21 | 0.8 |  | C21 | no
C22 | 75m |  | C22 | no
C23 | 0.391 |  | C23 | no
C24 | 0.15 |  | C24 | no
C25 | 0.16 |  | C25 | no
C26 | 0.16 |  | C26 | no
L4 | 0 | 131m | L4 | yes
24V0 |  |  | 24V0
component | voltage |  | component
R15 | 0.578 |  | R15 | no
R16 | 3m | 104m | R16 | no
R17 | 86m |  | R17 | no
R18 | 0.536 |  | R18 | no
C27 | 0.815 |  | C27 | no
C28 | 0.1 |  | C28 | no
C29 | 79m |  | C29 | no
C30 | 0 | 115m | C30 | no
C31 | .6m | 120m | C31 | no
C32 | 0.623 |  | C32 | no
L5 | .2m | 12m | L5 | yes

Sheet: Sheet3
3.3V
outputs 3.3V at 10V | used DMM to measure output | pass
outputs 3.3V at 13V | used DMM to measure output | pass
outputs 3.3V at 18V | used DMM to measure output | pass
outputs 3.3V at 22V | used DMM to measure output | pass
outputs 3.3V at 25V | used DMM to measure output | pass
outputs are DC at 25V | used oscilloscope to show output and input | pass
5V
outputs 5V at 10V | used DMM to measure output
outputs 5V at 13V | used DMM to measure output
outputs 5V at 18V | used DMM to measure output
outputs 5V at 22V | used DMM to measure output
outputs 5V at 25V | used DMM to measure output
outputs are DC at 25V | used oscilloscope to show output and input
6V
outputs 6V at 10V | used DMM to measure output | pass
outputs 6V at 13V | used DMM to measure output | pass
outputs 6V at 18V | used DMM to measure output | pass
outputs 6V at 22V | used DMM to measure output | pass
outputs 6V at 25V | used DMM to measure output | pass
outputs are DC at 25V | used oscilloscope to show output and input | pass
12V
outputs 10V at 10V | used DMM to measure output | pass
outputs 12V at 13V | used DMM to measure output | pass
outputs 12V at 18V | used DMM to measure output | pass
outputs 12V at 22V | used DMM to measure output | pass
outputs 12V at 25V | used DMM to measure output | pass
outputs are DC at 25V | used oscilloscope to show output and input
24V
outputs 12V at 10V | used DMM to measure output | pass
outputs 12V at 13V | used DMM to measure output | pass
outputs 12V at 18V | used DMM to measure output | pass
outputs 12V at 22V | used DMM to measure output | pass
outputs 12V at 25V | used DMM to measure output | pass
outputs are DC at 25V | used oscilloscope to show output and input | pass
