HomeboiWoods/403-ecen-cobot/403/Power Management/Load List.xlsx

Sheet: load list
Component Name | Component Type | High/ Low Voltage | Amps | A | Voltage Input | V | Supply Voltage Min | Supply Voltage Max | Power
PDRV8161DGSR (https://www.ti.com/lit/ds/symlink/drv8161.pdf?ts=1726504502985) | motor driver | high | 2mA IGVDD | 0.002 | 12V | 12 | 8V | 20V | 0.024
 |  |  |  |  |  |  |  |  | 0
https://www.omc-stepperonline.com/48v-3000rpm-0-6nm-188w-5-40a-57x57x100mm-brushless-dc-motor-57bsa100-48-01 | BLDC motor 1 | high | 5.4A | 5.4 | 48V | 48 |  | 48V | 259.2
https://teknic.com/hudson-model/M-3432S-LN-02D/?model_voltage=48 | BLDC motor 2 | high | 5.1A | 5.1 | 48V | 48 |  | 48V | 244.8
https://teknic.com/hudson-model/M-2311P-QN-08D/?model_voltage=48 | BLDC motor 3 | high | 7.7A | 7.7 | 48V | 48 |  | 48V | 369.6
https://www.omc-stepperonline.com/24v-3000rpm-0-04nm-13w-1-00a-42x43mm-brushless-dc-motor-42bya43-24-01 | BLDC motor 4 | high | 1A | 1 | 24V | 24 |  | 48V | 24
Robotic Arm Pincher (https://www.electronicoscaldas.com/datasheet/MG996R_Tower-Pro.pdf) | pincher | high | 0.9A | 0.9 | 6V | 6 | 4.8V | 7.2V | 5.4
 |  |  |  |  |  |  |  |  | 0
 | Motor Encoder Boards |  |  | 0.36 |  | 5 |  |  | 1.8
TMS320F28004 (https://www.ti.com/lit/ds/symlink/tms320f280049c.pdf?ts=1727748629649) | MCU | low | 90 mA Max, 61 mA Typ | 0.061 | 3.3V VDDIO and VDDA, 1.2V VDD | 3.3 | -0.3 V | 4.6 V | 0.2013
 |  |  |  |  |  |  |  |  | 0
ESP32 (https://learn.sparkfun.com/tutorials/esp32-thing-hookup-guide/hardware-overview) | bluetooth components | low | up to 250 mA | 0.25 |  | 3.3 | 2.2V | 3.6V | 0.825
Capacity Calculations
Total Power | 905.8503 | Watts, sum of all component's power
Duration | 0.5 | Hours, desired runtime for the robot
Energy Consumption | 452.92515 | Wh, Watts * Duration
Account for Safety/ Efficiency | 1132.312875 | Wh, Energy consumption * 2 (assuming 50% depth of discharge) * 1.25 (accounting for efficiency losses)
Battery Capacity | 23.58985156 | Ah, Wh / Voltage of Battery

Sheet: Copy of load list
Component Name | Component Type | High/ Low Voltage | Amps | A | Voltage Input | V | Supply Voltage Min | Supply Voltage Max | Power
PDRV8161DGSR (https://www.ti.com/lit/ds/symlink/drv8161.pdf?ts=1726504502985) | motor driver | high | 2mA IGVDD | 0.002 | 12V | 12 | 8V | 20V | 0.024
 |  |  |  |  |  |  |  |  | 0
https://www.omc-stepperonline.com/48v-3000rpm-0-6nm-188w-5-40a-57x57x100mm-brushless-dc-motor-57bsa100-48-01 | BLDC motor 1 | high | 5.4A | 5.4 | 48V | 48 |  | 48V | 259.2
https://teknic.com/hudson-model/M-3432S-LN-02D/?model_voltage=48 | BLDC motor 2 | high | 5.1A | 5.1 | 48V | 48 |  | 48V | 244.8
https://teknic.com/hudson-model/M-2311P-QN-08D/?model_voltage=48 | BLDC motor 3 | high | 7.7A | 7.7 | 48V | 48 |  | 48V | 369.6
https://www.omc-stepperonline.com/24v-3000rpm-0-04nm-13w-1-00a-42x43mm-brushless-dc-motor-42bya43-24-01 | BLDC motor 4 | high | 1A | 1 | 24V | 24 |  | 48V | 24
Robotic Arm Pincher (https://www.electronicoscaldas.com/datasheet/MG996R_Tower-Pro.pdf) | pincher | high | 0.9A | 0.9 | 6V | 6 | 4.8V | 7.2V | 5.4
 |  |  |  |  |  |  |  |  | 0
 | Motor Encoder Boards |  |  | 0.36 |  | 5 |  |  | 1.8
TMS320F28004 (https://www.ti.com/lit/ds/symlink/tms320f280049c.pdf?ts=1727748629649) | MCU | low | 90 mA Max, 61 mA Typ | 0.061 | 3.3V VDDIO and VDDA, 1.2V VDD | 3.3 | -0.3 V | 4.6 V | 0.2013
 |  |  |  |  |  |  |  |  | 0
ESP32 (https://learn.sparkfun.com/tutorials/esp32-thing-hookup-guide/hardware-overview) | bluetooth components | low | up to 250 mA | 0.25 |  | 3.3 | 2.2V | 3.6V | 0.825
Capacity Calculations
Total Power | 905.8503 | Watts, sum of all component's power
Duration | 0.5 | Hours, desired runtime for the robot
Energy Consumption | 452.92515 | Wh, Watts * Duration
Account for Safety/ Efficiency | 1132.312875 | Wh, Energy consumption * 2 (assuming 50% depth of discharge) * 1.25 (accounting for efficiency losses)
Battery Capacity | 23.58985156 | Ah, Wh / Voltage of Battery

Sheet: notes
TPS54540BDDA (https://www.ti.com/lit/ds/symlink/tps54540b.pdf?ts=1726509567646) | power converter ic | load resistance
power iC | integrated bootstrap voltage regulator
 | recommended value of the BOOT capacitor is 0.1 μF with an X7R or X5R grade dielectric with a voltage rating of 10 V or higher
 | decoupling capacitor to help with ground bounce and ringing which may cause voltage drop to component power pins
 | isolated gate drivers?
 | with this ic, do i also need a regulator?
 | should i have multiple of these? probably right? one for all of the rails?
 | linear vs switch mode
