HomeboiWoods/403-ecen-cobot/403/Mobile Application Subsystem/Altium/3D/User Library-LED_1006_G.STEP

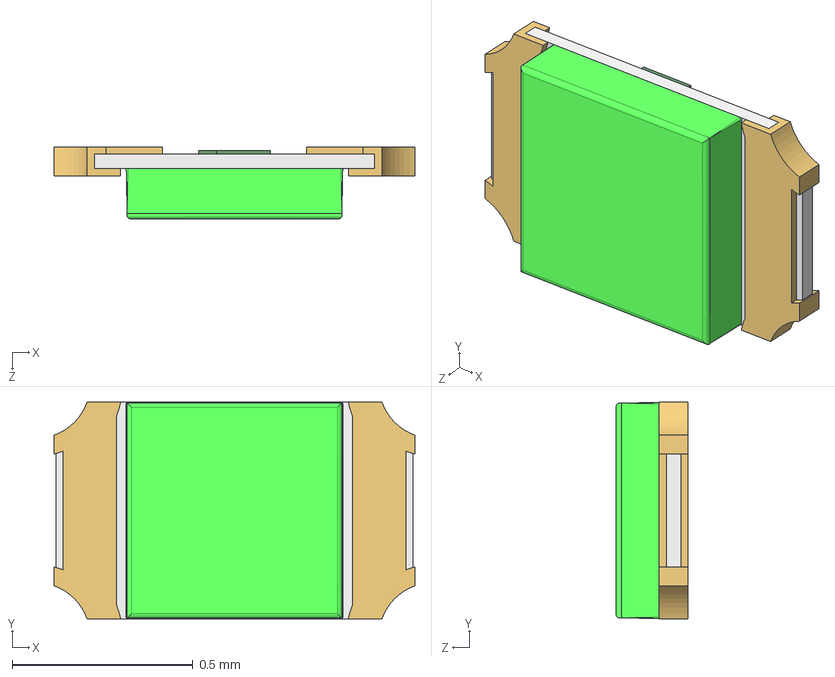
[picture p72: CAD file, 2024-11-10]
403/Mobile Application Subsystem/Altium/3D/User Library-LED_1006_G.STEP
1.00 x 0.6 x 0.2 mm
Grⁿn
Cut005_(Mirror_#1)
