HomeboiWoods/403-ecen-cobot/403/Mobile Application Subsystem/Altium/3D/FTS-103-01-F-S.stp

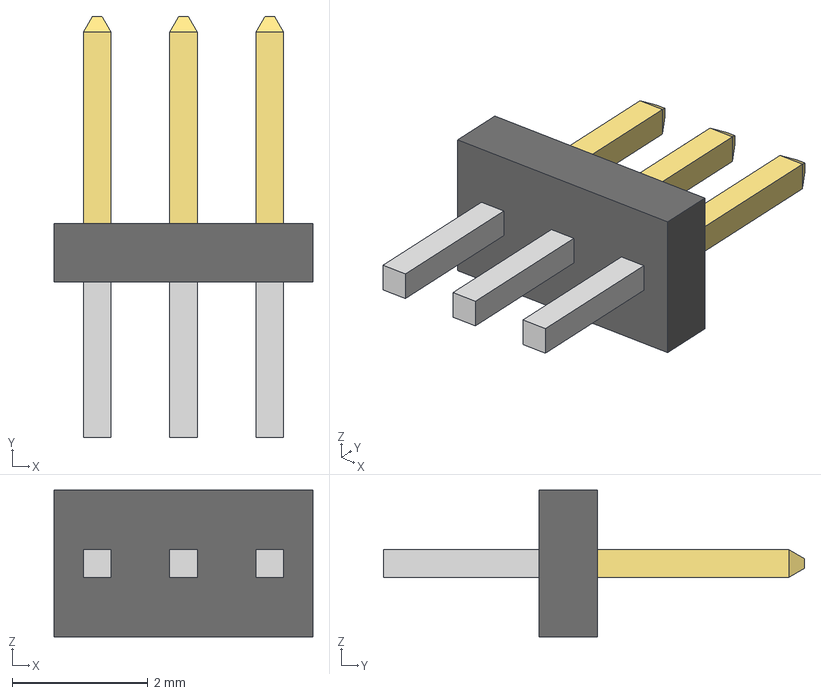
[picture p73: CAD file, 2024-11-10]
403/Mobile Application Subsystem/Altium/3D/FTS-103-01-F-S.stp
3.81 x 6.20 x 2.16 mm
FTS-103-01-F-S_body
FTS-103-01-F-S_pins1
FTS-103-01-F-S_pins2
