HomeboiWoods/403-ecen-cobot/403/Mobile Application Subsystem/Altium/3D/FTS-102-01-F-S.stp

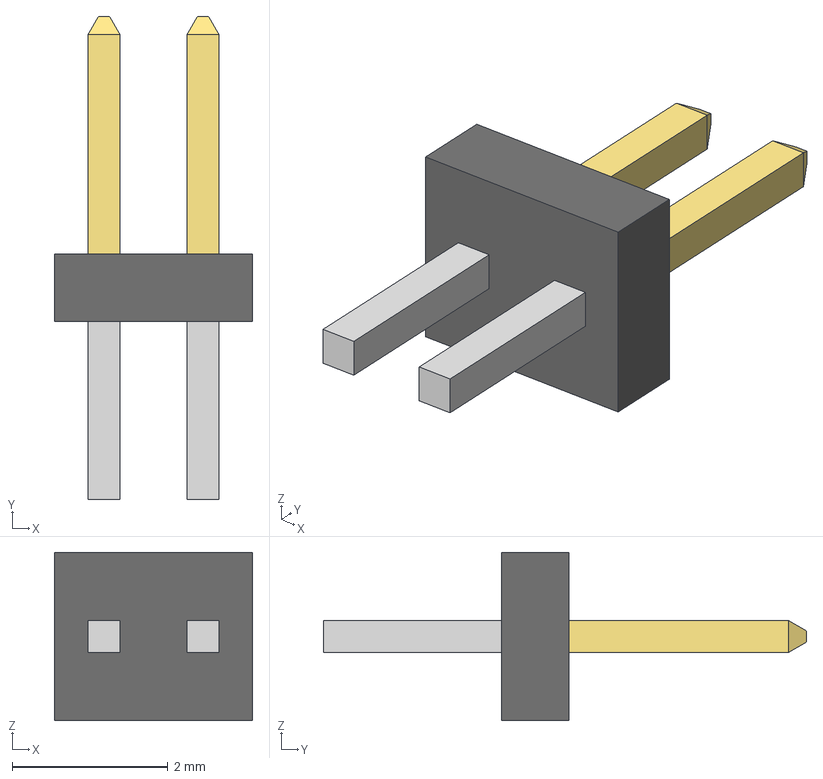
[picture p74: CAD file, 2024-11-10]
403/Mobile Application Subsystem/Altium/3D/FTS-102-01-F-S.stp
2.54 x 6.20 x 2.16 mm
FTS-102-01-F-S_body
FTS-102-01-F-S_pins1
FTS-102-01-F-S_pins2
