HomeboiWoods/403-ecen-cobot/403/Mobile Application Subsystem/Altium/3D/AQ3045-01ETG.stp

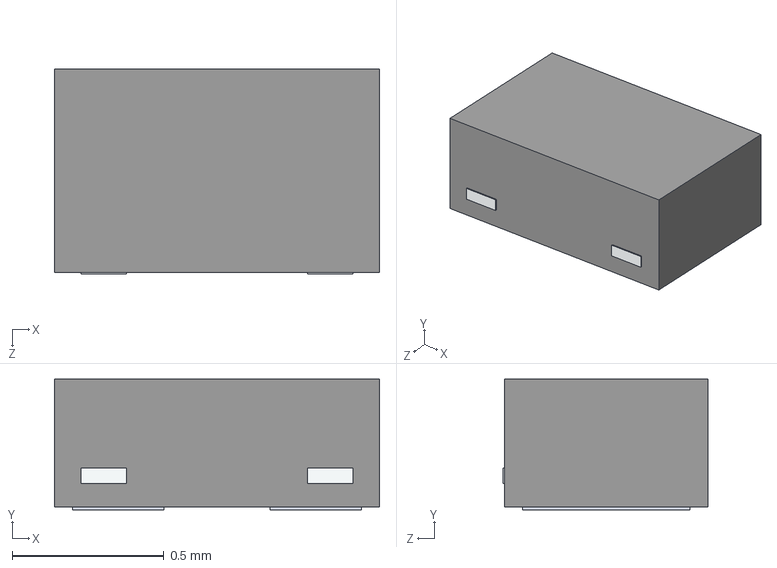
[picture p75: CAD file, 2024-11-10]
403/Mobile Application Subsystem/Altium/3D/AQ3045-01ETG.stp
1.07 x 0.43 x 0.675 mm
