HomeboiWoods/403-ecen-cobot/403/Mobile Application Subsystem/Altium/3D/User Library-PTS645SL43SMTR92-LFS.STEP

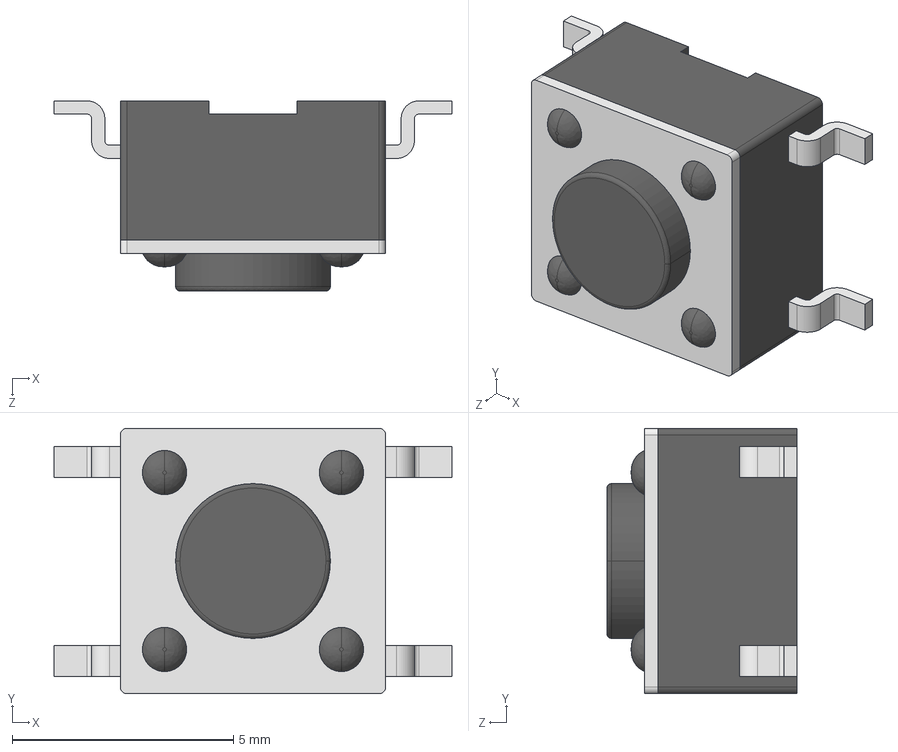
[picture p76: CAD file, 2024-11-10]
403/Mobile Application Subsystem/Altium/3D/User Library-PTS645SL43SMTR92-LFS.STEP
9.00 x 6.00 x 4.30 mm
