HomeboiWoods/403-ecen-cobot/403/Mobile Application Subsystem/Altium/3D/022284245.stp

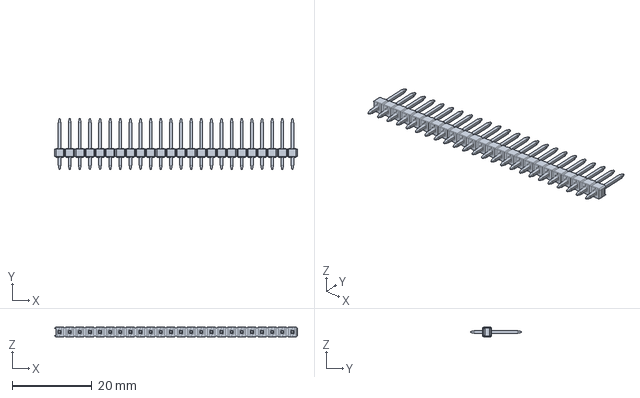
[picture p77: CAD file, 2024-11-10]
403/Mobile Application Subsystem/Altium/3D/022284245.stp
61.0 x 12.8 x 2.49 mm
