HomeboiWoods/403-ecen-cobot/(list of files, cad)

Other CAD files:
403/Mobile Application Subsystem/Altium/3D/User Library-LED_1006_R.STEP
