HomeboiWoods/403-ecen-cobot/403/Documents/Execution - Validation Plan/Execution Plan Revision 0.xlsx

Sheet: 403
 | Multi-Axis Cobot for Factory Automation Gantt Chart
 |  | Week of:
 | Titles | 2024-08-27 | 2024-09-03 | 2024-09-10 | 2024-09-17 | 2024-09-24 | 2024-10-01 | 2024-10-08 | 2024-10-15 | 2024-10-22 | 2024-10-29 | 2024-11-05 | 2024-11-12 | 2024-11-19 | 2024-11-26 | 2024-12-03 | Date Completed
Key: | Defining Project Scope (8/27) |  |  |  |  |  |  |  |  |  |  |  |  |  |  |  | 2024-08-27
Black - ALL | Subsystem Division / Brainstorming (9/3) |  |  |  |  |  |  |  |  |  |  |  |  | Not Started |  |  | 2024-09-03
Green - Adrian Guzman | Creating a Budget Parts List (9/10) |  |  |  |  |  |  |  |  |  |  |  |  | In Progress |  |  | 2024-09-12
Purple - Jaishil Shah | Subsystem Software Initialization (9/10/24) |  |  |  |  |  |  |  |  |  |  |  |  | Completed |  |  | 2024-09-17
Blue - Emily Hamsa | CONOPS Report (9/15) |  |  |  |  |  |  |  |  |  |  |  |  | Behind Sch. |  |  | 2024-09-12
Red - Ethan Woods | Creating a (TI) Parts List (9/17) |  |  |  |  |  |  |  |  |  |  |  |  |  |  |  | 2024-09-17
 | Swift Compatability (9/17) |  |  |  |  |  |  |  |  |  |  |  |  |  |  |  | 2024-09-17
 | Motor Selection Finalization (9/20) |  |  |  |  |  |  |  |  |  |  |  |  |  |  |  | 2024-10-08
 | Complete Subsystem Introduction Project (9/24) |  |  |  |  |  |  |  |  |  |  |  |  |  |  |  | 2024-09-24
 | Subsystem Introduction Project (Emily) (9/27) |  |  |  |  |  |  |  |  |  |  |  |  |  |  |  | 2024-09-30
 | Project Selection Presentation (9/23) |  |  |  |  |  |  |  |  |  |  |  |  |  |  |  | 2024-09-23
 | FSR, IDC, Milestones and Validation plan (9/26) |  |  |  |  |  |  |  |  |  |  |  |  |  |  |  | 2024-06-26
 | Parts Selection Finalization and Battery Sizing (9/27) |  |  |  |  |  |  |  |  |  |  |  |  |  |  |  | 2024-10-13
 | Competed PMS PCB Design and Ordering (10/11) |  |  |  |  |  |  |  |  |  |  |  |  |  |  |  | 2024-10-23
 | Mid-Term Presentation (10/14) |  |  |  |  |  |  |  |  |  |  |  |  |  |  |  | 2024-10-14
 | PCB Design with MCU (10/18) |  |  |  |  |  |  |  |  |  |  |  |  |  |  |  | 2024-10-22
 | Order PCB Board & Components (10/18) |  |  |  |  |  |  |  |  |  |  |  |  |  |  |  | 2024-10-22
 | Motor/Motor Driver Testing with EVM Board (10/18) |  |  |  |  |  |  |  |  |  |  |  |  |  |  |  | 2024-10-08
 | Apple Developer Status / Flutterflow Crash Course (10/20) |  |  |  |  |  |  |  |  |  |  |  |  |  |  |  | 2024-10-15
 | Subsystem Introduction Project (Jaishil) (10/20) |  |  |  |  |  |  |  |  |  |  |  |  |  |  |  | 2024-10-17
 | Subsystem Introduction Project (Ethan) (10/20) |  |  |  |  |  |  |  |  |  |  |  |  |  |  |  | 2024-10-15
 | Software on eval board (LED Blink & Motor Spin) (10/29) |  |  |  |  |  |  |  |  |  |  |  |  |  |  |  | 2024-10-25
 | Bluetooth Integration & ESP-32 Communication (11/5) |  |  |  |  |  |  |  |  |  |  |  |  |  |  |  | 2024-11-05
 | PCB Assembly and Soldering (11/08) |  |  |  |  |  |  |  |  |  |  |  |  |  |  |  | 2024-11-08
 | PCB Testing and Debugging (11/22) |  |  |  |  |  |  |  |  |  |  |  |  |  |  |  | 2024-11-25
 | PCB Assembly & Soldering (11/4) |  |  |  |  |  |  |  |  |  |  |  |  |  |  |  | 2024-11-05
 | PCB Design and Ordering (11/4) |  |  |  |  |  |  |  |  |  |  |  |  |  |  |  | 2024-11-01
 | ESP-32 PCB Design and Ordering (11/5) |  |  |  |  |  |  |  |  |  |  |  |  |  |  |  | 2024-11-05
 | Final Presentation (11/11) |  |  |  |  |  |  |  |  |  |  |  |  |  |  |  | 2024-11-11
 | Verify signals on PCB board |  |  |  |  |  |  |  |  |  |  |  |  |  |  |  | 2024-11-08
 | JTAG debugger connection to MCU |  |  |  |  |  |  |  |  |  |  |  |  |  |  |  | 2024-11-12
 | LED Blink/Stepper Motor on PCB |  |  |  |  |  |  |  |  |  |  |  |  |  |  |  | 2024-11-19
 | Soldered and Functional ESP-32 (11/22) |  |  |  |  |  |  |  |  |  |  |  |  |  |  |  | 2024-11-22
 | Solder Phase A, Phase B, and Phase C Boards (11/19) |  |  |  |  |  |  |  |  |  |  |  |  |  |  |  | 2024-11-12
 | PWM Signal Generation & ESP-32 Communication |  |  |  |  |  |  |  |  |  |  |  |  |  |  |  | 2024-11-24
 | Generate Phase Signals on Different Boards (11/25) |  |  |  |  |  |  |  |  |  |  |  |  |  |  |  | 2024-11-18
 | Subsystem Demonstration (Jaishil) (11/26) |  |  |  |  |  |  |  |  |  |  |  |  |  |  |  | 2024-11-26
 | Subsystem Demonstration (Ethan) (11/26) |  |  |  |  |  |  |  |  |  |  |  |  |  |  |  | 2024-11-26
 | Subsystem Demonstration (Emily) (11/26) |  |  |  |  |  |  |  |  |  |  |  |  |  |  |  | 2024-11-26
 | Subsystem Demonstration (Adrian) (11/26) |  |  |  |  |  |  |  |  |  |  |  |  |  |  |  | 2024-11-26
 | Final Report (12/5) |  |  |  |  |  |  |  |  |  |  |  |  |  |  |  | 2024-12-05

Sheet: 404
 | Multi-Axis Cobot for Factory Automation Gantt Chart
 |  | Week of:
 | Titles | 2025-01-06 | 2025-01-13 | 2025-01-20 | 2025-01-27 | 2025-02-03 | 2025-02-10 | 2025-02-17 | 2025-02-24 | 2025-03-03 | 2025-03-10 | 2025-03-17 | 2025-03-24 | 2025-03-31 | 2025-04-07 | 2025-04-14 | 2025-04-21 | 2025-04-28 | Date Completed
Key: | Bi-Weekly Status Update #1 (a) (1/15)
Black - ALL | Redesign PCB to include new rails and power plains (1/17) |  |  |  |  |  |  |  |  |  |  |  |  | Not Started
Green - Adrian Guzman | Place PCB and components order(1/17) |  |  |  |  |  |  |  |  |  |  |  |  | In Progress
Purple - Jaishil Shah | Redesign Schematics and PCB Design (1/17) |  |  |  |  |  |  |  |  |  |  |  |  | Completed
Blue - Emily Hamsa | Finalize design of new PCB (1/17) |  |  |  |  |  |  |  |  |  |  |  |  | Behind Sch.
Red - Ethan Woods | Order PCB and components (1/17)
 | Order PCB and Components (1/20)
 | Finalize App Design (1/24)
 | Assemble PCB (1/29)
 | Assemble new PCB (1/29)
 | Assemble and Solder Final PCB (1/31)
 | Work on Physical Design Modifications (1/31)
 | Wirelessly communcate to cobot motors (2/6)
 | Integrate Bluetooth functionality with other subsystems (2/3)
 | Validate functionality of PCB & Software (2/3)
 | Bi-Weekly Status Update #2 (a) (2/3)
 | Begin Integration (2/3)
 | Test and Validate PCB (2/5)
 | Develop software for 4-axis Servo Movement (2/10)
 | Develop software for wireless input to MCU (2/10)
 | Test and Validate PCB (2/7)
 | Prepared physical design for integration (2/10)
 | Begin Integration with team subsystems (2/10)
 | Begin Integration with team subsystems (2/10)
 | Begin Integraion with MCU Subsystem (2/10)
 | BLDC motor spinning through CCS software (2/19)
 | Solder second MCU board (2/20)
 | Finalize motor softwares / fix bugs (2/24)
 | Integrated physical design (2/24)
 | Bi-Weekly Status Update #3 (a) (2/17)
 | Identify and Fix Issues during integration (3/7)
 | Bi-Weekly Status Update #4 (a) (3/3)
 | Fix issues encountered during integration (3/31)
 | Bi-Weekly Status Update #5 (a) (3/24)
 | Final Design Presentation (4/7)
 | Final Demo (4/21)
 | Final Report Due (4/28)
