HomeboiWoods/403-ecen-cobot/403/Documents/Execution - Validation Plan/Validation Plan Revision 0.xlsx

 |  | Multi-Axis Cobot for Factory Automation Validation Plan
Status Key: | Paragraph Number | Test Name | System Criteria | Criteria for Success | Status | Responsible Engineer(s)
In Progress |  | Joint Effort
Completed | 3.2.2.1 | Mounting | When system is lifting the maximum payload, it stays mounted to its surface without tipping. | Attatch weights to arm of Cobot, measure the maximum payload before system tips over. |  | Full Team
Late | 3.2.1.1 | C2000 EVM Wakeup | Launch EVM and connection is successful | EVM turns on, CCS software identifies device, simple command run. |  | Full Team
TBD | 3.2.2.2 | System Precision | Physical movement and load capacity functionality is able to move objects precisely and accurately. | System axes can move at minimum 2 degrees, and move objects 2 inches on the table. |  | Full Team
 | 3.2.2.3 | Structure Integrity | All components and joints are structrually sound | When cobot is lifting maximum weight, the physical design is able to support the weight of both itself and the load. |  | Full Team
 |  | Power Subsystem
 | 3.2.1.6 | Schematic & PCB Creation | Power management system PCB is fully designed in Altium | Completion of all schematics in Altium and is validated, checked for validation errors, and DRC has no errors. |  | Emily Hamsa
 | 3.2.3.1.2 | Battery Sizing | Choose battery size that will adequetly power cobot based on load list | Completion of battery sizing using formulas and load list to determine appropriate voltage and amp-hour sizing |  | Emily Hamsa
 | 3.2.3.1.1 | Input Voltage | The battery will supply a constant DC 48V to the system at the input | Using a oscilloscope, test to ensure system input holds at 48 volts while battery is connected and measure noise |  | Emily Hamsa
 | 3.2.3.1.3 | Voltage Step-Down | Power PCB will step-down voltage to the subsequent systems requirements | Using a multimeter, test each voltage rail and ensure it is holding correct voltage |  | Emily Hamsa
 | 3.2.3.2.5. | Output DC Voltage | The output terminals will hold a true DC output voltage. | Using a oscilloscope, test the output terminals and ensure that the output is truly DC |  | Emily Hamsa
 |  | MCU/Connectivity Subsystem
 | 3.2.1.3.1 | Schematic & PCB Creation | Schematic and PCB footprint integrating MCU, motor drivers, and ESP32 | Individual sheets within altium are completed and reviewed for accuracy, there are no errors in validation, and DRC comes back with zero errors. |  | Adrian Guzman
 | 3.2.1.2 | MCU & Motor Driver | Test MCU and motor driver communication | Align with motor driving subsystem to ensure signals are accounted for. Integrate and show motor movement |  | Adrian Guzman, Ethan Woods
 | 3.2.3.2.1 | LED Program | Flash the evaluation board MCU and get LED program working / GPIO (PWM) generation | Use the C2000 EVM and CCS software developer to create code that functions on EVM. This code will verify understanding of signals. (Ex. LED blinking & PWM generation) |  | Adrian Guzman
 | 3.2.3.1.4 | MCU & Bluetooth | Test MCU and bluetooth (ESP32) communication | Align with wireless subsystem requirements, all necessary signals are accounted for and communication betweeen bluetooth can be displayed |  | Adrian Guzman, Jaishil Shah
 | 3.2.3.2.6 | MCU Generates PWM Signals | The oscilloscope outputs PWM waveforms | Probe GPIO pins to visualize PWM output on the oscilloscope |  | Adrian Guzman
 | 3.2.3.1.7 | C2000 MCU Input from ESP-32 | The C2000 MCU will be capable of receiving input from ESP-32 | Develop a test where an ESP-32 pin is set to high/low continusoutly. The C2000 will receive the input of this pin and toggle LED ON/OFF based on the ESP-32 input |  | Adrian Guzman
 | 3.2.1.3 | JTAG Programming of MCU | The MCUs programming signals (TDI, TDO, TCK, TMS) are properly routed | The XDS-110 debugger, built into the launchpad will be used to program the MCU on the PCB. This is done by connecting the required signals (TDI, TDO, TCK, TMS) from the PCB to the launchpad. A program will be written in CCS. |  | Adrian Guzman
Status Key: |  | Motor Driver Subsystem
In Progress | 3.2.1.3.2 | Schemating and PCB Creation | Creating Schematics and PCB boards for Individual Motors (5 Total) | All schematic sheets are created, validated, and DRC has zero errors. |  | Ethan Woods
Completed | 3.2.3.2.2 | PWM Phase Output from Motor Drivers | When the Motor Driver PCB is provided power and C2000 Launchpad connection, generate a Corresponding PWM Phase Signal | A generated PWM signal is readable and observable on oscilloscope or other measuring tool. One board can generate one signal. |  | Ethan Woods
Late | 3.2.3.1.5 | Motor Movement | Motor Drivers can send signals to move Motor through MCU | Align with MCU subsystem on requried signals for control, display movement through MCU control with motor drivers and motor. |  | Ethan Woods, Adrian Guzman
TBD | 3.2.1.4 | Precise Motor Control | Through encoders, Motors will move a few degrees at a time | Perform angular measurements on motor when spinning, record data. |  | Ethan Woods
 | 3.2.1.5 | All Motor Movement | All motors can move through communication with the MCU and Motor Drivers | Motor functionality is precise and all movements correspond with the intended output |  | Ethan Woods
 |  | Wireless Subsystem
 | 3.2.3.2.2 | Wireless Connectivity | Mobile app connection and communication between two devices via RX TX | Mobile app connection does not drop out more than 1 time in 5 minutes, and connects within 30 seconds. ESP-32 can communicate to external devices. |  | Jaishil Shah, Adrian Guzman
 | 3.2.3.1.6 | GUI Operational | User Interface (application) is deployed to mobile device | Connection is stable, input lag is minimal, and outputs are properly received/translated |  | Jaishi Shah
 | 3.2.5 | Application Device Deployment | More than one device can connect & Available to all iOS devices | The application is deployed onto the device & easily accessible to multiple users |  | Jaishil Shah
 | 3.2.3.1.7 | Button Functionality | Button Input Functionality | Human interaction is received and works without fault |  | Jaishil Shah
