HomeboiWoods/403-ecen-cobot/404/Power Management/testing/eload testing.xlsx

3V3 |  |  | 5V |  | 12V |  | 48V
ILoad [A] | Vout [V] |  | ILoad [A] | Vout [V] | ILoad [A] | Vout [V] | ILoad [A] | Vout [V] | Battery with E-Load
0.1 | 3.304 | Actual | 0.25 | 5.028 | 0.109 | 12.695 | 0.5 | 47.842 | ILoad [A] | Vout [V] | ΔVout [V]
0.2 | 3.178 |  | 0.5 | 5.005 | 0.2 | 12.598 | 1 | 47.784 | 0.5 | ~52 | 0
0.3 | 2.888 |  | 0.75 | 4.99 | 0.3 | 12.59 | 1.5 | 47.729 | 1 | ~52 | 0.1
 |  |  | 1 | 4.974 | 0.4 | 12.575 | 2 | 47.671 | 1.5 | ~52 | 0.1
0.1 | 3.3 | Expected | 1.25 | 4.958 | 0.5 | 12.57 | 2.5 | 47.618
0.2 | 3.3 |  | 1.5 | 4.943 |  |  | 3 | 47.562
0.3 | 3.3 |  |  |  |  |  | 3.5 | 47.557
 |  |  | 0.25 | 5 | 0.109 | 12 | 4 | 47.5
 |  |  | 0.5 | 5 | 0.2 | 12
 |  |  | 0.75 | 5 | 0.3 | 12 | 0.5 | 48
 |  |  | 1 | 5 | 0.4 | 12 | 1 | 48
 |  |  | 1.25 | 5 | 0.5 | 12 | 1.5 | 48
 |  |  | 1.5 | 5 |  |  | 2 | 48
 |  |  |  |  |  |  | 2.5 | 48
 |  |  |  |  |  |  | 3 | 48
 |  |  |  |  |  |  | 3.5 | 48
 |  |  |  |  |  |  | 4 | 48
