HomeboiWoods/403-ecen-cobot/403/Documents/Execution - Validation Plan/example_execution_validation_plan.pptx

## Integration/Execution Timeline

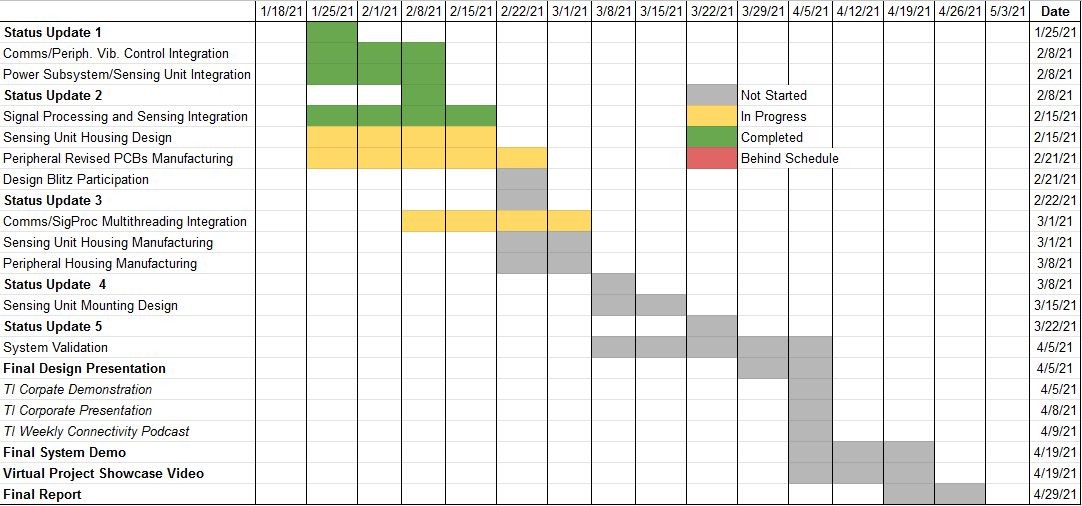
[picture p78: figure]

mmWave Visual Substitution System

## Validation Plan

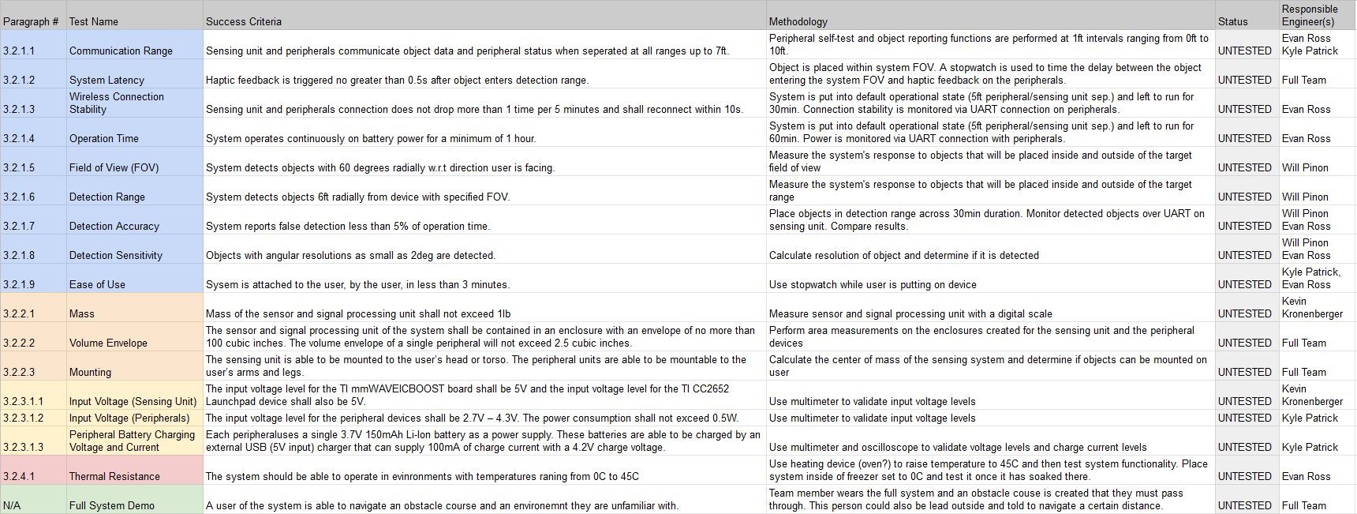
[picture p79: figure]
