HomeboiWoods/403-ecen-cobot/403/Power Management/final reports/6V_1.4A.pdf

## WEBENCH ® Design Report

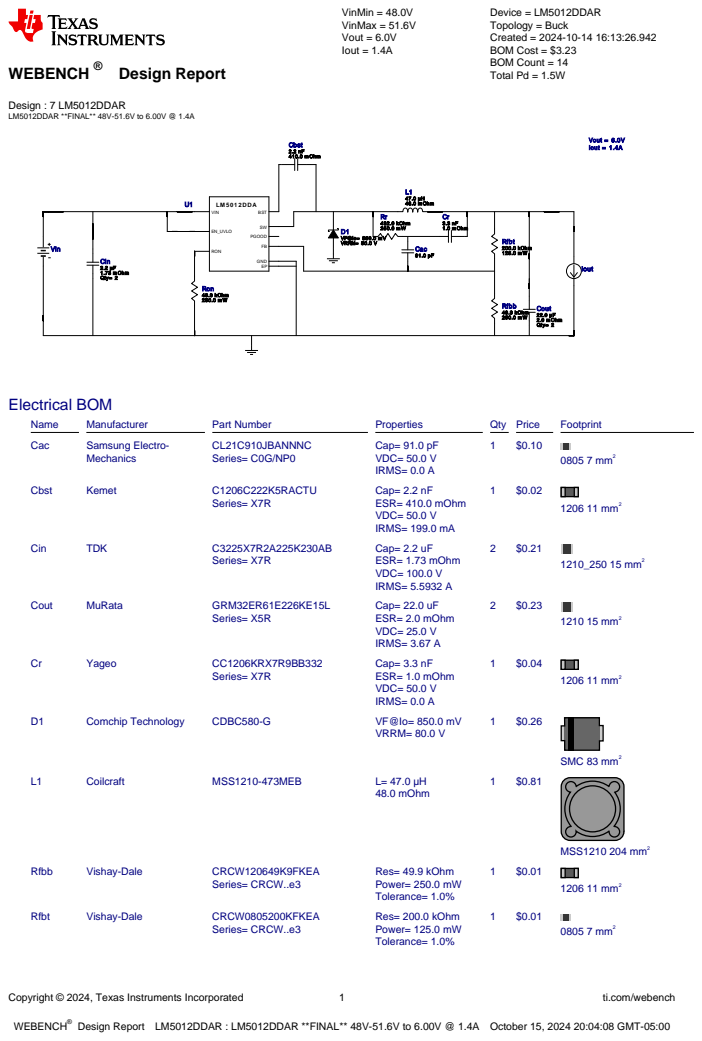
[picture p99: page 1]
Copyright © 2024, Texas Instruments Incorporated; ti.com/webench; WEBENCH®; Design : 7 LM5012DDAR LM5012DDAR **FINAL** 48V-51.6V to 6.00V @ 1.4A; VinMin = 48.0V VinMax = 51.6V Vout = 6.0V Iout = 1.4A; Device = LM5012DDAR Topology = Buck Created = 2024-10-14 16:13:26.942 BOM Cost = $3.23 BOM Count = 14 Total Pd = 1.5W; LM 5 0 1 2 DDA; GND; VIN; EN_UVLO; RON; PGOOD; BST; Cac 91.0 pF; Rr 432.0 kOhm 250.0 m W; Cr 3.3 nF 1.0 m Ohm; Cout 22.0 µF 2.0 m Ohm Qty= 2; L1 47.0 µH 48.0 m Ohm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

Design Report LM5012DDAR : LM5012DDAR **FINAL** 48V-51.6V to 6.00V @ 1.4A October 15, 2024 20:04:08 GMT-05:00

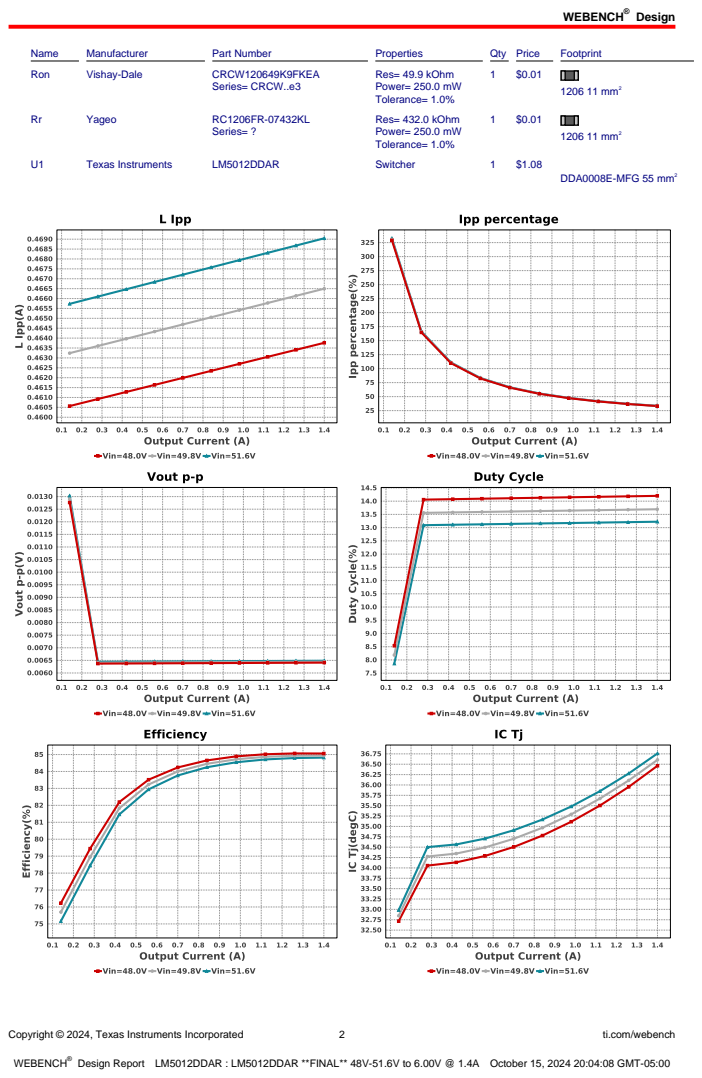
[picture p100: page 2]
Design; Copyright © 2024, Texas Instruments Incorporated; ti.com/webench; Name; Manufacturer; Part Number; Properties; Qty Price; Footprint; Ron; Vishay-Dale; CRCW120649K9FKEA; Series= CRCW..e3; Res= 49.9 kOhm Power= 250.0 mW Tolerance= 1.0%; 1206 11 mm²; Yageo; Series= ?; Res= 432.0 kOhm Power= 250.0 mW Tolerance= 1.0%; Texas Instruments; LM5012DDAR; Switcher; DDA0008E-MFG 55 mm²

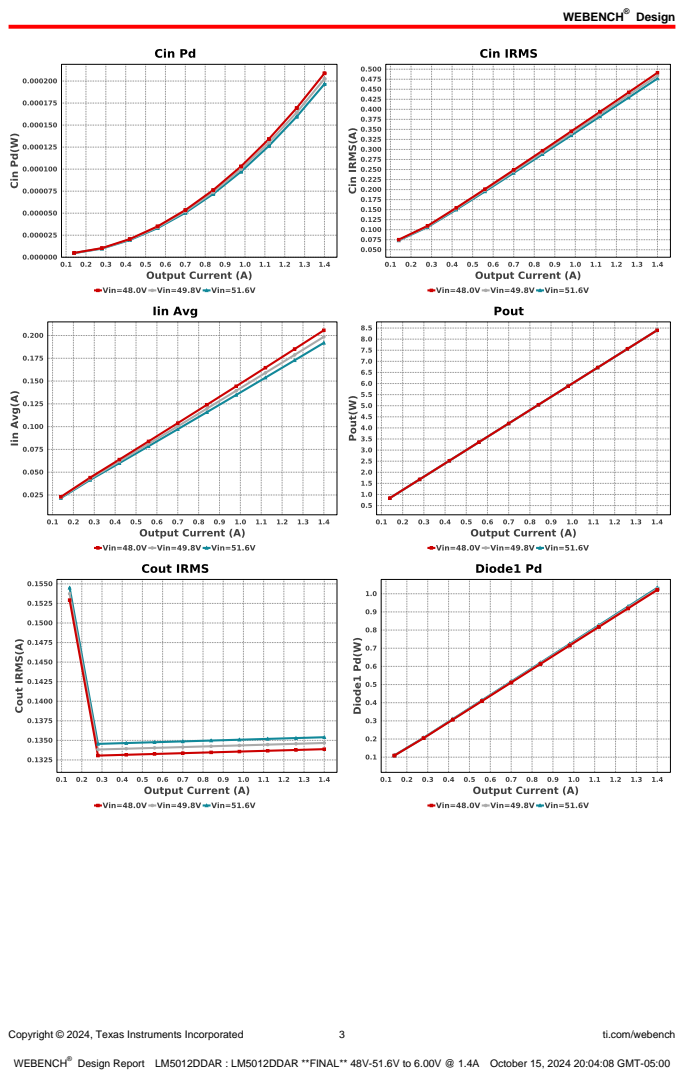
[picture p101: page 3]
Copyright © 2024, Texas Instruments Incorporated; ti.com/webench

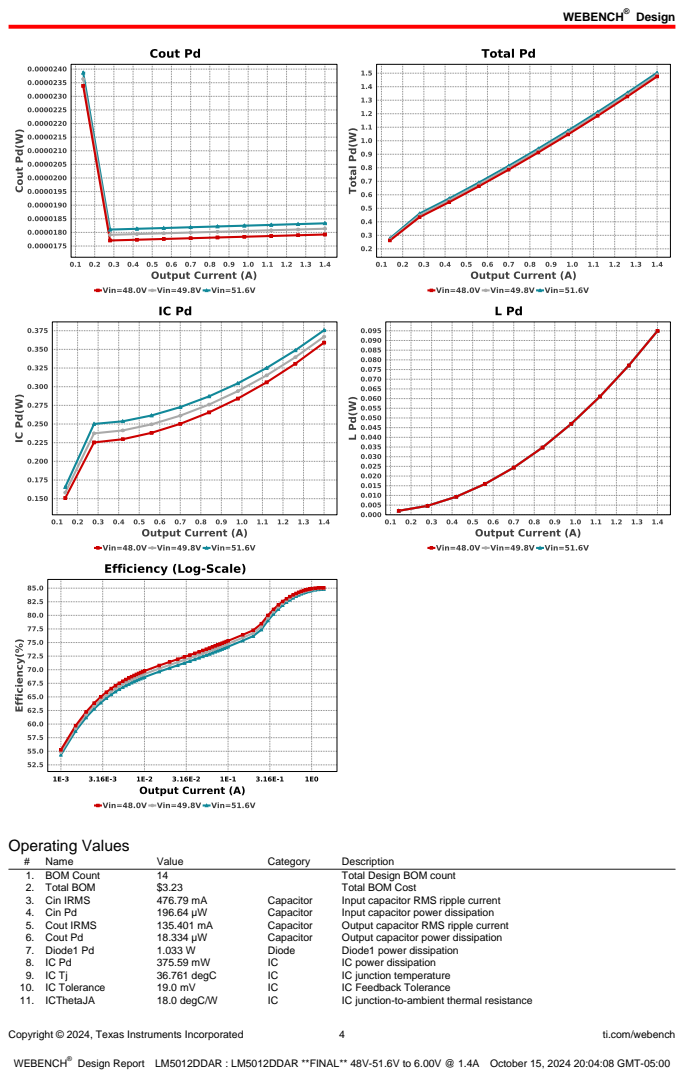
[picture p102: page 4]
Copyright © 2024, Texas Instruments Incorporated; ti.com/webench; Operating Values; Name; Value; Category; Description; 1. BOM Count; Total Design BOM count; 2. Total BOM; Total BOM Cost; 3. Cin IRMS; Capacitor; Input capacitor RMS ripple current; 4. Cin Pd; Input capacitor power dissipation; 5. Cout IRMS; Output capacitor RMS ripple current; 6. Cout Pd; Output capacitor power dissipation; 7. Diode1 Pd; Diode; Diode1 power dissipation; IC power dissipation; 36.761 degC; IC junction temperature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

Copyright © 2024, Texas Instruments Incorporated | 5 | ti.com/webench
# | Name | Value | Category | Description

12. Iin Avg | 191.93 mA | IC | Average input current
13. Ipp percentage | 33.503 % | Inductor | Inductor ripple current percentage (with respect to average inductor
| | | | current)
14. L Ipp | 469.044 mA | Inductor | Peak-to-peak inductor ripple current
15. L Pd | 94.96 mW | Inductor | Inductor power dissipation
16. Cin Pd | 196.64 µW | Power | Input capacitor power dissipation
17. Cout Pd | 18.334 µW | Power | Output capacitor power dissipation
18. Diode1 Pd | 1.033 W | Power | Diode1 power dissipation
19. IC Pd | 375.59 mW | Power | IC power dissipation
20. L Pd | 94.96 mW | Power | Inductor power dissipation
21. Total Pd | 1.504 W | Power | Total Power Dissipation
22. Duty Cycle | 13.223 % | System
| | | Information | Duty cycle
23. Efficiency | 84.818 % | System
| | | Information | Steady state efficiency
24. FootPrint | 470.0 mm² | System
| | | Information | Total Foot Print Area of BOM components
25. Frequency | 272.284 kHz | System
| | | Information | Switching frequency
26. Iout | 1.4 A | System
| | | Information | Iout operating point
27. Mode | CCM | System
| | | Information | Conduction Mode
28. Pout | 8.4 W | System
| | | Information | Total output power
29. Vin | 51.6 V | System
| | | Information | Vin operating point
30. Vout | 6.0 V | System
| | | Information | Operational Output Voltage
31. Vout Actual | 6.01 V | System
| | | Information | Vout Actual calculated based on selected voltage divider resistors
32. Vout Tolerance | 3.226 % | System
| | | Information | Vout Tolerance based on IC Tolerance (no load) and voltage divider resistors if applicable
33. Vout p-p | 6.485 mV | System
| | | Information | Peak-to-peak output ripple voltage

## Design Inputs

Name | Value | Description
Iout | 1.4 | Maximum Output Current
VinMax | 51.6 | Maximum input voltage
VinMin | 48.0 | Minimum input voltage
Vout | 6.0 | Output Voltage
| base_pn | | LM5012 | Base Product Number
source | DC | Input Source Type
Ta | 30.0 | Ambient temperature


Copyright © 2024, Texas Instruments Incorporated | 6 | ti.com/webench

## Assembly

## Component Testing

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

## Soldering Component to Board

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

## Initial Startup of Circuit

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

## Load Testing

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

## Design Assistance

1. Master key : 8D46410E296FCE97B33F99C6313555A5[v1]
2. LM5012 Product Folder : http://www.ti.com/product/LM5012 : contains the data sheet and other resources.

Copyright © 2024, Texas Instruments Incorporated | 7 | ti.com/webench

Important Notice and Disclaimer

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
