HomeboiWoods/403-ecen-cobot/404/Documents/Subsystem Integrations/MotorsUpdated.pdf

# TI Launchpad -

# >Final Board

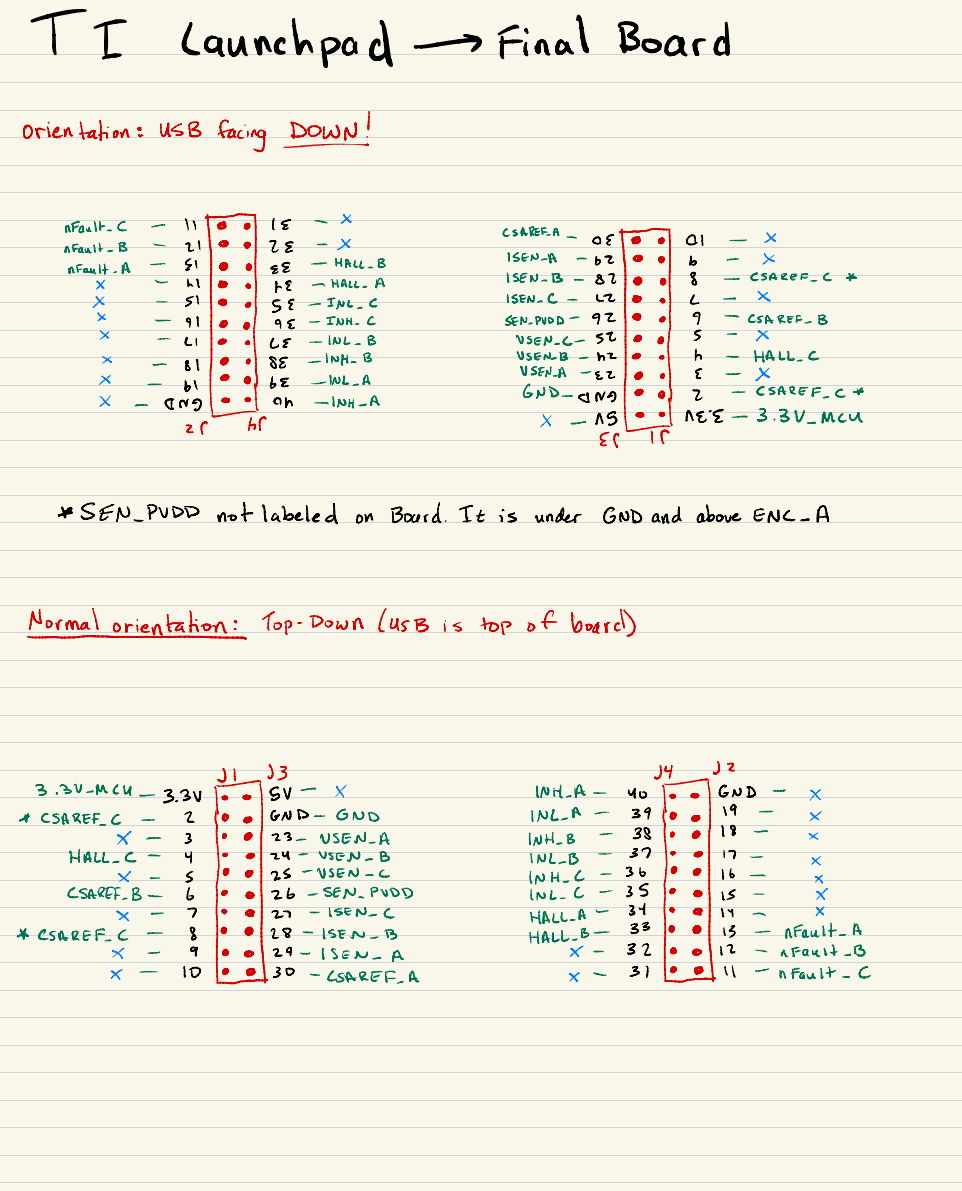
[picture p103: page 1]
orientation :; USB facingFun!; nFault_; CsAREF-A; nFault -; ISEN-A; nFault-A; ISEN-B-; CSAREF-; HALL-A; ISEN-C-; · SEN-PUDD-; CSAREF-B; USEN- -; -ma ⁻ INL _; USEN-B INH-B; HALL_; USEN-A; CSAREF_; GND-249; INH-A; -SEN_; PVDD not labeled on; Board.; under; GND and above ENC-A; Formal orientation :; Top-Down (USB is; too of board); INH-A -; GND; A- CSAREF_ C; USEN_; INH-; USEN -; INL_B -; so⁻SEN-; PUDD; ISEN-C; ISEN-B; Fault _B; CSAREF-A
