HomeboiWoods/403-ecen-cobot/404/Power Management/new board outlines/3V3_2.5A.pdf

## WEBENCH ® Design Report

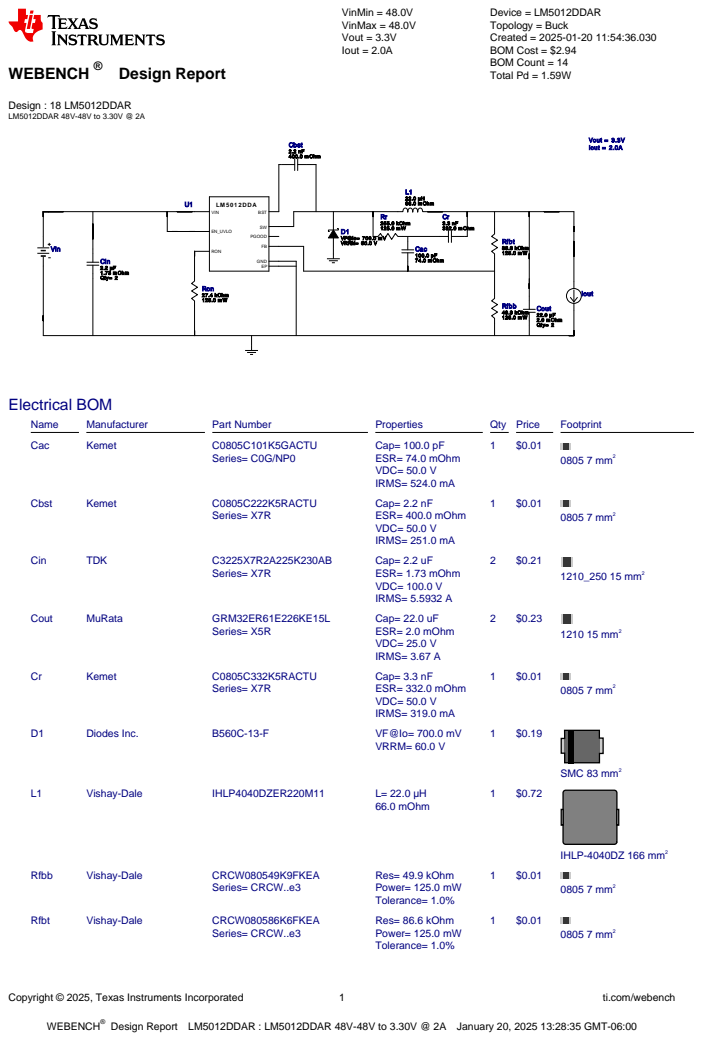
[picture p104: page 1]
Copyright © 2025, Texas Instruments Incorporated; ti.com/webench; WEBENCH®; Design : 18 LM5012DDAR LM5012DDAR 48V-48V to 3.30V @ 2A; VinMin = 48.0V VinMax = 48.0V Vout = 3.3V Iout = 2.0A; Device = LM5012DDAR Topology = Buck Created = 2025-01-20 11:54:36.030 BOM Cost = $2.94 BOM Count = 14 Total Pd = 1.59W; LM 5 0 1 2 DDA; GND; VIN; EN_UVLO; RON; PGOOD; BST; Cac 100.0 pF 74.0 m Ohm; Rr 255.0 kOhm 125.0 m W; Cr 3.3 nF 332.0 m Ohm; Cout 22.0 µF 2.0 m Ohm Qty= 2; L1 22.0 µH 66.0 m Ohm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

Design Report LM5012DDAR : LM5012DDAR 48V-48V to 3.30V @ 2A January 20, 2025 13:28:35 GMT-06:00

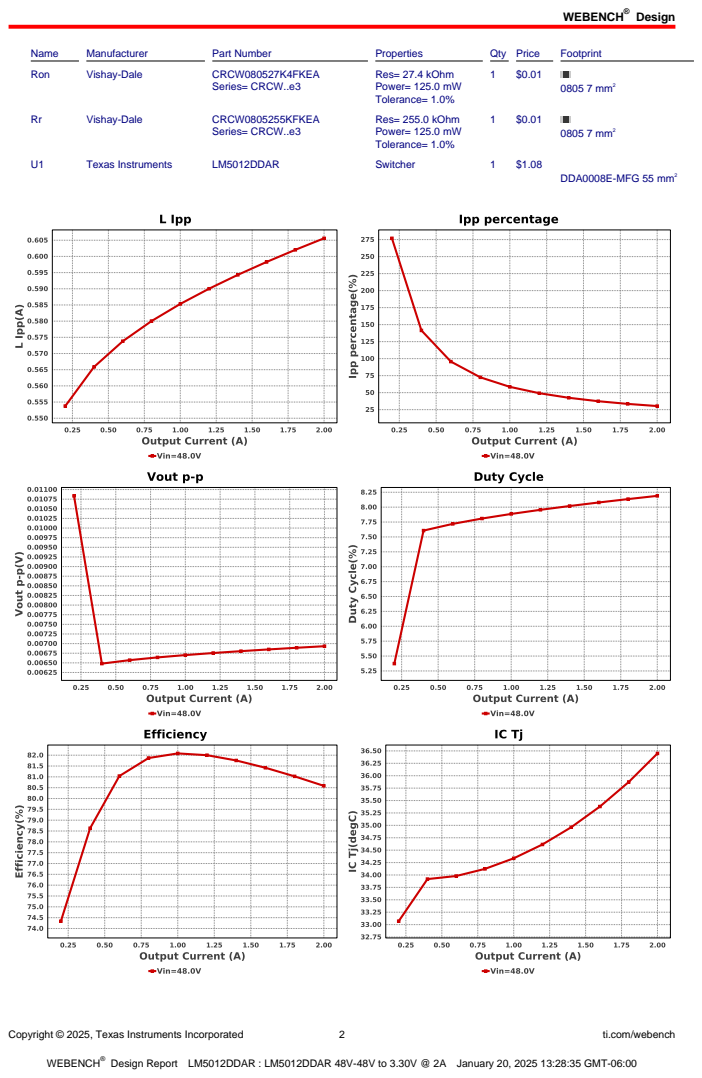
[picture p105: page 2]
Design; Copyright © 2025, Texas Instruments Incorporated; ti.com/webench; Name; Manufacturer; Part Number; Properties; Qty Price; Footprint; Ron; Vishay-Dale; CRCW080527K4FKEA; Series= CRCW..e3; Res= 27.4 kOhm Power= 125.0 mW Tolerance= 1.0%; 0805 7 mm²; CRCW0805255KFKEA; Res= 255.0 kOhm Power= 125.0 mW Tolerance= 1.0%; Texas Instruments; LM5012DDAR; Switcher; DDA0008E-MFG 55 mm²

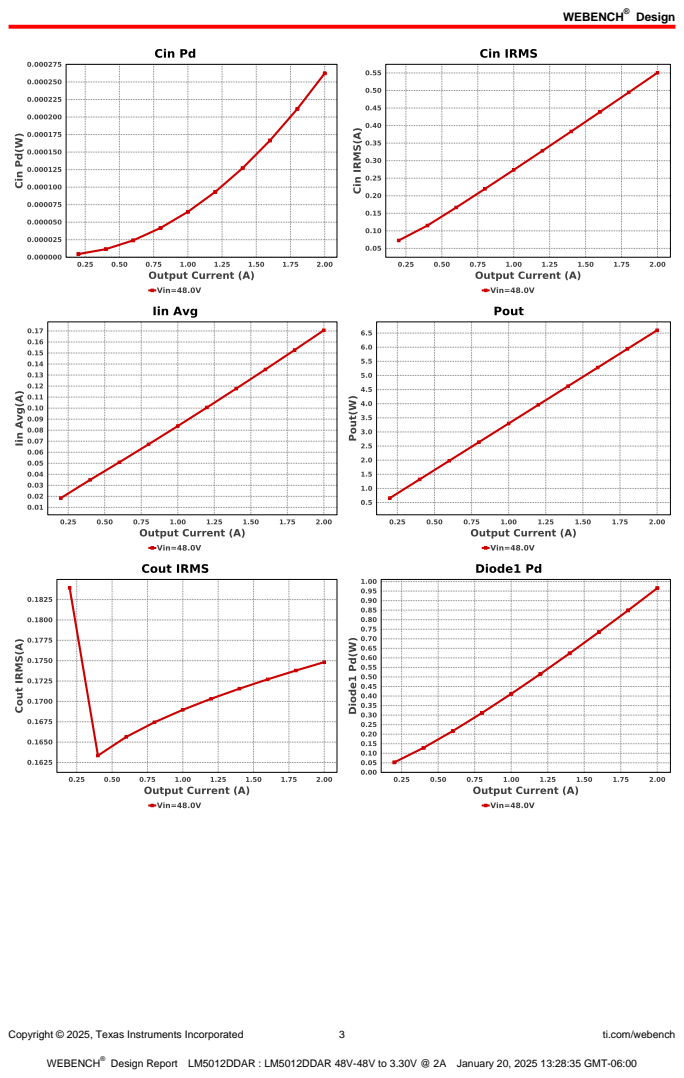
[picture p106: page 3]
Copyright © 2025, Texas Instruments Incorporated; ti.com/webench

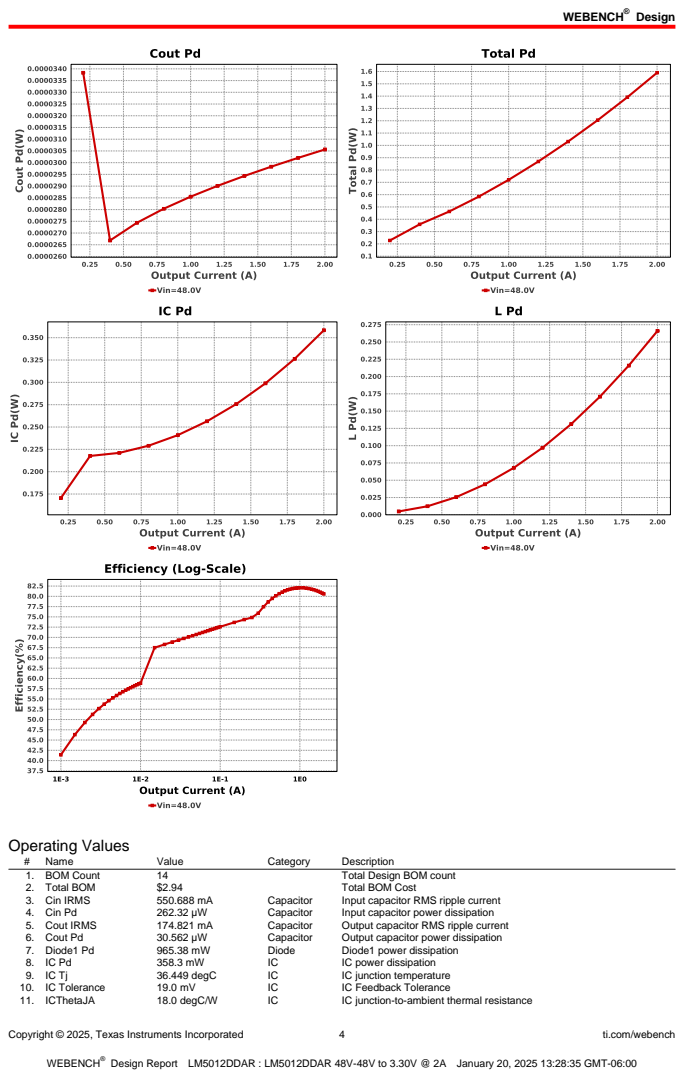
[picture p107: page 4]
Copyright © 2025, Texas Instruments Incorporated; ti.com/webench; Operating Values; Name; Value; Category; Description; 1. BOM Count; Total Design BOM count; 2. Total BOM; Total BOM Cost; 3. Cin IRMS; Capacitor; Input capacitor RMS ripple current; 4. Cin Pd; Input capacitor power dissipation; 5. Cout IRMS; Output capacitor RMS ripple current; 6. Cout Pd; Output capacitor power dissipation; 7. Diode1 Pd; Diode; Diode1 power dissipation; IC power dissipation; 36.449 degC; IC junction temperature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

Copyright © 2025, Texas Instruments Incorporated | 5 | ti.com/webench
# | Name | Value | Category | Description

12. Iin Avg | 170.63 mA | IC | Average input current
13. Ipp percentage | 30.28 % | Inductor | Inductor ripple current percentage (with respect to average inductor
| | | | current)
14. L Ipp | 605.596 mA | Inductor | Peak-to-peak inductor ripple current
15. L Pd | 266.02 mW | Inductor | Inductor power dissipation
16. Cin Pd | 262.32 µW | Power | Input capacitor power dissipation
17. Cout Pd | 30.562 µW | Power | Output capacitor power dissipation
18. Diode1 Pd | 965.38 mW | Power | Diode1 power dissipation
19. IC Pd | 358.3 mW | Power | IC power dissipation
20. L Pd | 266.02 mW | Power | Inductor power dissipation
21. Total Pd | 1.59 W | Power | Total Power Dissipation
22. Duty Cycle | 8.19 % | System
| | | Information | Duty cycle
23. Efficiency | 80.585 % | System
| | | Information | Steady state efficiency
24. FootPrint | 411.0 mm² | System
| | | Information | Total Foot Print Area of BOM components
25. Frequency | 272.731 kHz | System
| | | Information | Switching frequency
26. Iout | 2.0 A | System
| | | Information | Iout operating point
27. Mode | CCM | System
| | | Information | Conduction Mode
28. Pout | 6.6 W | System
| | | Information | Total output power
29. Vin | 48.0 V | System
| | | Information | Vin operating point
30. Vout | 3.3 V | System
| | | Information | Operational Output Voltage
31. Vout Actual | 3.283 V | System
| | | Information | Vout Actual calculated based on selected voltage divider resistors
32. Vout Tolerance | 2.885 % | System
| | | Information | Vout Tolerance based on IC Tolerance (no load) and voltage divider resistors if applicable
33. Vout p-p | 6.932 mV | System
| | | Information | Peak-to-peak output ripple voltage

## Design Inputs

Name | Value | Description
Iout | 2.0 | Maximum Output Current
VinMax | 48.0 | Maximum input voltage
VinMin | 48.0 | Minimum input voltage
Vout | 3.3 | Output Voltage
| base_pn | | LM5012 | Base Product Number
source | DC | Input Source Type
Ta | 30.0 | Ambient temperature


Copyright © 2025, Texas Instruments Incorporated | 6 | ti.com/webench

## Assembly

## Component Testing

Some published data on components in datasheets such as Capacitor ESR and Inductor DC resistance is based on conservative values that will guarantee that the components always exceed the specification. For design purposes it is usually better to work with typical values. Since this data is not always available it is a good practice to measure the Capacitance and ESR values of Cin and Cout, and the inductance and DC resistance of L1 before assembly of the board. Any large discrepancies in values should be electrically simulated in WEBENCH to check for instabilities and thermally simulated in WebTHERM to make sure critical temperatures are not exceeded.

## Soldering Component to Board

If board assembly is done in house it is best to tack down one terminal of a component on the board then solder the other terminal. For surface mount parts with large tabs, such as the DPAK, the tab on the back of the package should be pre-tinned with solder, then tacked into place by one of the pins. To solder the tab town to the board place the iron down on the board while resting against the tab, heating both surfaces simultaneously. Apply light pressure to the top of the plastic case until the solder flows around the part and the part is flush with the PCB. If the solder is not flowing around the board you may need a higher wattage iron (generally 25W to 30W is enough).

## Initial Startup of Circuit

It is best to initially power up the board by setting the input supply voltage to the lowest operating input voltage 48.0V and set the input supply's current limit to zero. With the input supply off connect up the input supply to Vin and GND. Connect a digital volt meter and a load if needed to set the minimum Iout of the design from Vout and GND. Turn on the input supply and slowly turn up the current limit on the input supply.
If the voltage starts to rise on the input supply continue increasing the input supply current limit while watching the output voltage. If the current increases on the input supply, but the voltage remains near zero, then there may be a short or a component misplaced on the board. Power down the board and visually inspect for solder bridges and recheck the diode and capacitor polarities. Once the power supply circuit is operational then more extensive testing may include full load testing, transient load and line tests to compare with simulation results.

## Load Testing

The setup is the same as the initial startup, except that an additional digital voltmeter is connected between Vin and GND, a load is connected between Vout and GND and a current meter is connected in series between Vout and the load. The load must be able to handle at least rated output power + 50% ( 7.5 watts for this design). Ideally the load is supplied in the form of a variable load test unit. It can also be done in the form of suitably large power resistors. When using an oscilloscope to measure waveforms on the prototype board, the ground leads of the oscilloscope probes should be as short as possible and the area of the loop formed by the ground lead should be kept to a minimum. This will help reduce ground lead inductance and eliminate EMI noise that is not actually present in the circuit.

## Design Assistance

1. Master key : 8D46410E296FCE97B33F99C6313555A5[v1]
2. LM5012 Product Folder : http://www.ti.com/product/LM5012 : contains the data sheet and other resources.

Copyright © 2025, Texas Instruments Incorporated | 7 | ti.com/webench

Important Notice and Disclaimer

TI provides technical and reliability data (including datasheets), design resources (including reference designs), application or other design advice, web tools, safety information, and other resources AS IS and with all faults, and disclaims all warranties. These resources are intended for skilled developers designing with TI products. You are solely responsible for (1) selecting the appropriate TI products for your application, (2) designing, validating and testing your application, and (3) ensuring your application meets applicable standards, and any other safety, security, or other requirements.

These resources are subject to change without notice. TI grants you permission to use these resources only for development of an application that uses the TI products described in the resource. Other reproduction and display of these resources is prohibited. No license is granted to any other TI intellectual property right or to any third party intellectual property right. TI disclaims responsibility for, and you will fully indemnify TI and its representatives against, any claims, damages, costs, losses, and liabilities arising out of your use of these resources.

Providing these resources does not expand or otherwise alter TI's applicable Terms of Sale or other applicable terms available either on ti.com or provided in conjunction with TI products.
