HomeboiWoods/403-ecen-cobot/403/Mobile Application Subsystem/Altium/tmp/Board to Check.pdf

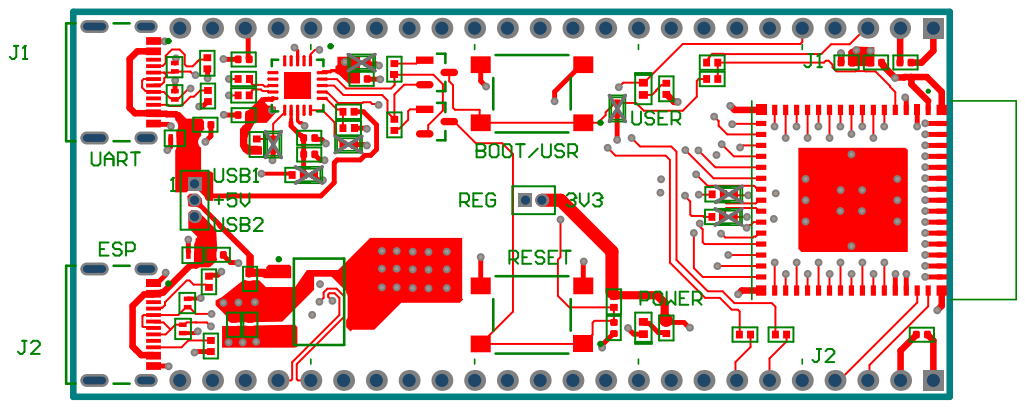
[picture p112: page 1]

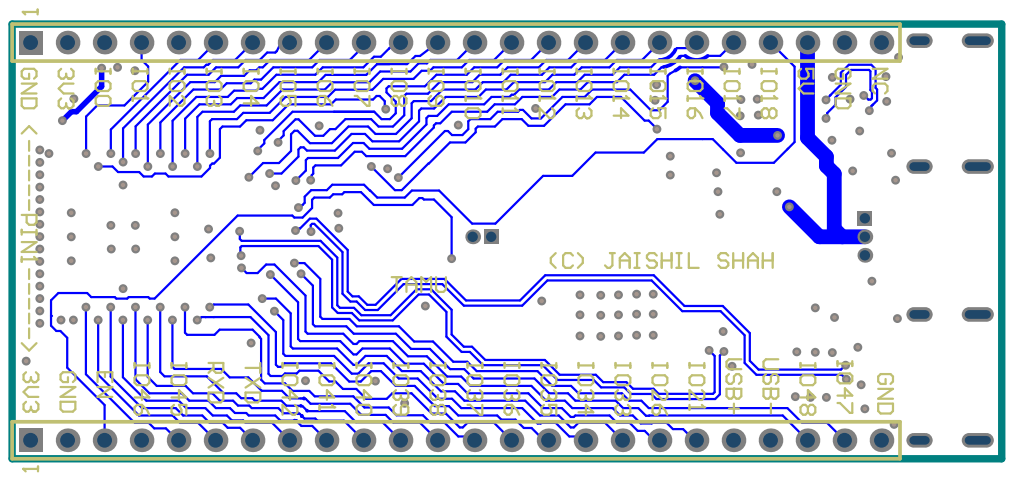
[picture p113: page 2]
