HomeboiWoods/403-ecen-cobot/(list of files, drawings)

Other design files:
403/Documents (old)/MotorDocuments/CobotProject/CobotProject.PrjPcb
403/Documents (old)/MotorDocuments/CobotProject/MD_Power.SchDoc
403/Documents (old)/MotorDocuments/CobotProject/middleManBoard.SchDoc
403/Documents (old)/MotorDocuments/CobotProject/molexMiniFitJr_component.PcbLib
403/Documents (old)/MotorDocuments/CobotProject/molexMiniFitJr_component.SchLib
403/Documents (old)/MotorDocuments/CobotProject/motorBoardSchematic1.SchDoc
403/Documents (old)/MotorDocuments/CobotProject/MotorDriver_Schematics.SchDoc
403/Documents (old)/MotorDocuments/CobotProject/MotorDriverEvalBoard.SchDoc
403/Mobile Application Subsystem/Altium/3D/AC0402FR-0710KL/AC0402FR-0710KL.SchLib
403/Mobile Application Subsystem/Altium/3D/AC0402FR-0710KL/RESC1005X37N.PcbLib
403/Mobile Application Subsystem/Altium/3D/CL05A105KL5NRNC/CAPC1005X55N.PcbLib
403/Mobile Application Subsystem/Altium/3D/CL05A105KL5NRNC/CL05A105KL5NRNC.SchLib
403/Mobile Application Subsystem/Altium/ESP32 with USBC.PcbDoc
403/Mobile Application Subsystem/Altium/ESP32 with USBC.PrjPcb
403/Mobile Application Subsystem/Altium/ESP32 with USBC.SchDoc
403/Mobile Application Subsystem/Altium/PcbLib.PcbLib
403/Mobile Application Subsystem/Altium/Schlib.Schlib
403/Mobile Application Subsystem/Altium/tmp/217179-0001.PcbLib.PcbLib
403/Mobile Application Subsystem/Altium/tmp/217179-0001.SchLib.SchLib
403/Mobile Application Subsystem/Altium/tmp/ESP32-S3-MINI-1-N8/ESP32-S3-MINI-1-N8.SchLib
403/Mobile Application Subsystem/Altium/tmp/ESP32-S3-MINI-1-N8/XCVR_ESP32-S3-MINI-1-N8.PcbLib
403/Mobile Application Subsystem/Altium/tmp/FT231XQ-R.PcbLib.PcbLib
403/Mobile Application Subsystem/Altium/tmp/FT231XQ-R.SchLib.SchLib
403/Mobile Application Subsystem/Altium/tmp/PTS645SH50SMTR92LFS.PcbLib.PcbLib
403/Mobile Application Subsystem/Altium/tmp/PTS645SH50SMTR92LFS.SchLib.SchLib
403/Mobile Application Subsystem/Altium/tmp/SS8050-G.PcbLib.PcbLib
403/Mobile Application Subsystem/Altium/tmp/SS8050-G.SchLib.SchLib
403/Mobile Application Subsystem/Altium/tmp/TL1963A-33DCYR.PcbLib.PcbLib
403/Mobile Application Subsystem/Altium/tmp/TL1963A-33DCYR.SchLib.SchLib
403/Subsystem Introduction Projects/Adrian Guzman/Non_Inverting_OpAmp.SchDoc
403/Subsystem Introduction Projects/Adrian Guzman/Non_Inverting_Opamp_PCB.PcbDoc
403/Subsystem Introduction Projects/Ethan Woods/ECEN403Parts.SchLib
403/Subsystem Introduction Projects/Ethan Woods/ECEN403PartsPCB.PcbLib
403/Subsystem Introduction Projects/Ethan Woods/InvertingOpAmp.PcbDoc
403/Subsystem Introduction Projects/Ethan Woods/InvertingOpAmp.SchDoc
403/Subsystem Introduction Projects/Ethan Woods/SubsystemIntroductionProject.PrjPcb
