HomeboiWoods/403-ecen-cobot/(commit log)

2024-10-09 added Ethan Woods' subsystem intro project
    [ECEN403Parts.SchLib, ECEN403PartsPCB.PcbLib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]
2024-10-09 adding motor documents into github
2024-10-18 uploaded altium design files for inital motor pcbs
    [CobotProject.PrjPcb, MD_Power.SchDoc, MotorDriverEvalBoard.SchDoc, MotorDriver_Schematics.SchDoc, middleManBoard.SchDoc, molexMiniFitJr_component.PcbLib, molexMiniFitJr_component.SchLib, motorBoardSchematic1.SchDoc]
2024-10-18 deleting files adrian put in cuz i got them in a folder
    [MD_Power.SchDoc, Motor Driver.SchDoc]
2024-11-01 adding blinky and motor text files to github
2024-11-10 Create Arduino Code
2025-04-14 major file system changes. compressed into 403 and 404 folders
    [022284245.stp, 12V1A.csv, 12V1A.xlsx, 12V2mA.csv, 12V2mA.xlsx, 217179-0001.PcbLib.PcbLib, 217179-0001.SchLib.SchLib, 24V1A.csv]
2025-04-14 Create BLDC Motor Code
2025-04-14 Update BLDC Motor Code
2025-04-14 Create SERVO Motor Code
