HomeboiWoods/403-ecen-cobot/(notices)

Notices in the files:
403/Mobile Application Subsystem/Altium/3D/FTS-103-01-F-S.stp:
author */ ('License CC BY-ND 4.0'),
